michelkeijzers/FuzzTester2/FreeCad/PedalSwitch/images/dd879e173b59c8a97e29d3d8e20ef851_preview_featured.jpg

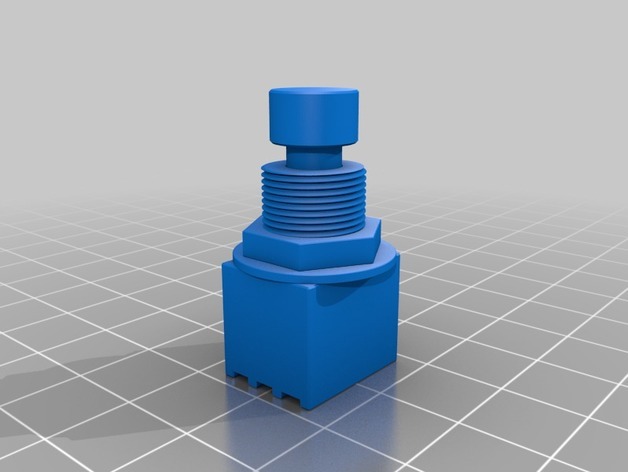
FreeCad/PedalSwitch/images/dd879e173b59c8a97e29d3d8e20ef851_preview_featured.jpg
