michelkeijzers/FuzzTester2/FreeCad/PedalSwitch/README.txt

                   .:                     :,                                          
,:::::::: ::`      :::                   :::                                          
,:::::::: ::`      :::                   :::                                          
.,,:::,,, ::`.:,   ... .. .:,     .:. ..`... ..`   ..   .:,    .. ::  .::,     .:,`   
   ,::    :::::::  ::, :::::::  `:::::::.,:: :::  ::: .::::::  ::::: ::::::  .::::::  
   ,::    :::::::: ::, :::::::: ::::::::.,:: :::  ::: :::,:::, ::::: ::::::, :::::::: 
   ,::    :::  ::: ::, :::  :::`::.  :::.,::  ::,`::`:::   ::: :::  `::,`   :::   ::: 
   ,::    ::.  ::: ::, ::`  :::.::    ::.,::  :::::: ::::::::: ::`   :::::: ::::::::: 
   ,::    ::.  ::: ::, ::`  :::.::    ::.,::  .::::: ::::::::: ::`    ::::::::::::::: 
   ,::    ::.  ::: ::, ::`  ::: ::: `:::.,::   ::::  :::`  ,,, ::`  .::  :::.::.  ,,, 
   ,::    ::.  ::: ::, ::`  ::: ::::::::.,::   ::::   :::::::` ::`   ::::::: :::::::. 
   ,::    ::.  ::: ::, ::`  :::  :::::::`,::    ::.    :::::`  ::`   ::::::   :::::.  
                                ::,  ,::                               ``             
                                ::::::::                                              
                                 ::::::                                               
                                  `,,`

http://www.thingiverse.com/thing:2292921
True Bypass pedal switch  by TwistedStick is licensed under the Creative Commons - Attribution license.
http://creativecommons.org/licenses/by/3.0/

# Summary

Full scale model of a True Bypass type foot switch as used in lots of guitar effects pedals. The first file prints as 1 piece.
