michelkeijzers/FuzzTester2/FreeCad/AlphaPots/Renderings/456654.JPG

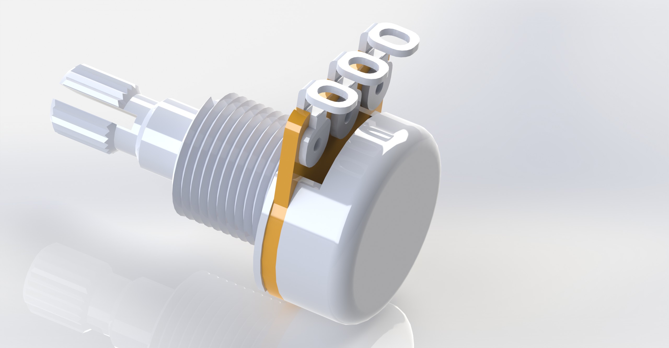
FreeCad/AlphaPots/Renderings/456654.JPG
