michelkeijzers/FuzzTester2/FreeCad/AlphaPots/Renderings/POTENCIOMETRO.JPG

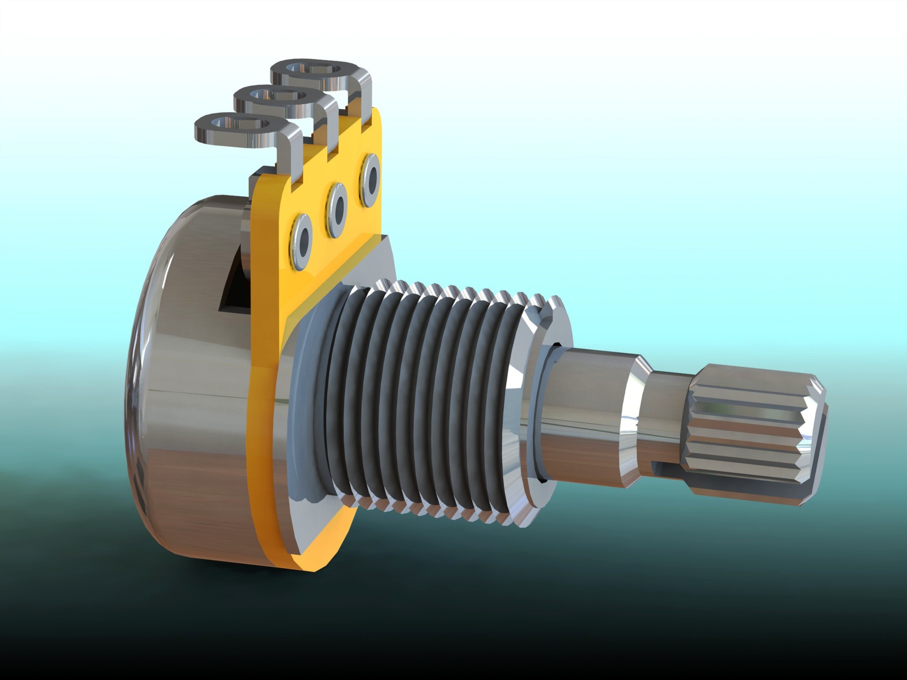
FreeCad/AlphaPots/Renderings/POTENCIOMETRO.JPG
