michelkeijzers/FuzzTester2/FreeCad/PedalSwitch/images/05e3b247a3be7e0a02b4cb6af5f122b1_preview_featured.jpg

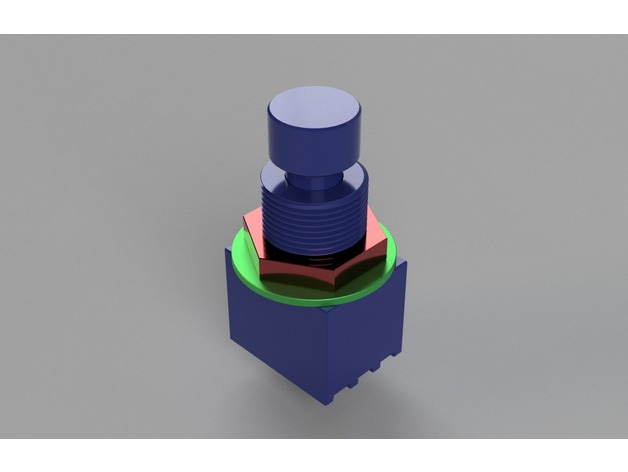
FreeCad/PedalSwitch/images/05e3b247a3be7e0a02b4cb6af5f122b1_preview_featured.jpg
