michelkeijzers/FuzzTester2/FreeCad/PedalSwitch/images/3989a1540667a814e102567b238ad827_preview_featured.jpg

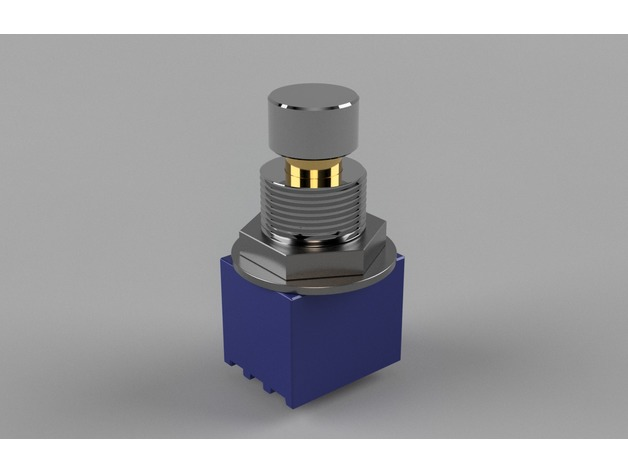
FreeCad/PedalSwitch/images/3989a1540667a814e102567b238ad827_preview_featured.jpg
