michelkeijzers/FuzzTester2/FreeCad/PedalSwitch/images/55707fd7501c3c675dcfab593f32f3b3_preview_featured.jpg

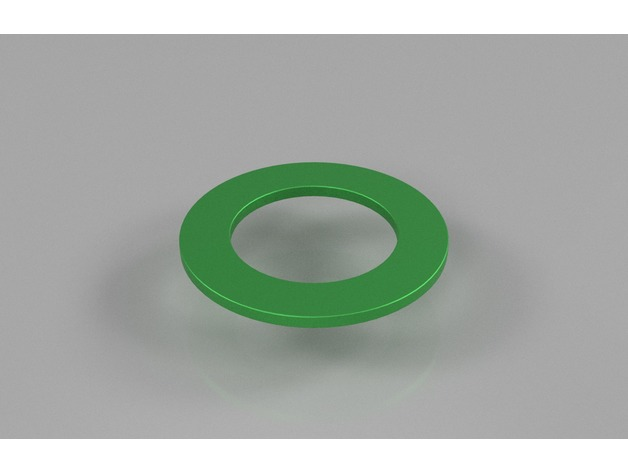
FreeCad/PedalSwitch/images/55707fd7501c3c675dcfab593f32f3b3_preview_featured.jpg
