michelkeijzers/FuzzTester2/FreeCad/PedalSwitch/images/a3924953580c51a55e30400ac69dec9f_preview_featured.jpg

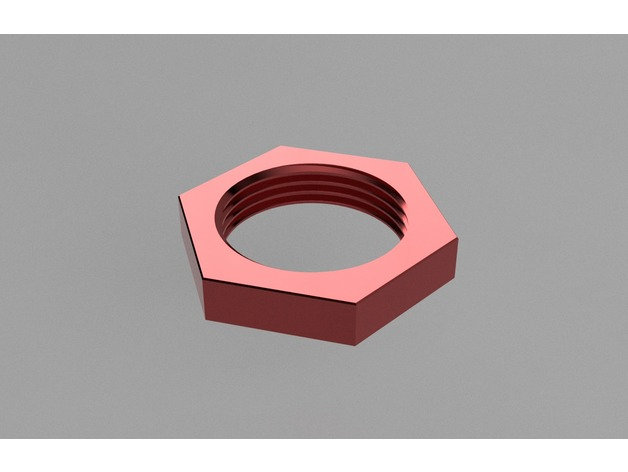
FreeCad/PedalSwitch/images/a3924953580c51a55e30400ac69dec9f_preview_featured.jpg
