michelkeijzers/FuzzTester2/FreeCad/PedalSwitch/images/c648ea8e05c5eb92dedfe1f4923e9194_preview_featured.jpg

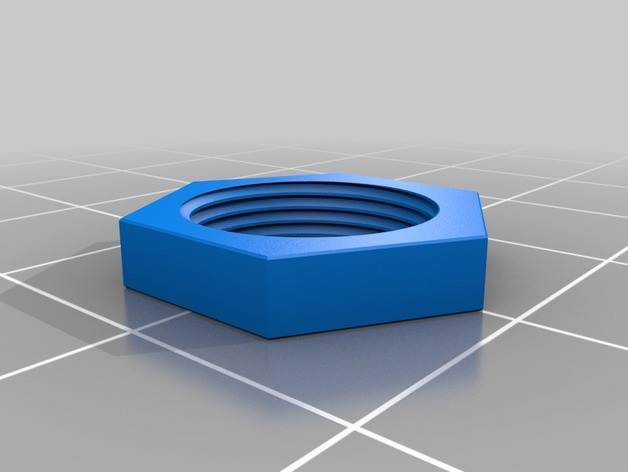
FreeCad/PedalSwitch/images/c648ea8e05c5eb92dedfe1f4923e9194_preview_featured.jpg
