michelkeijzers/FuzzTester2/FreeCad/PedalSwitch/images/ecceebd9bc1541b14651f7d918a18b3a_preview_featured.jpg

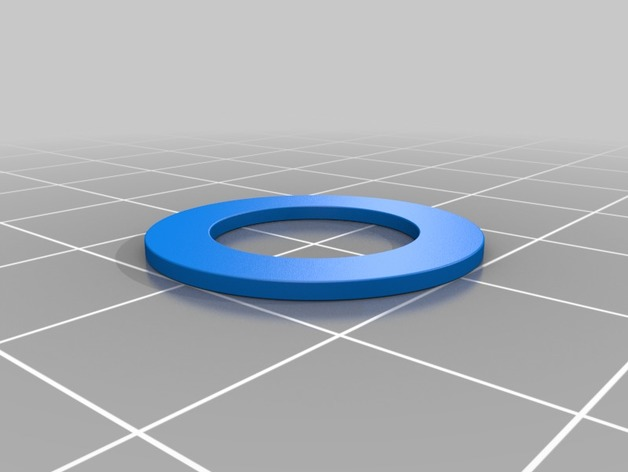
FreeCad/PedalSwitch/images/ecceebd9bc1541b14651f7d918a18b3a_preview_featured.jpg
