michelkeijzers/FuzzTester2/FreeCad/Square Push Buttons.jpg

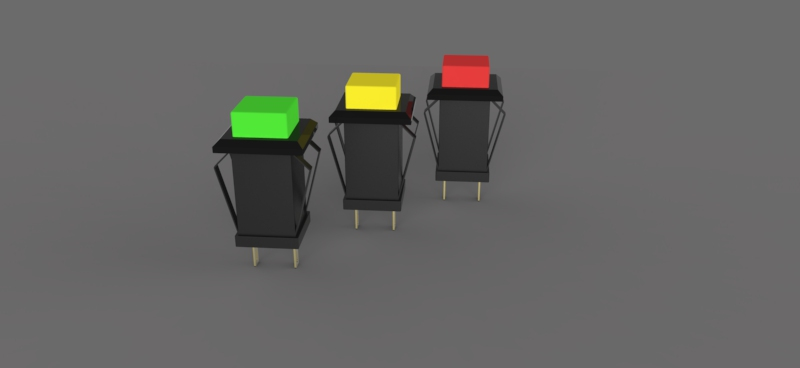
FreeCad/Square Push Buttons.jpg
