michelkeijzers/FuzzTester2/FreeCad/STM32F103C8T6 Black Pill/STM32F103C8T6 Black Pill Technical drawing.png

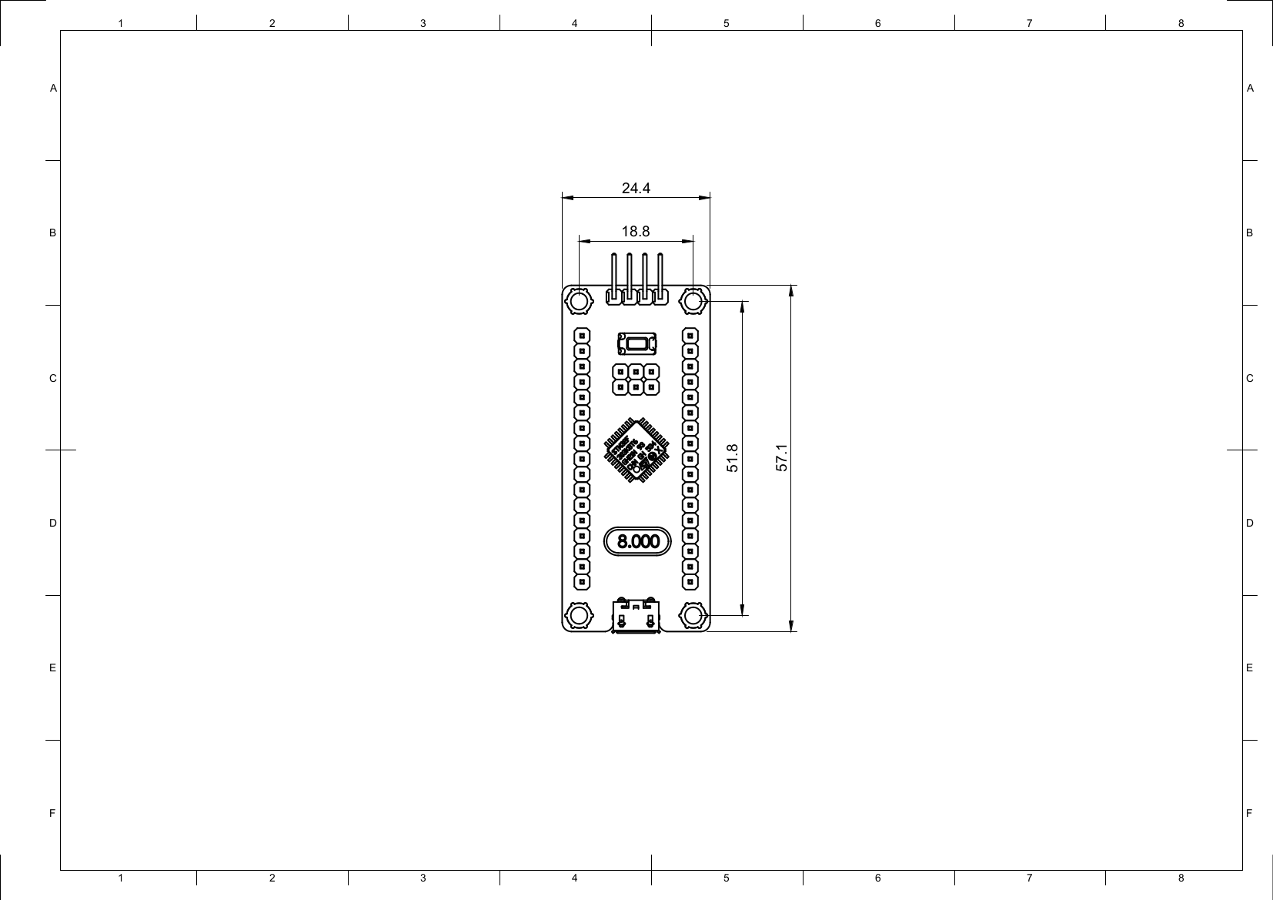
FreeCad/STM32F103C8T6 Black Pill/STM32F103C8T6 Black Pill Technical drawing.png
