michelkeijzers/FuzzTester2/FreeCad/dc-power-supply-panel-mount-jack-2-1mm-x-5-5mm-1.snapshot.6/DC Jack Panel Mount ASSY.STEP

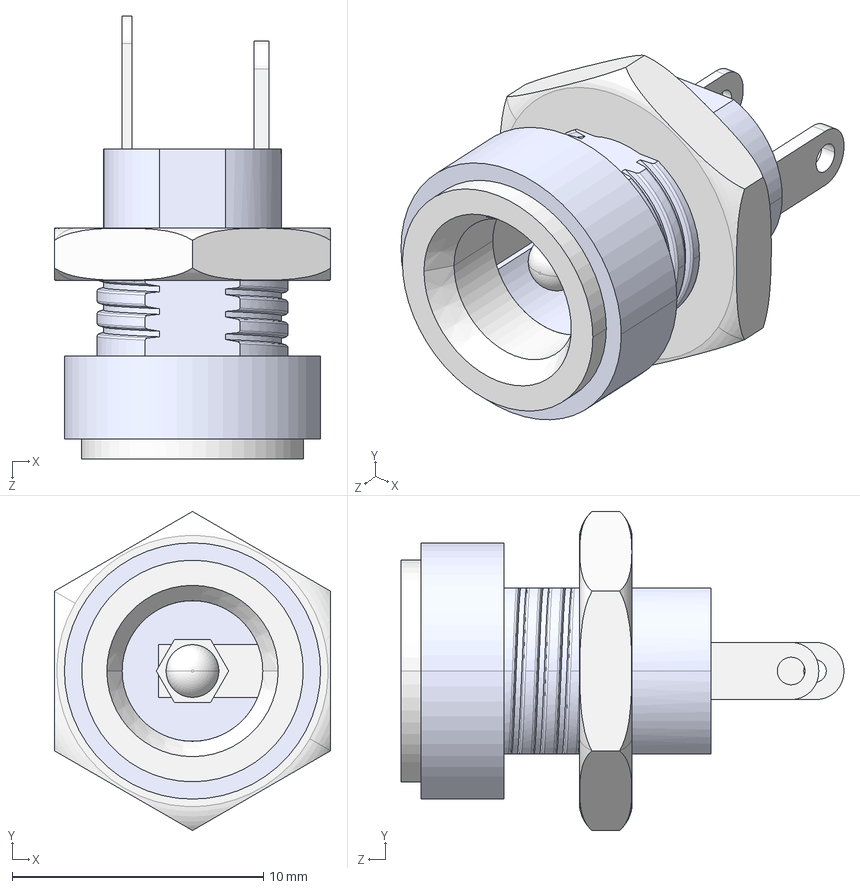
[picture p34: CAD file, 2020-05-08]
FreeCad/dc-power-supply-panel-mount-jack-2-1mm-x-5-5mm-1.snapshot.6/DC Jack Panel Mount ASSY.STEP
11.0 x 12.7 x 17.6 mm
DC Jack Panel Mount Base
DC Jack Panel Mount Nut
