michelkeijzers/FuzzTester2/FreeCad/PedalSwitch/files/truBypass-main-to_print.stl

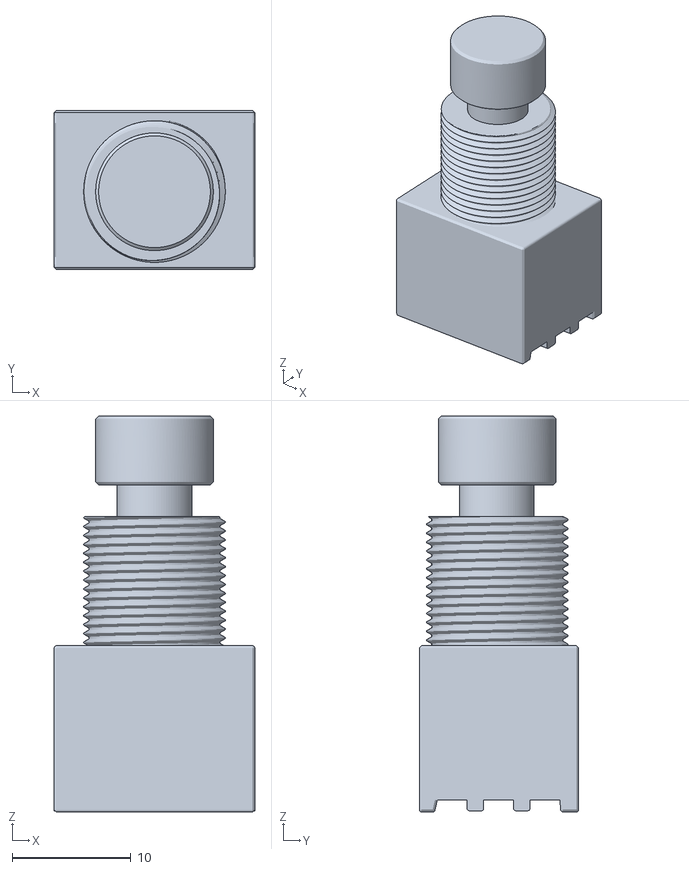
[picture p35: CAD file, 2020-05-08]
FreeCad/PedalSwitch/files/truBypass-main-to_print.stl
16.9 x 13.4 x 33.3
