michelkeijzers/FuzzTester2/FreeCad/wh148Pot/Assem1.SLDASM

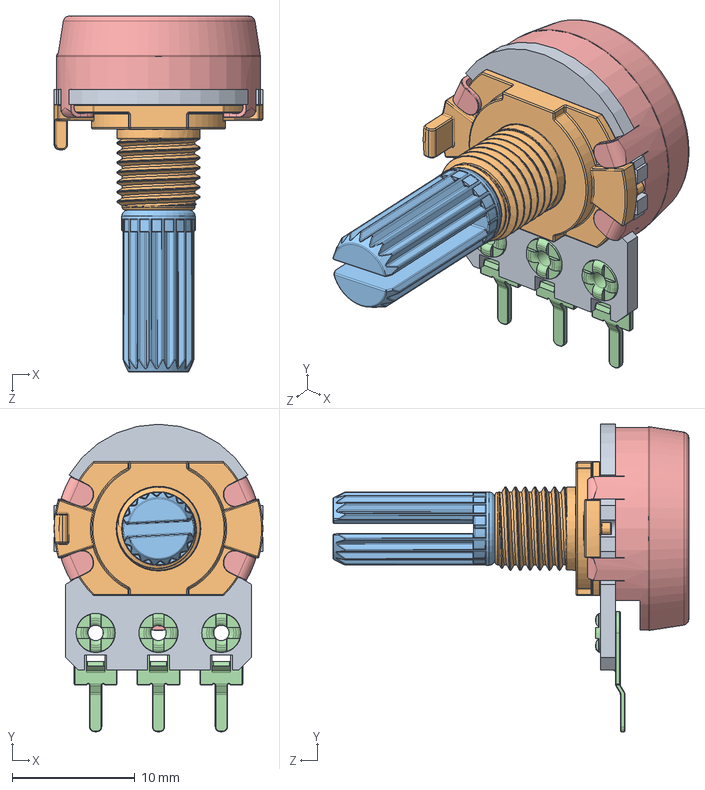
[picture p36: CAD file, 2020-05-08]
FreeCad/wh148Pot/Assem1.SLDASM
17.0 x 25.1 x 29.0 mm
pcb board
base metal
rotating rod metal
pin x 3
sheild metal
plastic base
