michelkeijzers/FuzzTester2/FreeCad/User Library-Jack6_3 Asm.STEP

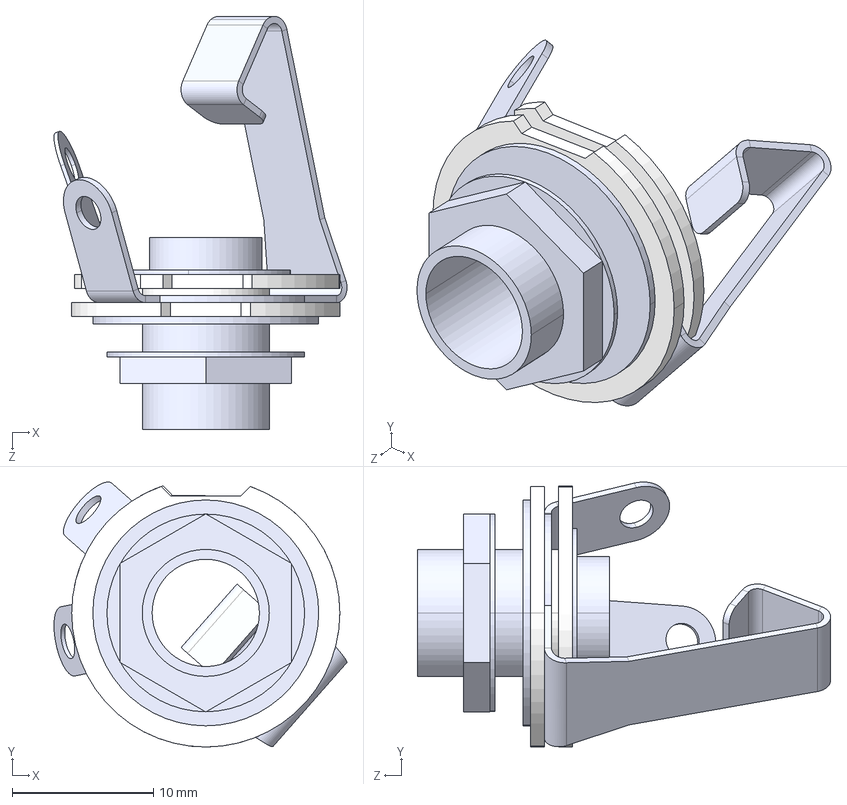
[picture p37: CAD file, 2020-05-08]
FreeCad/User Library-Jack6_3 Asm.STEP
20.8 x 18.8 x 29.3 mm
Jack6.3body___ _________
Washer0___ _________
OuterWasher___ _________
Nut___ _________
Washer1___ _________
Washer2___ _________
CentralContact___ _________
GroundContact___ _________
