michelkeijzers/FuzzTester2/FreeCad/1590C.stp

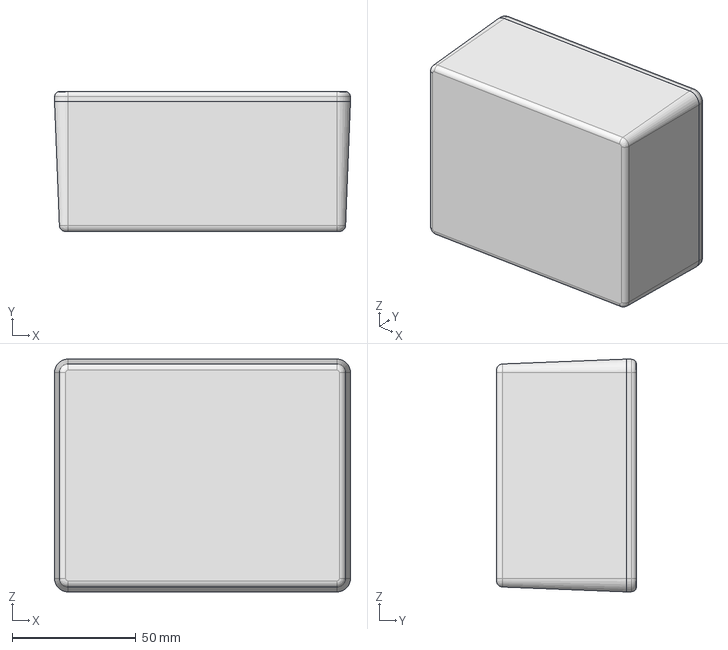
[picture p38: CAD file, 2020-05-08]
FreeCad/1590C.stp
119.5 x 56.5 x 94.0 mm
