michelkeijzers/FuzzTester2/FreeCad/AlphaPots/Stereo_Pot.IGS

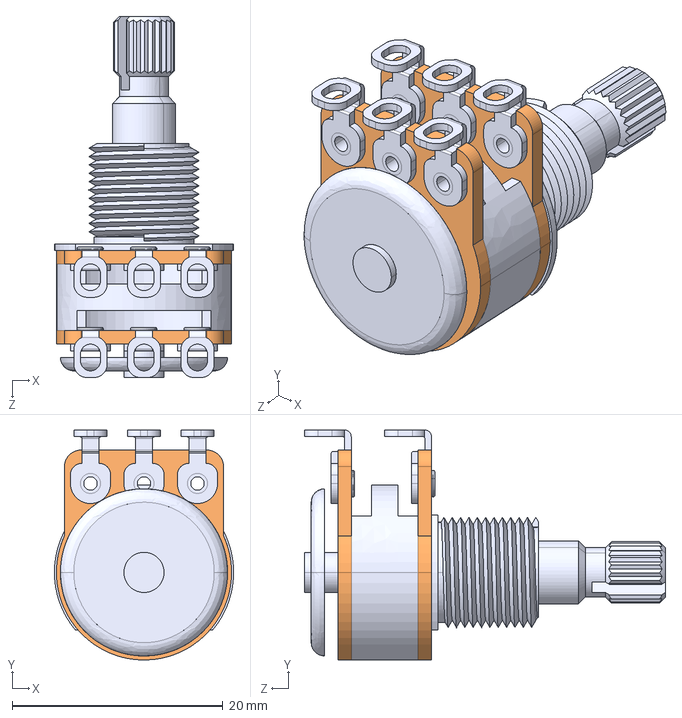
[picture p39: CAD file, 2020-05-08]
FreeCad/AlphaPots/Stereo_Pot.IGS
17.0 x 21.8 x 34.3 mm
