michelkeijzers/FuzzTester2/FreeCad/lcm1602c-lcd-display-16x2-1.snapshot.8/lcm1602c.SLDPRT

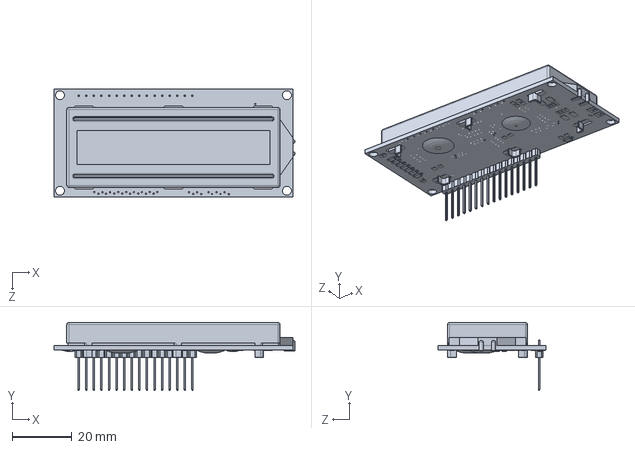
[picture p40: CAD file, 2020-05-08]
FreeCad/lcm1602c-lcd-display-16x2-1.snapshot.8/lcm1602c.SLDPRT
80.7 x 22.8 x 36.0 mm
