michelkeijzers/FuzzTester2/FreeCad/potmeterknob/Knob.step

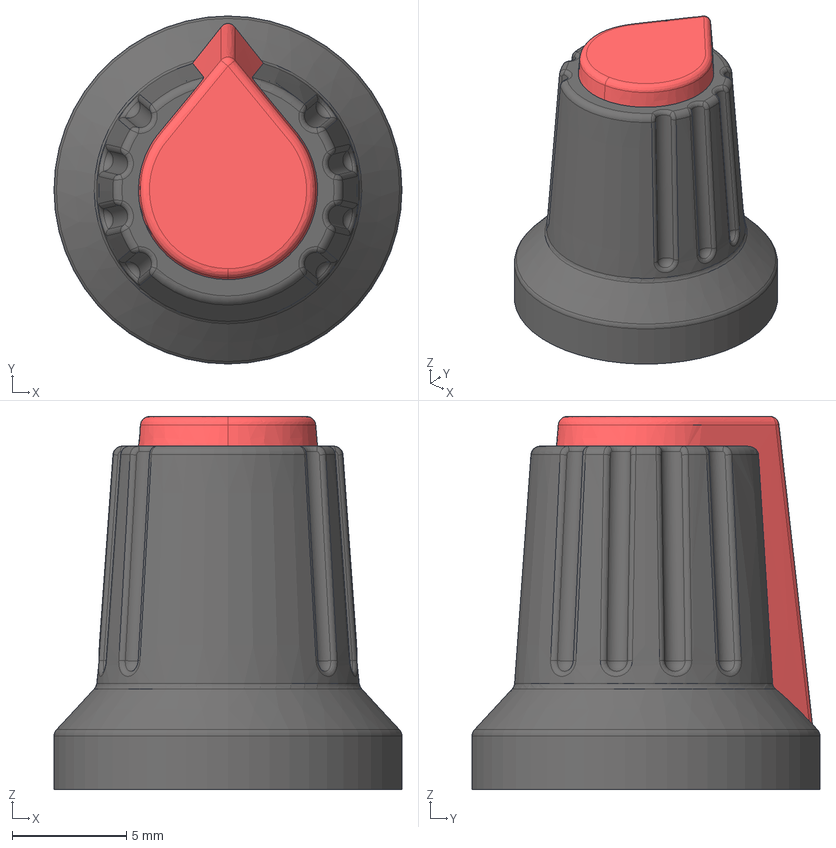
[picture p41: CAD file, 2020-05-08]
FreeCad/potmeterknob/Knob.step
15.2 x 15.2 x 16.3 mm
Rouge
Extérieur
