michelkeijzers/FuzzTester2/FreeCad/wh148Pot/plastic base.SLDPRT

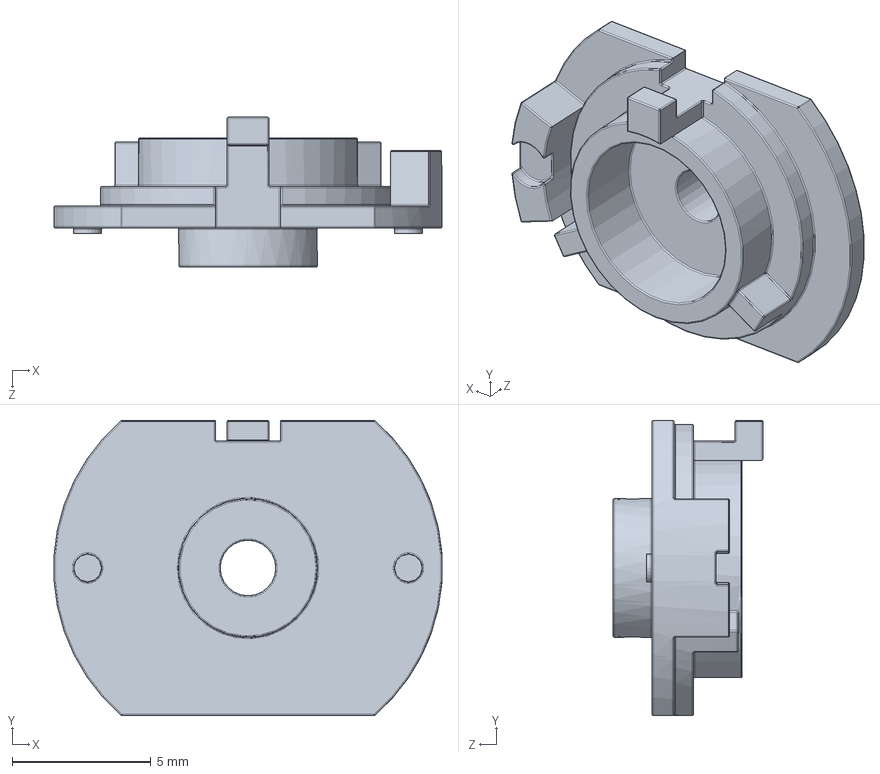
[picture p42: CAD file, 2020-05-08]
FreeCad/wh148Pot/plastic base.SLDPRT
14.0 x 10.6 x 5.40 mm
