michelkeijzers/FuzzTester2/FreeCad/AlphaPots/Switch_Pot_Small_Shaft.IGS

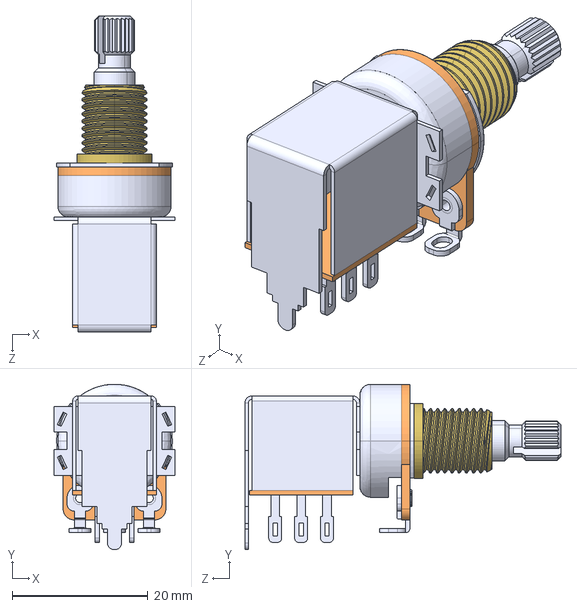
[picture p43: CAD file, 2020-05-08]
FreeCad/AlphaPots/Switch_Pot_Small_Shaft.IGS
17.8 x 24.3 x 46.5 mm
