michelkeijzers/FuzzTester2/FreeCad/dc-power-supply-panel-mount-jack-2-1mm-x-5-5mm-1.snapshot.6/DC Jack Panel Mount Base.SLDPRT

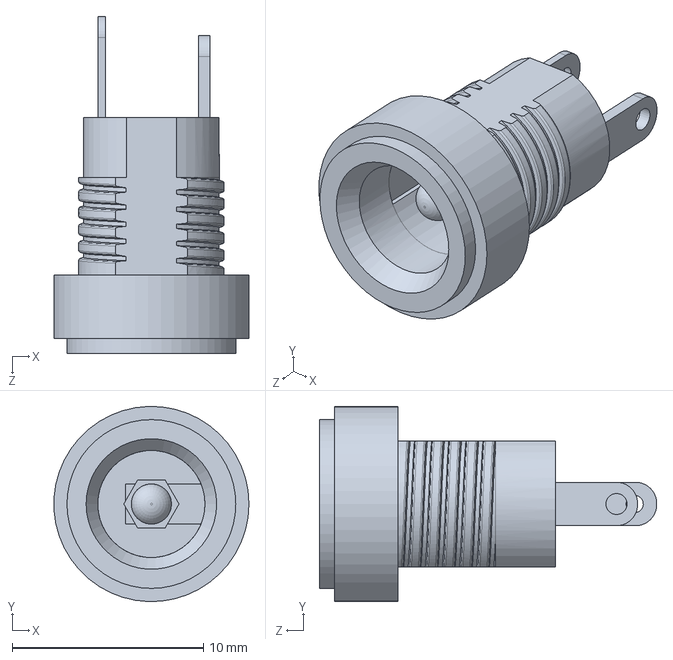
[picture p44: CAD file, 2020-05-08]
FreeCad/dc-power-supply-panel-mount-jack-2-1mm-x-5-5mm-1.snapshot.6/DC Jack Panel Mount Base.SLDPRT
10.2 x 10.2 x 17.6 mm
