michelkeijzers/FuzzTester2/FreeCad/Push button square.SLDPRT

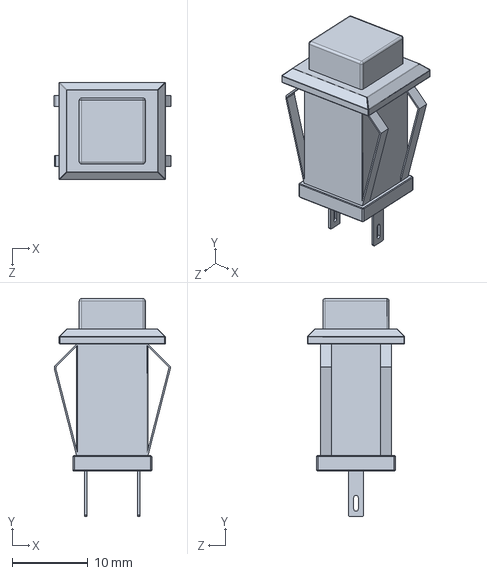
[picture p45: CAD file, 2020-05-08]
FreeCad/Push button square.SLDPRT
15.3 x 28.7 x 12.8 mm
