michelkeijzers/FuzzTester2/FreeCad/AlphaPots/Single_Pot.IGS

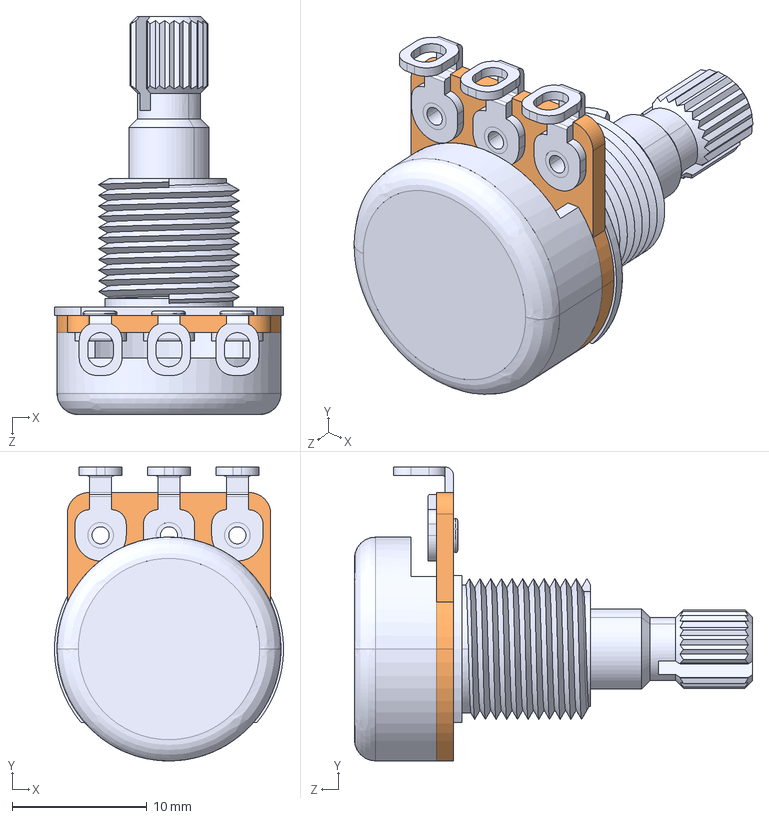
[picture p46: CAD file, 2020-05-08]
FreeCad/AlphaPots/Single_Pot.IGS
17.0 x 21.8 x 29.6 mm
