michelkeijzers/FuzzTester2/FreeCad/PedalSwitch/files/truBypass-to_print.stl

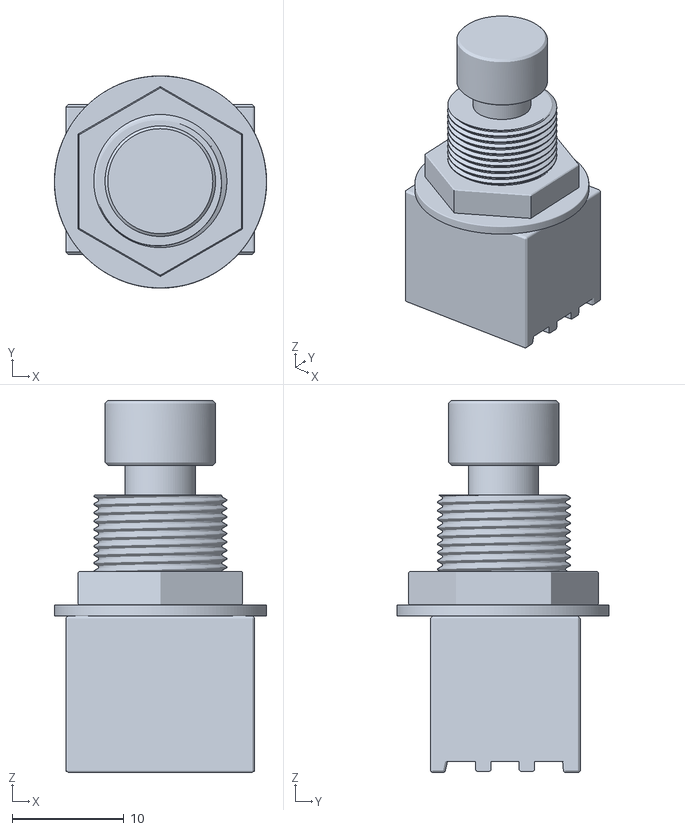
[picture p47: CAD file, 2020-05-08]
FreeCad/PedalSwitch/files/truBypass-to_print.stl
19.0 x 19.0 x 33.3
