michelkeijzers/FuzzTester2/FreeCad/wh148Pot/pcb board.SLDPRT

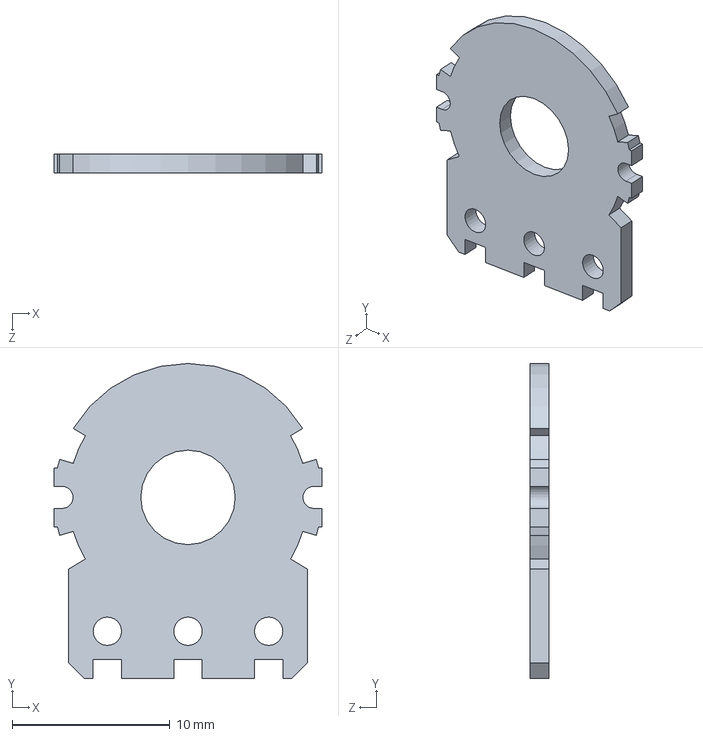
[picture p48: CAD file, 2020-05-08]
FreeCad/wh148Pot/pcb board.SLDPRT
17.0 x 20.0 x 1.20 mm
