michelkeijzers/FuzzTester2/FreeCad/KS11R22CQD.step

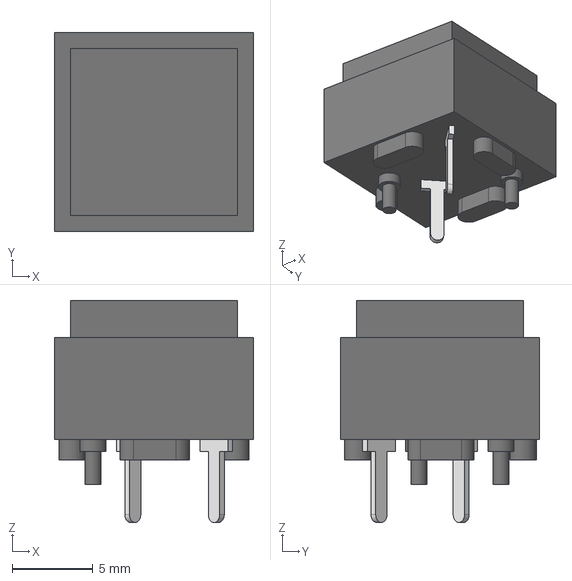
[picture p49: CAD file, 2020-05-08]
FreeCad/KS11R22CQD.step
12.3 x 12.3 x 13.7 mm
