michelkeijzers/FuzzTester2/FreeCad/wh148Pot/sheild metal.SLDPRT

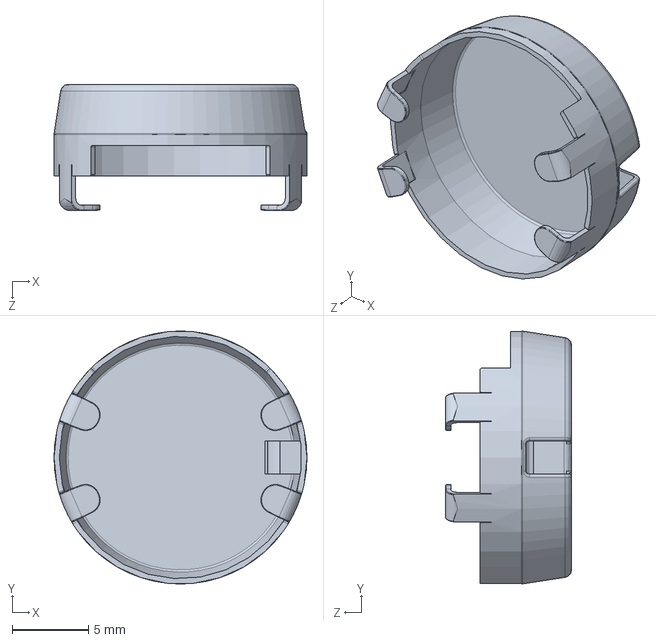
[picture p50: CAD file, 2020-05-08]
FreeCad/wh148Pot/sheild metal.SLDPRT
16.6 x 16.6 x 8.28 mm
