michelkeijzers/FuzzTester2/FreeCad/wh148Pot/base metal.SLDPRT

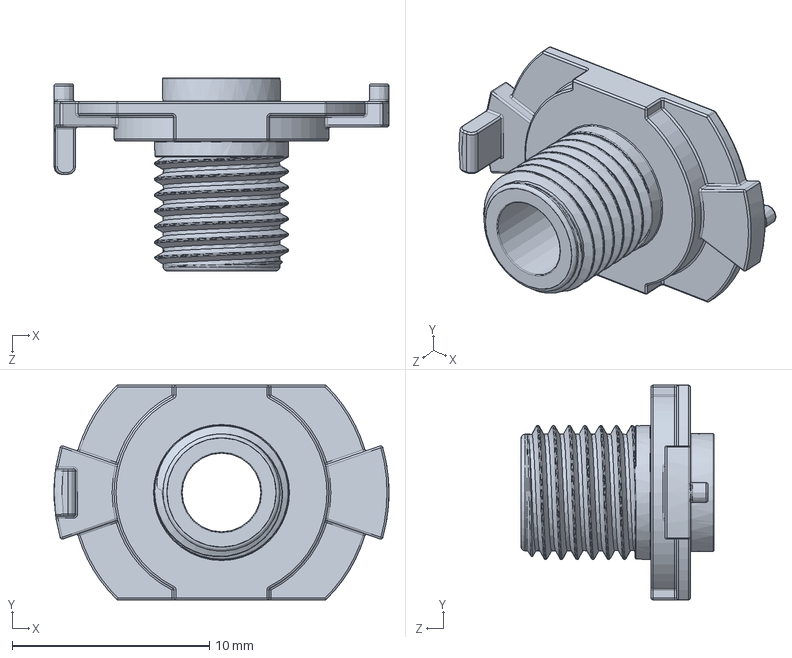
[picture p51: CAD file, 2020-05-08]
FreeCad/wh148Pot/base metal.SLDPRT
17.0 x 10.9 x 9.80 mm
