michelkeijzers/FuzzTester2/FreeCad/wh148Pot/rotating rod metal.SLDPRT

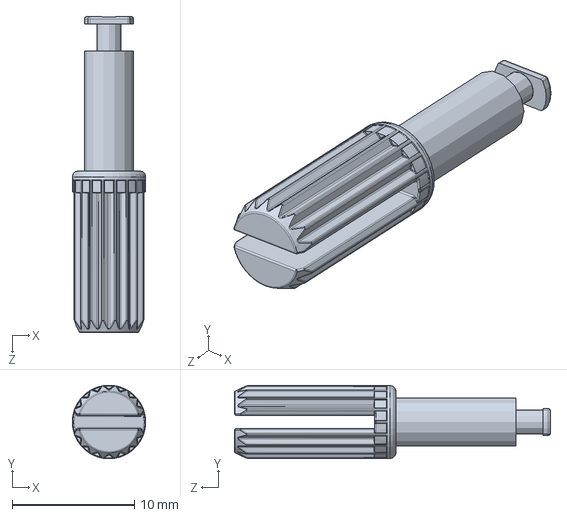
[picture p52: CAD file, 2020-05-08]
FreeCad/wh148Pot/rotating rod metal.SLDPRT
6.00 x 6.00 x 25.8 mm
