michelkeijzers/FuzzTester2/FreeCad/wh148Pot/pin.SLDPRT

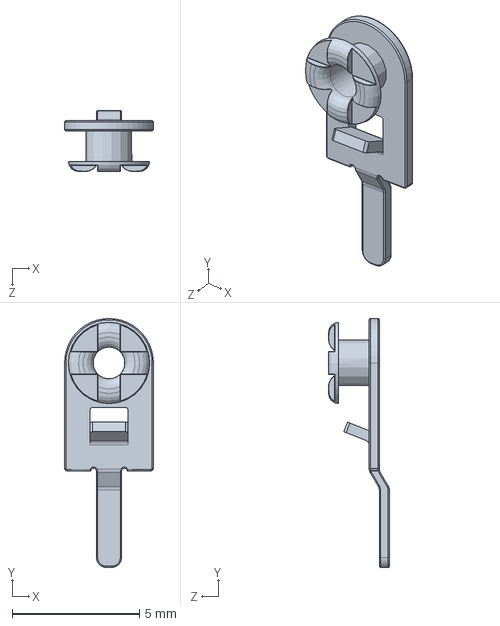
[picture p53: CAD file, 2020-05-08]
FreeCad/wh148Pot/pin.SLDPRT
3.50 x 9.80 x 2.40 mm
