michelkeijzers/FuzzTester2/(list of files, cad)

Other CAD files:
FreeCad/1590C.igs
FreeCad/PedalSwitch/files/truBypass-nut-to_print.stl
FreeCad/PedalSwitch/files/truBypass-washer-to_print.stl
FreeCad/User Library-Jack6_3 Asm.IGS
FreeCad/dc-power-supply-panel-mount-jack-2-1mm-x-5-5mm-1.snapshot.6/DC Jack Panel Mount ASSY.SLDASM
FreeCad/dc-power-supply-panel-mount-jack-2-1mm-x-5-5mm-1.snapshot.6/DC Jack Panel Mount ASSY.SLDPRT
FreeCad/dc-power-supply-panel-mount-jack-2-1mm-x-5-5mm-1.snapshot.6/DC Jack Panel Mount Nut.SLDPRT
FreeCad/potmeterknob/Knob.f3d
FreeCad/potmeterknob/Knob.iges
