michelkeijzers/FuzzTester2/FuzzTester2/Core/TODO.txt

Critical bugs/problems
----------------------
- LCD bug: LCD stops during startup (I2C Initialization problem, see Github, question asked at electronics.stack.exchange).

Nice to have
----
- Button: Swap subscriber index and debounce time
- LCD improvement: only send changed characters (copy characters from display in array, costs 4x20 = 80 bytes max), but goto-xy also takes time
