michelkeijzers/FuzzTester2/MicroCap/Fuzz 1000 Faces Original Simple 2.cir

[Main]
FileType=CIR
Version=12.00
Program=Micro-Cap
Component Version=10.00
Shape Version=11.00
Screen=1920,1200
MCAPVersion=12.2.0.3
Key ID=Demo
NLCnt=60
TXCnt=0

[shapedef]
Name=Animated SPST Switch
Animated SPST Switch=0,-8,48,8
Current=16,8,32,8

[shapedef]
Name=Battery
Line=0,0,22,0
Line=22,-3,22,3
Line=26,-7,26,7
Line=26,0,48,0
Current=32,8,16,8

[shapedef]
Name=Bjt.root
Line=0,0,13,0
Rectangle=13,-12,15,12
Current=32,-24,32,-16
Current=32,24,32,16
Current=0,-8,8,-8
PolyOpen=3
PolyLine=24,-24
PolyLine=24,-12
PolyLine=14,-2
PolyOpen=3
PolyLine=24,24
PolyLine=24,12
PolyLine=14,2

[shapedef]
Name=Capacitor
Line=0,0,22,0
Line=22,-8,22,8
Line=26,-8,26,8
Line=26,0,48,0
Current=32,12,16,12

[shapedef]
Name=Ground
Line=0,0,12,0
Line=12,-8,12,8
Line=18,-4,18,4
Line=24,0,24,0

[shapedef]
Name=NPN
Root="Bjt.root",0,0,0
PolyClosed=3
PolyLine=20,12
PolyLine=24,12
PolyLine=24,8

[shapedef]
Name=Plus.root
Line=-2,0,2,0
Line=0,-2,0,2

[shapedef]
Name=Pot
Line=0,0,12,0
Line=12,0,14,-4
Line=14,-4,18,4
Line=18,4,22,-4
Line=22,-4,26,4
Line=26,4,30,-4
Line=30,-4,34,4
Line=34,4,36,0
Line=36,0,48,0
PolyClosed=4
PolyLine=24,4
PolyLine=24,4
PolyLine=22,8
PolyLine=26,8
Line=24,8,24,16

[shapedef]
Name=Resistor
PolyOpen=12
PolyLine=0,0
PolyLine=0,0
PolyLine=12,0
PolyLine=14,-4
PolyLine=18,4
PolyLine=22,-4
PolyLine=26,4
PolyLine=30,-4
PolyLine=34,4
PolyLine=36,0
PolyLine=48,0
PolyLine=48,0
Current=32,8,16,8

[shapedef]
Name=Sine_Source
Root="Vsource.root",0,0,0
Line=24,-6,26,-4
Line=26,-4,26,-2
Line=26,-2,22,2
Line=22,2,22,4
Line=22,4,24,6

[shapedef]
Name=Vsource.root
Line=0,0,12,0
Line=36,0,48,0
Ellipse=12,-12,36,12
FColor=None
Line=7,5,7,9
Root="Plus.root",41,7,0
Current=32,16,16,16

[compdef]
Name=Sine Source
Definition=Sine source
Shape=Sine_Source
Mask=4864
memo=Sine Source
Label Offset=18,12,15,12
PinCnt=2
Pin="Plus",6,0,-6,-6
Pin="Minus",0,0,-19,-6

[compdef]
Name=Capacitor
Definition=Capacitor
Shape=Capacitor
Mask=7425
Used=62
memo=Capacitor
Label Offset=16,12,12,12
PinCnt=2
Pin="Plus",6,0,-3,-5
Pin="Minus",0,0,-14,-5

[compdef]
Name=NPN
Definition=NPN
Shape=NPN
Mask=5633
Used=62
memo=NPN Transistor
Label Offset=37,-17,-14,33
PinCnt=3
Pin="Collector",3,-3,4,14
Pin="Base",0,0,-18,-3
Pin="Emitter",3,3,5,1

[compdef]
Name=Resistor
Definition=Resistor
Shape=Resistor
Mask=6913
Used=152
memo=Resistor
Label Offset=18,6,8,11
PinCnt=2
Pin="Plus",6,0,-10,-4
Pin="Minus",0,0,-14,-4

[compdef]
Name=Pot
Definition=Macro
Shape=Pot
Mask=4096
Used=6
memo=Potentiometer Macro
Label Offset=32,4,9,11
PinCnt=3
Pin="PINA",a,0,0,-13,-5
Pin="PINB",a,3,2,6,5
Pin="PINC",a,6,0,-12,-5

[compdef]
Name=Ground
Definition=Ground
Shape=Ground
Mask=1793
Used=263
memo=Ground
Label Offset=0,0,0,0
PinCnt=1
Pin="PinA",0,0,-3,-7

[compdef]
Name=Battery
Definition=Battery
Shape=Battery
Mask=6145
Used=52
memo=Battery
Label Offset=19,7,10,13
PinCnt=2
Pin="Plus",6,0,-4,-5
Pin="Minus",0,0,-10,-5

[compdef]
Name=Animated SPST Switch
Definition=ANIMATED SPST SWITCH
Shape=Animated SPST Switch
Mask=5888
Used=178
memo=Animated Single Pole, Single Throw Switch
Label Offset=2,5,11,11
PinCnt=2
Pin="A",0,0,5,0
Pin="B",6,0,-10,1

[Circuit]
Window Placement=2,3, -1,-1, -8,-31, 104,104,1507,758
Default Object=Color=#000080
Default Object Font=Height=-15,FStyle=0,Color=#000080,Name=Arial
Default Object Apply Border To Text=No
Default Object Apply Fill To Text=No
Default Object GridSnap=No
NodeVoltageFormat=3
CurrentFormat=3
PowerFormat=3
PathDelayFormat=3
WarningFormat=3
GridTextFormulaFormat=3
Window Placement in Transient Analysis=0,1, -1,-1, -8,-31, 20,0,1875,946
Window Placement in AC Analysis=2,3, -1,-1, -8,-31, 156,156,1755,810
SpiceType=AMBIGUOUS
Title_Block_Border=None
Title_Block=False
Show Nodes=True
Show Voltages=True
Show Current=False
Show Power=False
Show Condition=False
Show Pin Connections=True
Show Connection Warnings=False
Show Cross=False
Show Attribute Text=True
Show Grid Text=False

[Comp]
Name=Sine Source
Px=104,432
Rot=3
COff=8,73,406,-33,-58

[Attr]
ON=-31,-26,PART
V=V3
Style=8192

[Attr]
ON=-48,-40,MODEL
V=60HZ

[Attr]
ON=0,0,PACKAGE
V

[Comp]
Name=Capacitor
Px=232,376
Rot=6

[Attr]
ON=-33,12,PART
V=C1
Style=8192

[Attr]
ON=-39,26,CAPACITANCE
V=1uF
Style=8192

[Attr]
ON=0,0,PACKAGE
V

[Comp]
Name=NPN
Px=376,376

[Attr]
ON=37,-17,PART
V=Q3
Style=8192

[Attr]
ON=37,-3,MODEL
V=2n2222a

[Attr]
ON=37,25,PACKAGE
V=TO-18

[Comp]
Name=Resistor
Px=544,336
Rot=3

[Attr]
ON=-24,-25,PART
V=R3
Style=8192

[Attr]
ON=-37,-40,RESISTANCE
V=100K
Style=8192

[Attr]
ON=0,0,PACKAGE
V

[Comp]
Name=Resistor
Px=808,328
Rot=3

[Attr]
ON=-24,-25,PART
V=R4
Style=8192

[Attr]
ON=-40,-40,RESISTANCE
V=10K
Style=8192

[Attr]
ON=0,0,PACKAGE
V

[Comp]
Name=Resistor
Px=448,424
Rot=4

[Attr]
ON=18,-20,PART
V=R8
Style=8192

[Attr]
ON=18,-34,RESISTANCE
V=100K
Style=8192

[Attr]
ON=0,0,PACKAGE
V

[Comp]
Name=Pot
Px=736,472
Rot=3

[Attr]
ON=28,-43,PART
V=X2
Style=8192

[Attr]
ON=32,18,FILE
V=Pot

[Attr]
ON=32,46,Param:POTSIZE
V=5K

[Attr]
ON=32,60,Param:PERCENT
V=80

[Attr]
ON=0,0,PACKAGE
V

[Comp]
Name=Pot
Px=648,472
Rot=3

[Attr]
ON=28,-43,PART
V=X3
Style=8192

[Attr]
ON=32,18,FILE
V=Pot

[Attr]
ON=32,46,Param:POTSIZE
V=10K

[Attr]
ON=32,60,Param:PERCENT
V=40

[Attr]
ON=0,0,PACKAGE
V

[Comp]
Name=Ground
Px=648,520
Rot=7

[Comp]
Name=Pot
Px=960,416
Rot=3

[Attr]
ON=31,-63,PART
V=X4
Style=8192

[Attr]
ON=32,18,FILE
V=Pot

[Attr]
ON=32,46,Param:POTSIZE
V=100K

[Attr]
ON=32,60,Param:PERCENT
V=50

[Attr]
ON=0,0,PACKAGE
V

[Wire]
Pxs=104,376,104,384

[Wire]
Pxs=304,424,448,424

[Wire]
Pxs=496,424,648,424

[Wire]
Pxs=680,424,736,424

[Wire]
Pxs=400,520,648,520

[Wire]
Pxs=648,472,648,520

[Wire]
Pxs=400,400,400,520

[Comp]
Name=Battery
Px=640,232
Rot=1

[Attr]
ON=19,7,PART
V=V4
Style=8192

[Attr]
ON=19,21,VALUE
V=9V
Style=8192

[Attr]
ON=0,0,PACKAGE
V

[Wire]
Pxs=544,280,640,280

[Wire]
Pxs=544,280,544,288

[Wire]
Pxs=640,280,808,280

[Wire]
Pxs=544,336,544,352

[Wire]
Pxs=648,376,648,424

[Wire]
Pxs=648,520,736,520

[Comp]
Name=Capacitor
Px=736,472
Rot=1

[Attr]
ON=-38,15,PART
V=C3
Style=8192

[Attr]
ON=-39,40,CAPACITANCE
V=22uF
Style=8192

[Attr]
ON=0,0,PACKAGE
V

[Wire]
Pxs=976,392,1008,392

[Wire]
Pxs=680,424,680,448

[Wire]
Pxs=736,424,768,424

[Wire]
Pxs=768,424,768,448

[Comp]
Name=Ground
Px=608,232
Rot=7

[Wire]
Pxs=608,232,640,232

[Comp]
Name=Animated SPST Switch
Px=352,376
Rot=6

[Attr]
ON=-37,9,PART
V=Switch8
Style=8192

[Attr]
ON=-36,19,STATE
V=Closed

[Attr]
ON=-21,33,RON
V=1m

[Attr]
ON=-34,47,ROFF
V=1e15

[Attr]
ON=0,0,PACKAGE
V

[Wire]
Pxs=352,376,376,376

[Wire]
Pxs=504,352,544,352

[Comp]
Name=Animated SPST Switch
Px=504,352
Rot=6

[Attr]
ON=-37,9,PART
V=Switch12
Style=8192

[Attr]
ON=-36,19,STATE
V=Closed

[Attr]
ON=-21,33,RON
V=1m

[Attr]
ON=-34,47,ROFF
V=1e15

[Attr]
ON=0,0,PACKAGE
V

[Wire]
Pxs=400,352,456,352

[Wire]
Pxs=752,448,768,448

[Wire]
Pxs=664,448,680,448

[Wire]
Pxs=304,376,304,424

[Comp]
Name=Animated SPST Switch
Px=280,376
Rot=6

[Attr]
ON=-51,5,PART
V=Switch17
Style=8192

[Attr]
ON=-36,19,STATE
V=Closed

[Attr]
ON=-21,33,RON
V=1m

[Attr]
ON=-34,47,ROFF
V=1e15

[Attr]
ON=0,0,PACKAGE
V

[Comp]
Name=Animated SPST Switch
Px=184,376
Rot=6

[Attr]
ON=-51,5,PART
V=Switch19
Style=8192

[Attr]
ON=-36,19,STATE
V=Closed

[Attr]
ON=-21,33,RON
V=1m

[Attr]
ON=-34,47,ROFF
V=1e15

[Attr]
ON=0,0,PACKAGE
V

[Wire]
Pxs=104,376,136,376

[Wire]
Pxs=280,376,304,376

[Comp]
Name=Capacitor
Px=904,328
Rot=6

[Attr]
ON=-33,12,PART
V=C12
Style=8192

[Attr]
ON=-39,26,CAPACITANCE
V=1uF
Style=8192

[Attr]
ON=0,0,PACKAGE
V

[Comp]
Name=Animated SPST Switch
Px=952,328
Rot=6

[Attr]
ON=-51,5,PART
V=Switch83
Style=8192

[Attr]
ON=-36,19,STATE
V=Closed

[Attr]
ON=-21,33,RON
V=1m

[Attr]
ON=-34,47,ROFF
V=1e15

[Attr]
ON=0,0,PACKAGE
V

[Comp]
Name=Animated SPST Switch
Px=856,328
Rot=6

[Attr]
ON=-51,5,PART
V=Switch85
Style=8192

[Attr]
ON=-36,19,STATE
V=Closed

[Attr]
ON=-21,33,RON
V=1m

[Attr]
ON=-34,47,ROFF
V=1e15

[Attr]
ON=0,0,PACKAGE
V

[Wire]
Pxs=960,416,1008,416

[Wire]
Pxs=960,328,960,368

[Wire]
Pxs=648,424,680,424

[Comp]
Name=NPN
Px=624,352

[Attr]
ON=37,-17,PART
V=Q20
Style=8192

[Attr]
ON=37,-3,MODEL
V=2n2222a

[Attr]
ON=37,25,PACKAGE
V=TO-18

[Comp]
Name=Animated SPST Switch
Px=600,352
Rot=6

[Attr]
ON=-37,9,PART
V=Switch100
Style=8192

[Attr]
ON=-36,19,STATE
V=Closed

[Attr]
ON=-21,33,RON
V=1m

[Attr]
ON=-34,47,ROFF
V=1e15

[Attr]
ON=0,0,PACKAGE
V

[Wire]
Pxs=600,352,624,352

[Wire]
Pxs=752,328,808,328

[Comp]
Name=Animated SPST Switch
Px=752,328
Rot=6

[Attr]
ON=-37,9,PART
V=Switch102
Style=8192

[Attr]
ON=-36,19,STATE
V=Closed

[Attr]
ON=-21,33,RON
V=1m

[Attr]
ON=-34,47,ROFF
V=1e15

[Attr]
ON=0,0,PACKAGE
V

[Wire]
Pxs=648,328,704,328

[Wire]
Pxs=544,352,552,352

[Comp]
Name=Ground
Px=104,448
Rot=7

[Wire]
Pxs=104,432,104,448

[Comp]
Name=Ground
Px=960,416
Rot=7

[Wire]
Pxs=952,328,960,328

[Schematic]
CurrentSection 0=0
CurrentSection 1=0
CurrentSection 2=0
CurrentSection 3=0
Splitter.xs=0
Splitter.ys=0
TextQuad=4099
Scale=0.66666666666666663
GridUser=10
ShapeGroups="Main","Euro","Polarity","Main1","Main11","Electrolytic","GroundArrow","DeMorgan"
CalcRMS=False
CalcAVG=False
CalcPeak=False
CalcVoltage=True
DisplayMeasure=Last
ShareScales=True

[Tools]
Pos=Top
FILESAVEASOLD=No
BOM=No
FILEPCB=No
PROBE=Yes
SELECT=Yes
PAN=Yes
COMP=Yes
TEXT=Yes
WIRE=Yes
WIRED=Yes
BUS=Yes
GRAPHIC=Yes
FLOWCHART=Yes
LINE=No
ELLIPSE=No
RECT=No
DIAM=No
ARC=No
PIE=No
TRIANGLE=No
STAR=No
LEFTBRK=No
RIGHTBRK=No
BOTHBRK=No
META=Yes
PARALLELOGRAM=No
FC_PROCESS=No
FC_ALT_PROCESS=No
FC_DECISION=No
FC_DATA=No
FC_PREDEFPROCESS=No
FC_INTERNALSTORAGE=No
FC_DOCUMENT=No
FC_MULTIDOCUMENT=No
FC_TERMINATOR=No
FC_PREPARATION=No
FC_MANUALINPUT=No
FC_MANUALOPERATION=No
FC_CONNECTOR=No
FC_OFFPAGECONNECTOR=No
FC_PUNCHCARD=No
FC_PUNCHEDTAPE=No
FC_SUMMING_JUNCTION=No
FC_OR=No
FC_COLLATE=No
FC_SORT=No
FC_EXTRACT=No
FC_MERGE=No
FC_STORED_DATA=No
FC_DELAY=No
FC_SAS=No
FC_MAGNETIC_DISK=No
FC_DAS=No
FC_DISPLAY=No
SPREAD_SHEET=Yes
POLYCLOS=No
POLYOPEN=No
FLAG=Yes
INFO=Yes
HELP=Yes
HELP_SPICE=No
LINK=Yes
CHECK=Yes
REGION_ENABLE=Yes
TITLE_BLOCK=Yes
DIGTRC=No
DIGTRC2=No
BUILD_COMMAND=Yes
DIGALL=No
GRIDTEXT=Yes
COMPTEXT=Yes
NODE=Yes
MEASURED=Yes
NODEV=Yes
CURRENT=Yes
POWER=Yes
CONDITIN=Yes
PIN=Yes
CONNWARN=Yes
CROSS=Yes
GRID=Yes
BORDER=Yes
BORDERONE=Yes
TITLE=Yes
RUBBER=Yes
PROPERTY=Yes
STEP=Yes
MIRROR=Yes
ROTATE=Yes
FLIPY=Yes
FLIPX=Yes
CIR_MAKEMACRO=No
CLEARCUTWIRE=No
CLIPBOARDCIRPAGE2BMM=No
FINDCOMP=Yes
FIND=Yes
REPEAT=No
REPLACE=No
MODEL=Yes
CIR2CKT=Yes
ATTDISP=Yes
ENABLE=Yes
DISABLE=Yes
ENABLE_WITH=Yes
TOFRONT=Yes
TOBACK=Yes
SELNEXT=Yes
PAGEADD=Yes
PAGEADDTEXT=No
ADDSECTION=No
PAGEDEL=Yes
ZOOMIN=Yes
ZOOMOUT=Yes
AUTOSCALECIR=Yes
GOTOFLAG=Yes
UPLEVEL=Yes
COLOR=Yes
FONT=Yes
STYLE=Yes
DM_LAST=No
DM_RMS=No
DM_AVG=No
DM_PEAK=No
GRID_NONE=No
GRID_NORMAL=No
GRID_BOLD_5=No
GRID_BOLD_6=No
GRID_BOLD_USER=No
GRAPH_PAPER=No
SPLITCIRTEXTH=No
SPLITCIRTEXTV=No
SPACE_SPLITTERS_EVENLY=No
NORMALCIR=No
RENAMEDEFINE=No
RENAMECMP=No
ATTALIGN=No
RESETNODEPOS=No
FIT2STANDARD=No
NODESNAP=No
MOVETEXT=No
TEXTINC=No
TOGGLETEXT=No
TOGGLEMODE=No
TOLERANCE=No
ALIGNAB=No
ALIGNLEFT=Yes
ALIGNCENTER=Yes
ALIGNRIGHT=Yes
ALIGNTOP=Yes
ALIGNMIDDLES=Yes
ALIGNBOTTOM=Yes

[Section]
Index=0
Name="Fuzz 1000 Faces Original Simple 2"
Type=Main
Enable=True
CurrentPage 0=0
CurrentPage 1=0
CurrentPage 2=0
CurrentPage 3=0
TabSize 0=425
TabSize 1=425
TabSize 2=425
TabSize 3=425

[Page]
Index=0
Section=0
Print=True
Enable=True
Name=Main
PrinterScale=1
Scale 0=1
Scale 1=1
Scale 2=1
SB 3=0,127
Scale 3=0.66666666666666663
Px=171,654
WinBackGround Color=#FFFFFF
Select Color=#FF0000
Anchor Color=#000000
Select Box Color=#000080
Grid Text Color=Height=-12,FStyle=0,Color=#0000FF,Name=Verdana
Grid Text RTF=False
Grid Text Angle=0
Grid Text GridSnap=True
Grid Text PinIt=False
Grid Text JustifyH=Left
Grid Text JustifyV=Bottom
Grid GradientColor2=None
Grid OutlineThickness=1
Grid OutlineColor=None
Component Color=#0000FF
Attribute Text=Height=-12,FStyle=0,Color=#008000,Name=Verdana
Wire Color=#008000
Bus Color=#008000
Pin Connection=Height=-10,FStyle=0,Color=#FF0000,Name=Arial
Pin Marker Color=#008000
Node Number=Height=-11,FStyle=0,Color=#FF00FF,Name=Arial
Node Voltage Color=Height=-11,FStyle=0,Color=#000000,Name=Arial
Dynamic AC Voltage Color=#E4E4E4
Text Banner Text=Height=-15,FStyle=0,Color=#800000,Name=Arial
Title Block Background=#C0C0C0
Current=Height=-11,FStyle=0,Color=#0000FF,Name=Arial
Power/Condition=Height=-11,FStyle=0,Color=#FF0000,Name=Arial
Digital Path Color=#FF0000
Title Block Border=#000000
Disabled	Color=#C0C0C0
Search Color=#FFFF00
Grid Color=#000000
Graph Paper=#E4E4E4
Digital 0 Color=#000000
Digital R Color=#FFFF00
Digital F Color=#FFFF00
Digital 1 Color=#FF0000
Digital X Color=#C0C0C0
Digital Z Color=#808080
Block Select Color=#51F998

[Page]
Index=1
Section=0
Type=Text
Print=False
Enable=True
Name=Text
Font=Height=-15,FStyle=0,Color=#000000,Name=Courier New
Comment Color=#008000
WinBackGround Color=#FFFFFF
Disabled	Color=#C0C0C0
KeyWord Color=#0000FF
Error	Color=#FF0000
Search Color=#FFFF00

[Page]
Index=2
Section=0
Type=Text
Print=False
Enable=True
Name=Models
SB 0=26,2
Font=Height=-15,FStyle=0,Color=#000000,Name=Courier New
Comment Color=#008000
WinBackGround Color=#FFFFFF
Disabled	Color=#C0C0C0
KeyWord Color=#0000FF
Error	Color=#FF0000
Search Color=#FFFF00

[Page]
Index=3
Section=0
Type=Info
Print=False
Enable=True
Name=Info
Font=Height=-15,FStyle=0,Color=#000000,Name=Courier New
Comment Color=#008000
WinBackGround Color=#FFFFFF
Disabled	Color=#C0C0C0
KeyWord Color=#0000FF
Error	Color=#FF0000
Search Color=#FFFF00

[Text Area]
Section=0
Page=1
Text=.OPTIONS ITL4=50

[Text Area]
Section=0
Page=2
Text=*** From file C:\MC12\library\UTILITY.LBR
Text=*** 60HZ Sinusoidal Source
Text=.MODEL 60HZ SIN (A=2 F=60)
Text=*** From file C:\MC12\library\MSBJT.LBR
Text=*** NPN General purpose transistor
Text=.MODEL 2N2222A NPN (BF=200.601 BR=155.257m CJC=36.6437p CJE=35.3531p
Text=+ IKF=1.77131 IKR=995.298 IS=10.017f ISC=9.15251p ISE=999.157f ITF=9.91019m
Text=+ MJC=558.066m MJE=642.88m NE=1.83441 NF=979.99m RE=668.817m TF=336.941p
Text=+ TR=2.26304u VAF=100 VJC=700m VJE=700m VTF=10 XTF=499.994m)
Text=*** From file C:\MC12\library\MSBJT.LBR
Text=*** NPN Amplifer transistors
Text=.MODEL BC547B NPN (BF=294.402 BR=2.65875 CJC=6.40421p CJE=19.7395p IKF=139.796m
Text=+ IKR=997.583 IS=7.88857f ISC=3.45105p ISE=997.415f ITF=9.88981m MJC=316.254m
Text=+ MJE=312.92m NE=1.93976 NF=968.124m RE=1.23191 TF=374.789p TR=10n VAF=100
Text=+ VJC=700m VJE=770.586m VTF=10 XTF=499.98m)
Text=*** From file C:\MC12\library\MSBJT.LBR
Text=*** NPN Amplifer transistors
Text=.MODEL BC547A NPN (BF=190.796 BR=2.79335 CJC=6.40421p CJE=19.7395p IKF=151.395m
Text=+ IKR=995.974 IS=7.88857f ISC=2.06975p ISE=1.00306p ITF=9.88981m MJC=316.254m
Text=+ MJE=312.92m NE=1.83871 NF=968.124m RE=1.23191 TF=374.789p TR=10n VAF=100
Text=+ VJC=700m VJE=770.586m VTF=10 XTF=499.98m)
Text=*** From file C:\MC12\library\MSBJT.LBR
Text=*** NPN Amplifer transistors
Text=.MODEL BC547C NPN (BF=630.776 BR=2.58734 CJC=6.40421p CJE=19.7395p IKF=104.728m
Text=+ IKR=954.174 IS=7.88857f ISC=4.56856p ISE=2.59643f ITF=9.88981m MJC=316.254m
Text=+ MJE=312.92m NE=1.26993 NF=968.124m RE=1.23191 TF=374.789p TR=10n VAF=100
Text=+ VJC=700m VJE=770.586m VTF=10 XTF=499.98m)
Text=.MODEL S9013 NPN ()
Text=*** From file C:\MC12\library\PH_BJT.LIB
Text=.MODEL MMBT2222A NPN (BF=256.7 BR=6.590 CJC=10.11E-12 CJE=25.89E-12 CJS=0.000
Text=+ EG=1.110 FC=938.8E-3 IKF=489.9E-3 IKR=192.9E-3 IRB=1.000E-3 IS=29.13E-15
Text=+ ISC=320.3E-12 ISE=9.652E-15 ITF=4.797 MJC=416.0E-3 MJE=366.8E-3 MJS=333.0E-3
Text=+ NC=1.608 NE=1.516 NF=992.6E-3 NR=984.4E-3 PTF=0.000 RB=1.000 RBM=1.000
Text=+ RC=224.8E-3 RE=193.4E-3 TF=293.9E-12 TR=320.0E-9 VAF=80.99 VAR=101.2
Text=+ VJC=662.2E-3 VJE=689.1E-3 VJS=750.0E-3 VTF=20.00 XCJC=0.5946 XTB=0.000
Text=+ XTF=71.78 XTI=3.000)
Text=*** From file C:\MC12\library\DIODESINC_BJT.LIB
Text=.MODEL MMBT5551 NPN (BF=110 BR=4.5 CJC=6.1E-12 CJE=57E-12 GAMMA=2.2E-7
Text=+ IS=6.5E-15 ISC=3E-12 ISE=1.0E-14 MJC=0.31 MJE=0.35 NC=1.35 QUASIMOD=1 RB=0.26
Text=+ RC=0.5 RCO=170 RE=0.23 TF=0.2E-9 TR=1.5E-6 VAF=288 VAR=70 VJC=0.4 VJE=0.8
Text=+ VO=35 XTB=1.4)
Text=*** From file C:\MC12\library\DIODESINC_BJT.LIB
Text=.MODEL MMBT4401T NPN (BF=410 BR=4.00 CJC=14.2P CJE=27.7P EG=1.12 IKF=60.7M
Text=+ IKR=0.150 IS=1.27P ISE=47.7P MJC=0.300 MJE=0.500 NE=2.00 NF=1.00 NR=1.00
Text=+ RB=1.04 RC=0.104 RE=0.261 TF=533P TR=84.1N VAF=114 VAR=24.0 VJC=0.300
Text=+ VJE=1.10 XTB=1.5)
Text=*** From file C:\MC12\library\MSBJT.LBR
Text=*** NPN Amplifer transistors
Text=.MODEL BC548 NPN (BF=437.641 BR=2.55977 CJC=6.40421p CJE=19.7395p IKF=544.354m
Text=+ IKR=985.432 IS=7.88857f ISC=7.52015p ISE=.0000161327f ITF=9.88981m
Text=+ MJC=316.254m MJE=312.92m NE=1.24119 NF=968.124m RE=1.23191 TF=374.789p TR=10n
Text=+ VAF=100 VJC=700m VJE=770.586m VTF=10 XTF=499.98m)
Text=*** From file C:\MC12\library\EUROPE.LBR
Text=*** NPN AF transistor
Text=.MODEL BC107B NPN (BF=280.636505 BR=161.258996m CJC=6.117156p CJE=11.826276p
Text=+ IKF=9.99853K IKR=997.461426 IS=10.00035f ISC=.0002724251f ISE=87.422097p
Text=+ ITF=9.95368m MJC=361.359m MJE=673.545003m NE=3 NF=912.846446m RC=55.998243m
Text=+ RE=2 TF=395.633026p TR=10n VAF=62.366673 VJC=949.695349m VJE=1 VTF=10
Text=+ XTF=500.000119m)

[InfoPage]
InfoPage=True
Warnings=True
System=True
Defines=True
Array=True
Model=True
Measure=True
MacroSubckt=True
NotUsed=True
ComponentCounts=True
VariablizePaths=False
DontShowPaths=False
SimulationLog=True

[Transient]
WinID=1
Window Placement=0,1, -1,-1, -8,-31, 1912,0,3741,924
Font=Height=-19,FStyle=0,Color=#0000FF,Name=Arial
WinBackGround Color=#FFFFFF
Select Color=#FF0000
Anchor Color=#000000
Select Box Color=#000080
Title
AutoTitle=Yes
Grid Color=#808080
Grid Weight=1
Grid Pattern=Dot6
Tracker Foreground=Height=-15,FStyle=0,Color=#000000,Name=Arial
Tracker Background=#FFFF00
Baseline color=#0000FF
BaseLine Weight=1
CurveFit color=#FF0000
CurveFit Weight=2
CurveFit Pattern=Dash
Static Grids=False
PlusMark=False
MinorLog25=Off
LabelMinor=Off
DataPoints=False
Token=False
Ruler=False
XAxisGrids=True
YAxisGrids=True
MinorLogGrids=True
BaseLine=False
AlignZ=True
Align Cursors=True
TagFormatX=3
TagFormatY=3
FormulaFormat=2
EndMode=SCALE
Graph Background=#FFFFFF
Tracker Intercept=False
Tracker Mouse=True
Tracker Cursor=True
Tracker Cursor BranchInfo=False
Horizontal Cursor=False
Same Y Scales=Yes
Enable X Scaling=True
Enable Y Scaling=True
Keep X Scales The Same=True
Number of Grids X=5
Number of Grids Y=5
Cursor Select Color Primary=#C0C0C0
Cursor Select Color Secondary=#FF0000
Data Point Labels Color Fore=Height=-15,FStyle=0,Color=#000000,Name=Arial
Data Point Labels Color Back=#FFFF00
OperPoint=True
OperPointOnly=False
AutoScaleRanges=True
FixedTimeStep=False
DoPSS=False
PSS_Periods="1"
PSS_Iterations="5"
PSS_Error="1u"
PSS_ShowPlots=True
FFT_NPts="8192"
FFT_IncludeDCHarmonic=False
FFT_AutoScale_Harmonics="10"
PrinterAutoTile=No
PrinterBlackBorder=No
MonMaxShow=3
MonPageWidth=66
MonPlotWidth=21
MonExprXWidth=142
MonExprYWidth=513
MonRangeXWidth=90
MonRangeYWidth=90
AnimateWait=None
AnimateWaitTime=500
AnimatePressAfter=0
Save_For_Future=No
Reduce_Display=1
Reduce_Save=1
Reduce_ThrowDataOut=0
Num Out Header Left
Num Out Header Center="$MC\n$user\n$company\n$Analysis of $name\n$date $time"
Num Out Header Right
Num Out Delimiter=32
Num Out Write=True
Num Out Write Main Header=True
Num Out Write Limits=True
Num Out Write Branch Header=True
Num Out Write Models=False
Num Out Write Zero Models=True
Num Out Write Undefined Models=True
Num Out Write Operating Point=True
Num Out Write Measurement Values=True
Num Out Write Tolerance Detail=True
Num Out Write Values=True
Num Out Write Waveform Header=True
Num Out Allow Dup Y Expr=False
Num Out Low="TSTART"
Num Out High="TMAX"
Num Out Font=Height=-15,FStyle=0,Color=#000000,Name=Courier New
Num Out Format=3
Num Out HideNonSelected=False
Num Out UseActualDataPoints=False
AutoSaveWave=False
Wave Format=16E
State Variables Format=5E
Print Individual Pages=False

[Tools]
Pos=Top
SELECT=Yes
PAN=Yes
GRAPHIC=Yes
LINE=No
ELLIPSE=No
RECT=No
DIAM=No
ARC=No
PIE=No
TRIANGLE=No
STAR=No
LEFTBRK=No
RIGHTBRK=No
BOTHBRK=No
META=Yes
PARALLELOGRAM=No
POLYCLOS=No
POLYOPEN=No
SCALE=Yes
CURSOR=Yes
MEASUREH=Yes
MEASUREV=Yes
TAG=Yes
PTAG=Yes
TEXT=Yes
PROPERTY=Yes
START=Yes
STOP=Yes
PAUSE=Yes
RESUME=No
DATAPTS=Yes
TOKENS=Yes
RULER=Yes
PLUS=Yes
XAXIS=Yes
YAXIS=Yes
MINORLOG=Yes
LOG25=Yes
BASELINE=Yes
HORIZCUR=Yes
GOTOX=Yes
GOTOY=Yes
GOTOPERF=Yes
GOTOBRNC=Yes
CLEAR_ACCUMULATED=Yes
PDELETE_ALL_PLOTS=Yes
NEXT=Yes
NEXTIN=Yes
PEAK=Yes
VALLEY=Yes
HIGH=Yes
LOW=Yes
INFLECTN=Yes
GHIGH=Yes
GLOW=Yes
BOTTOM=Yes
TOP=Yes
WAVEFORMBUFFER=Yes
AOUTPUT=Yes
PKEY=Yes
ENXSCALE=Yes
ENYSCALE=Yes
ZOOMIN=Yes
ZOOMOUT=Yes
AUTOSCALE=Yes
RESTORESCALE=No
COLOR=Yes
FONT=Yes
STYLE=Yes
SELNEXT=Yes
NORMALIZE=No
NORMALIZE_MIN=No
NORMALIZE_MAX=No
ADD_TAG_LEFT=No
ADD_TAG_RIGHT=No
ADD_HORZ_TAG=No
ADD_VERT_TAG=No
ALIGN_CURSORS=No
ALIGN_CURSORSZ=No
CURSORTOCLIPBOARD=No
TRACKER_CURSOR=No
TRACKER_CURSOR_BRANCHINFO=No
TRACKER_INTERCEPT=No
TRACKER_MOUSE=No
TOFRONT=Yes
TOBACK=Yes
SPLITCIRTEXTH=No
SPLITCIRTEXTV=No
SPACE_SPLITTERS_EVENLY=No
NORMALCIR=No
LABEL_WAVEFORM=No
LABEL_DATA_POINTS=No
WFB_ADD_TO_LIMITS=No
ENVELOPE=No
SAMEYSCALES=No
KEEPXSCALESTHESAME=No
CURVEFIT=No
ADD_MARKER=No
SHOWWATCH=No
BP=No
TOGGLEMODE=No
REMOVEALLTEXT=No
AUTOSCALEX=No
LABELALLMINOR=No
ALIGNLEFT=Yes
ALIGNCENTER=Yes
ALIGNRIGHT=Yes
ALIGNTOP=Yes
ALIGNMIDDLES=Yes
ALIGNBOTTOM=Yes

[APage]
Analysis=Transient
Name="MAIN"

[AC]
WinID=2
Window Placement=2,3, -1,-1, -8,-31, 156,156,1755,810
Font=Height=-19,FStyle=0,Color=#0000FF,Name=Arial
WinBackGround Color=#FFFFFF
Select Color=#FF0000
Anchor Color=#000000
Select Box Color=#000080
Title
AutoTitle=Yes
Grid Color=#808080
Grid Weight=1
Grid Pattern=Dot6
Tracker Foreground=Height=-15,FStyle=0,Color=#000000,Name=Arial
Tracker Background=#FFFF00
Baseline color=#0000FF
BaseLine Weight=1
CurveFit color=#FF0000
CurveFit Weight=2
CurveFit Pattern=Dash
Static Grids=False
PlusMark=False
MinorLog25=Off
LabelMinor=Off
DataPoints=False
Token=False
Ruler=False
XAxisGrids=True
YAxisGrids=True
MinorLogGrids=True
BaseLine=False
AlignZ=True
Align Cursors=True
TagFormatX=3
TagFormatY=3
FormulaFormat=2
EndMode=SCALE
Graph Background=#FFFFFF
Tracker Intercept=False
Tracker Mouse=True
Tracker Cursor=True
Tracker Cursor BranchInfo=False
Horizontal Cursor=False
Same Y Scales=Yes
Enable X Scaling=True
Enable Y Scaling=True
Keep X Scales The Same=True
Number of Grids X=5
Number of Grids Y=5
Cursor Select Color Primary=#C0C0C0
Cursor Select Color Secondary=#FF0000
Data Point Labels Color Fore=Height=-15,FStyle=0,Color=#000000,Name=Arial
Data Point Labels Color Back=#FFFF00
OperPoint=True
AutoScaleRanges=True
FFT_NPts="8192"
FFT_IncludeDCHarmonic=False
FFT_AutoScale_Harmonics="10"
PrinterAutoTile=No
PrinterBlackBorder=No
MonMaxShow=3
MonPageWidth=66
MonPlotWidth=21
MonExprXWidth=142
MonExprYWidth=260
MonRangeXWidth=90
MonRangeYWidth=90
AnimateWait=None
AnimateWaitTime=500
AnimatePressAfter=0
Save_For_Future=No
Reduce_Display=1
Reduce_Save=1
Reduce_ThrowDataOut=0
Num Out Header Left
Num Out Header Center="$MC\n$user\n$company\n$Analysis of $name\n$date $time"
Num Out Header Right
Num Out Delimiter=32
Num Out Write=True
Num Out Write Main Header=True
Num Out Write Limits=True
Num Out Write Branch Header=True
Num Out Write Models=False
Num Out Write Zero Models=True
Num Out Write Undefined Models=True
Num Out Write Operating Point=True
Num Out Write Measurement Values=True
Num Out Write Tolerance Detail=True
Num Out Write Noise=True
Num Out Write Values=True
Num Out Write Waveform Header=True
Num Out Allow Dup Y Expr=False
Num Out Low="FMIN"
Num Out High="FMAX"
Num Out Font=Height=-15,FStyle=0,Color=#000000,Name=Courier New
Num Out Format=3
Num Out HideNonSelected=False
Num Out UseActualDataPoints=False
AutoSaveWave=False
Wave Format=16E
State Variables Format=5E
Print Individual Pages=False

[Tools]
Pos=Top
SELECT=Yes
PAN=Yes
GRAPHIC=Yes
LINE=No
ELLIPSE=No
RECT=No
DIAM=No
ARC=No
PIE=No
TRIANGLE=No
STAR=No
LEFTBRK=No
RIGHTBRK=No
BOTHBRK=No
META=Yes
PARALLELOGRAM=No
POLYCLOS=No
POLYOPEN=No
SCALE=Yes
CURSOR=Yes
MEASUREH=Yes
MEASUREV=Yes
TAG=Yes
PTAG=Yes
TEXT=Yes
PROPERTY=Yes
START=Yes
STOP=Yes
PAUSE=Yes
RESUME=No
DATAPTS=Yes
TOKENS=Yes
RULER=Yes
PLUS=Yes
XAXIS=Yes
YAXIS=Yes
MINORLOG=Yes
LOG25=Yes
BASELINE=Yes
HORIZCUR=Yes
GOTOX=Yes
GOTOY=Yes
GOTOPERF=Yes
GOTOBRNC=Yes
CLEAR_ACCUMULATED=Yes
PDELETE_ALL_PLOTS=Yes
NEXT=Yes
NEXTIN=Yes
PEAK=Yes
VALLEY=Yes
HIGH=Yes
LOW=Yes
INFLECTN=Yes
GHIGH=Yes
GLOW=Yes
BOTTOM=Yes
TOP=Yes
WAVEFORMBUFFER=Yes
AOUTPUT=Yes
PKEY=Yes
ENXSCALE=Yes
ENYSCALE=Yes
ZOOMIN=Yes
ZOOMOUT=Yes
AUTOSCALE=Yes
RESTORESCALE=No
COLOR=Yes
FONT=Yes
STYLE=Yes
SELNEXT=Yes
NORMALIZE=No
NORMALIZE_MIN=No
NORMALIZE_MAX=No
ADD_TAG_LEFT=No
ADD_TAG_RIGHT=No
ADD_HORZ_TAG=No
ADD_VERT_TAG=No
ALIGN_CURSORS=No
ALIGN_CURSORSZ=No
CURSORTOCLIPBOARD=No
TRACKER_CURSOR=No
TRACKER_CURSOR_BRANCHINFO=No
TRACKER_INTERCEPT=No
TRACKER_MOUSE=No
TOFRONT=Yes
TOBACK=Yes
SPLITCIRTEXTH=No
SPLITCIRTEXTV=No
SPACE_SPLITTERS_EVENLY=No
NORMALCIR=No
LABEL_WAVEFORM=No
LABEL_DATA_POINTS=No
WFB_ADD_TO_LIMITS=No
ENVELOPE=No
SAMEYSCALES=No
KEEPXSCALESTHESAME=No
CURVEFIT=No
ADD_MARKER=No
SHOWWATCH=No
BP=No
TOGGLEMODE=No
REMOVEALLTEXT=No
AUTOSCALEX=No
LABELALLMINOR=No
ALIGNLEFT=Yes
ALIGNCENTER=Yes
ALIGNRIGHT=Yes
ALIGNTOP=Yes
ALIGNMIDDLES=Yes
ALIGNBOTTOM=Yes

[APage]
Analysis=AC
Name="MAIN"

[Monte Carlo Options]
Analysis=Transient
Status=Off
Zero Tolerance=False
Eliminate Outliers=False
Distribution=Normal
Number of Runs=10
Seed=0

[Monte Carlo Options]
Analysis=AC
Status=Off
Zero Tolerance=False
Eliminate Outliers=False
Distribution=Normal
Number of Runs=10
Seed=0

[Limits]
Analysis=Transient
TMax=1s
TStart=0
TStep=0.01s
NPts=51
Temp=27
RetraceRuns=1
StateVar=Zero
RunOption=Normal
Temperature Type=Linear
Accumulate Plots=False
IgnoreExprErrors=False

[WaveForm]
Analysis=Transient
Plt=1
AliasID=1
XExp=T
YExp=v(1)
XRng=1
YRng=6,-1.5
Options=LINEARX,LINEARY
Range Grid X=0.2
Range Grid Y=1.5
Enable=DontRun
Line Color=#0000FF
Text Color=#0000FF
Rainbow=False
VFmtX=3
VFmtY=3
ScaleFactorX="None"
ScaleFactorY="None"
ScaleUnitsX="Auto"
ScaleUnitsY="Auto"
SFmtX=2
SFmtY=2
NOFmtX=3E
NOFmtY=3E

[WaveForm]
Analysis=Transient
Plt=1
AliasID=2
XExp=T
YExp=v(3)
XRng=1
YRng=6,-1.5
Options=LINEARX,LINEARY
Range Grid X=0.2
Range Grid Y=1.5
Enable=DontRun
Line Color=#FF0000
Text Color=#FF0000
Rainbow=False
VFmtX=3
VFmtY=3
ScaleFactorX="None"
ScaleFactorY="None"
ScaleUnitsX="Auto"
ScaleUnitsY="Auto"
SFmtX=2
SFmtY=2
NOFmtX=3E
NOFmtY=3E

[WaveForm]
Analysis=Transient
Plt=1
AliasID=3
XExp=T
YExp=v(12)
XRng=1
YRng=4.5,-3
Options=LINEARX,LINEARY
Range Grid X=0.2
Range Grid Y=1.5
Enable=Enable
Line Color=#008000
Text Color=#008000
Rainbow=False
VFmtX=3
VFmtY=3
ScaleFactorX="None"
ScaleFactorY="None"
ScaleUnitsX="Auto"
ScaleUnitsY="Auto"
SFmtX=2
SFmtY=2
NOFmtX=3E
NOFmtY=3E

[Limits]
Analysis=AC
FRange=1E8,1Meg
NPts=1001
Temp=27
MaxChng=5
NInput=NONE
NOutput=2
Sweep type=Log
StateVar=Zero
RunOption=Normal
Temperature Type=Linear
Accumulate Plots=False
IgnoreExprErrors=False
FirstValueDisplay=Mag
SecondValueDisplay=PhaseDeg
DisplayValuesInProbe=DC

[WaveForm]
Analysis=AC
Plt=1
AliasID=1
XExp=F
YExp=dB(v(1))
XRng=1e+8,1e+6
YRng=2e-6,-8e-6
Options=LINEARY
Range Grid X=1.98e+7
Range Grid Y=2e-6
Enable=Enable
Line Color=#0000FF
Text Color=#0000FF
Rainbow=False
VFmtX=3
VFmtY=3
ScaleFactorX="None"
ScaleFactorY="None"
ScaleUnitsX="Auto"
ScaleUnitsY="Auto"
SFmtX=2
SFmtY=2
NOFmtX=3E
NOFmtY=3E

[WaveForm]
Analysis=AC
Plt=2
AliasID=2
XExp=F
YExp=ph(v(1))
XRng=1e+8,1e+6
YRng=0.0004,-0.0016
Options=LINEARY
Range Grid X=1.98e+7
Range Grid Y=0.0004
Enable=Enable
Line Color=#FF0000
Text Color=#FF0000
Rainbow=False
VFmtX=3
VFmtY=3
ScaleFactorX="None"
ScaleFactorY="None"
ScaleUnitsX="Auto"
ScaleUnitsY="Auto"
SFmtX=2
SFmtY=2
NOFmtX=3E
NOFmtY=3E

[WaveForm]
Analysis=AC
AliasID=-1
Options=LINEARY
Enable=Enable
Line Color=#008000
Text Color=#008000
Rainbow=False
VFmtX=3
VFmtY=3
ScaleFactorX="None"
ScaleFactorY="None"
ScaleUnitsX="Auto"
ScaleUnitsY="Auto"
SFmtX=2
SFmtY=2
NOFmtX=3E
NOFmtY=3E

[Limits]
Analysis=DynamicAC
Temp=27
FreqList=1E6
SliderPer=10
FirstValueDisplay=Mag
SecondValueDisplay=PhaseDeg
PlaceText=False

[Limits]
Analysis=DynamicDC
Temp=27
SliderPer=10
PlaceText=True

[Pane]
Analysis=Transient
CurrentPage 0="MAIN"

[Pane]
Analysis=AC
CurrentPage 0="MAIN"

[Pane]
Analysis=DC

[Pane]
Analysis=HmDistortion

[Pane]
Analysis=ImDistortion

[Pane]
Analysis=Stability

[Watch]
Analysis=Transient
Format=3
ExprPercentWidth=80

[Watch]
Analysis=AC
Format=3
ExprPercentWidth=80

[WCTolerance]
Var Width=100
Nominal Width=72
Tol Width=152
Tol Name=Drift
Col Width Neq=50
Col Width Pos=50
Col Width Rnd=50

[WCFiles]
UseFile=<Library>Standard.tlib
AVAILABLE_FILE=<Library>Standard.tlib

[OPMethods]
Analysis=Transient
Standard Newton-Raphson=0,0
Source Stepping=0,0
Diagonal Gmin Stepping=0,0
Junction Gmin Stepping=0,0
Pseudo Transient=0,0

[OPMethods]
Analysis=AC
Standard Newton-Raphson=0,0
Source Stepping=0,0
Diagonal Gmin Stepping=0,0
Junction Gmin Stepping=0,0
Pseudo Transient=0,0

[OPMethods]
Analysis=DC
Standard Newton-Raphson=0,0
Source Stepping=0,0
Diagonal Gmin Stepping=0,0
Junction Gmin Stepping=0,0
Pseudo Transient=0,0

[OPMethods]
Analysis=HmDistortion
Standard Newton-Raphson=0,0
Source Stepping=0,0
Diagonal Gmin Stepping=0,0
Junction Gmin Stepping=0,0
Pseudo Transient=0,0

[OPMethods]
Analysis=ImDistortion
Standard Newton-Raphson=0,0
Source Stepping=0,0
Diagonal Gmin Stepping=0,0
Junction Gmin Stepping=0,0
Pseudo Transient=0,0

[OPMethods]
Analysis=Stability
Standard Newton-Raphson=0,0
Source Stepping=0,0
Diagonal Gmin Stepping=0,0
Junction Gmin Stepping=0,0
Pseudo Transient=0,0

[OPMethods]
Analysis=DynamicAC
Standard Newton-Raphson=0,0
Source Stepping=0,0
Diagonal Gmin Stepping=0,0
Junction Gmin Stepping=0,0
Pseudo Transient=0,0
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
