michelkeijzers/FuzzTester2/MicroCap/Fuzz 1000 Faces Original Simple.cir

[Main]
FileType=CIR
Version=12.00
Program=Micro-Cap
Component Version=10.00
Shape Version=11.00
Screen=1920,1200
MCAPVersion=12.2.0.3
Key ID=Demo
NLCnt=492
TXCnt=1

[shapedef]
Name=Animated SPST Switch
Animated SPST Switch=0,-8,48,8
Current=16,8,32,8

[shapedef]
Name=Battery
Line=0,0,22,0
Line=22,-3,22,3
Line=26,-7,26,7
Line=26,0,48,0
Current=32,8,16,8

[shapedef]
Name=Bjt.root
Line=0,0,13,0
Rectangle=13,-12,15,12
Current=32,-24,32,-16
Current=32,24,32,16
Current=0,-8,8,-8
PolyOpen=3
PolyLine=24,-24
PolyLine=24,-12
PolyLine=14,-2
PolyOpen=3
PolyLine=24,24
PolyLine=24,12
PolyLine=14,2

[shapedef]
Name=Capacitor
Line=0,0,22,0
Line=22,-8,22,8
Line=26,-8,26,8
Line=26,0,48,0
Current=32,12,16,12

[shapedef]
Name=Ground
Line=0,0,12,0
Line=12,-8,12,8
Line=18,-4,18,4
Line=24,0,24,0

[shapedef]
Name=NPN
Root="Bjt.root",0,0,0
PolyClosed=3
PolyLine=20,12
PolyLine=24,12
PolyLine=24,8

[shapedef]
Name=Plus.root
Line=-2,0,2,0
Line=0,-2,0,2

[shapedef]
Name=Pot
Line=0,0,12,0
Line=12,0,14,-4
Line=14,-4,18,4
Line=18,4,22,-4
Line=22,-4,26,4
Line=26,4,30,-4
Line=30,-4,34,4
Line=34,4,36,0
Line=36,0,48,0
PolyClosed=4
PolyLine=24,4
PolyLine=24,4
PolyLine=22,8
PolyLine=26,8
Line=24,8,24,16

[shapedef]
Name=Resistor
PolyOpen=12
PolyLine=0,0
PolyLine=0,0
PolyLine=12,0
PolyLine=14,-4
PolyLine=18,4
PolyLine=22,-4
PolyLine=26,4
PolyLine=30,-4
PolyLine=34,4
PolyLine=36,0
PolyLine=48,0
PolyLine=48,0
Current=32,8,16,8

[shapedef]
Name=Sine_Source
Root="Vsource.root",0,0,0
Line=24,-6,26,-4
Line=26,-4,26,-2
Line=26,-2,22,2
Line=22,2,22,4
Line=22,4,24,6

[shapedef]
Name=Vsource.root
Line=0,0,12,0
Line=36,0,48,0
Ellipse=12,-12,36,12
FColor=None
Line=7,5,7,9
Root="Plus.root",41,7,0
Current=32,16,16,16

[compdef]
Name=Sine Source
Definition=Sine source
Shape=Sine_Source
Mask=4864
memo=Sine Source
Label Offset=18,12,15,12
PinCnt=2
Pin="Plus",6,0,-6,-6
Pin="Minus",0,0,-19,-6

[compdef]
Name=Capacitor
Definition=Capacitor
Shape=Capacitor
Mask=7425
Used=62
memo=Capacitor
Label Offset=16,12,12,12
PinCnt=2
Pin="Plus",6,0,-3,-5
Pin="Minus",0,0,-14,-5

[compdef]
Name=NPN
Definition=NPN
Shape=NPN
Mask=5633
Used=62
memo=NPN Transistor
Label Offset=37,-17,-14,33
PinCnt=3
Pin="Collector",3,-3,4,14
Pin="Base",0,0,-18,-3
Pin="Emitter",3,3,5,1

[compdef]
Name=Resistor
Definition=Resistor
Shape=Resistor
Mask=6913
Used=152
memo=Resistor
Label Offset=18,6,8,11
PinCnt=2
Pin="Plus",6,0,-10,-4
Pin="Minus",0,0,-14,-4

[compdef]
Name=Pot
Definition=Macro
Shape=Pot
Mask=4096
Used=6
memo=Potentiometer Macro
Label Offset=32,4,9,11
PinCnt=3
Pin="PINA",a,0,0,-13,-5
Pin="PINB",a,3,2,6,5
Pin="PINC",a,6,0,-12,-5

[compdef]
Name=Ground
Definition=Ground
Shape=Ground
Mask=1793
Used=263
memo=Ground
Label Offset=0,0,0,0
PinCnt=1
Pin="PinA",0,0,-3,-7

[compdef]
Name=Battery
Definition=Battery
Shape=Battery
Mask=6145
Used=52
memo=Battery
Label Offset=19,7,10,13
PinCnt=2
Pin="Plus",6,0,-4,-5
Pin="Minus",0,0,-10,-5

[compdef]
Name=Animated SPST Switch
Definition=ANIMATED SPST SWITCH
Shape=Animated SPST Switch
Mask=5888
Used=178
memo=Animated Single Pole, Single Throw Switch
Label Offset=2,5,11,11
PinCnt=2
Pin="A",0,0,5,0
Pin="B",6,0,-10,1

[Circuit]
Window Placement=2,3, -1,-1, -8,-31, 104,104,1507,758
Default Object=Color=#000080
Default Object Font=Height=-15,FStyle=0,Color=#000080,Name=Arial
Default Object Apply Border To Text=No
Default Object Apply Fill To Text=No
Default Object GridSnap=No
NodeVoltageFormat=3
CurrentFormat=3
PowerFormat=3
PathDelayFormat=3
WarningFormat=3
GridTextFormulaFormat=3
Window Placement in Transient Analysis=0,1, -1,-1, -8,-31, 2,2,1575,946
Window Placement in AC Analysis=2,3, -1,-1, -8,-31, 156,156,1755,810
Window Placement in DC Analysis=2,3, -1,-1, -8,-31, 286,286,3759,924
SpiceType=AMBIGUOUS
Title_Block_Border=None
Title_Block=True
Show Nodes=True
Show Voltages=True
Show Current=False
Show Power=False
Show Condition=False
Show Pin Connections=True
Show Connection Warnings=False
Show Cross=False
Show Attribute Text=True
Show Grid Text=False

[Comp]
Name=Sine Source
Px=56,432
Rot=3
COff=8,25,406,-33,-58

[Attr]
ON=-31,-26,PART
V=V3
Style=8192

[Attr]
ON=-48,-40,MODEL
V=60HZ

[Attr]
ON=0,0,PACKAGE
V

[Comp]
Name=Capacitor
Px=200,376
Rot=6

[Attr]
ON=-33,12,PART
V=C1
Style=8192

[Attr]
ON=-39,26,CAPACITANCE
V=10nF
Style=8192

[Attr]
ON=0,0,PACKAGE
V

[Comp]
Name=NPN
Px=440,376

[Attr]
ON=37,-17,PART
V=Q3
Style=8192

[Attr]
ON=37,-3,MODEL
V=MMBT2222A
Style=8192

[Attr]
ON=37,25,PACKAGE
V=SOT-23

[Comp]
Name=Resistor
Px=608,336
Rot=3

[Attr]
ON=-24,-25,PART
V=R3
Style=8192

[Attr]
ON=-37,-40,RESISTANCE
V=100K
Style=8192

[Attr]
ON=0,0,PACKAGE
V

[Comp]
Name=Resistor
Px=920,328
Rot=3

[Attr]
ON=-24,-25,PART
V=R4
Style=8192

[Attr]
ON=-40,-40,RESISTANCE
V=10K
Style=8192

[Attr]
ON=0,0,PACKAGE
V

[Comp]
Name=Resistor
Px=360,1448
Rot=4

[Attr]
ON=18,-20,PART
V=R8
Style=8192

[Attr]
ON=18,-34,RESISTANCE
V=100K
Style=8192

[Attr]
ON=0,0,PACKAGE
V

[Comp]
Name=Pot
Px=712,1496
Rot=3

[Attr]
ON=28,-43,PART
V=X2
Style=8192

[Attr]
ON=32,18,FILE
V=Pot

[Attr]
ON=39,-26,Param:POTSIZE
V=5K
Style=8192

[Attr]
ON=37,-10,Param:PERCENT
V=80
Style=8192

[Attr]
ON=0,0,PACKAGE
V

[Comp]
Name=Pot
Px=624,1496
Rot=3

[Attr]
ON=28,-43,PART
V=X3
Style=8192

[Attr]
ON=32,18,FILE
V=Pot

[Attr]
ON=31,-26,Param:POTSIZE
V=10K
Style=8192

[Attr]
ON=32,-8,Param:PERCENT
V=40
Style=8192

[Attr]
ON=0,0,PACKAGE
V

[Comp]
Name=Ground
Px=624,1544
Rot=7

[Comp]
Name=Pot
Px=1144,504
Rot=3

[Attr]
ON=31,-63,PART
V=X4
Style=8192

[Attr]
ON=32,18,FILE
V=Pot

[Attr]
ON=23,-12,Param:POTSIZE
V=100K
Style=8192

[Attr]
ON=23,2,Param:PERCENT
V=50
Style=8192

[Attr]
ON=0,0,PACKAGE
V

[Wire]
Pxs=56,376,56,384

[Wire]
Pxs=408,1448,624,1448

[Wire]
Pxs=656,1448,712,1448

[Wire]
Pxs=624,1496,624,1544

[Comp]
Name=Battery
Px=768,232
Rot=1

[Attr]
ON=19,7,PART
V=V4
Style=8192

[Attr]
ON=19,21,VALUE
V=9V
Style=8192

[Attr]
ON=0,0,PACKAGE
V

[Wire]
Pxs=608,280,768,280

[Wire]
Pxs=608,280,608,288

[Wire]
Pxs=768,280,920,280

[Wire]
Pxs=608,336,608,352

[Wire]
Pxs=624,1544,712,1544

[Comp]
Name=Capacitor
Px=712,1496
Rot=1

[Attr]
ON=-38,15,PART
V=C3
Style=8192

[Attr]
ON=-44,31,CAPACITANCE
V=22uF
Style=8192

[Attr]
ON=0,0,PACKAGE
V

[Wire]
Pxs=1160,480,1192,480

[Wire]
Pxs=1112,416,1112,504

[Wire]
Pxs=656,1448,656,1472

[Wire]
Pxs=712,1448,744,1448

[Wire]
Pxs=744,1448,744,1472

[Comp]
Name=Ground
Px=736,232
Rot=7

[Wire]
Pxs=736,232,768,232

[Comp]
Name=NPN
Px=440,464

[Attr]
ON=37,-17,PART
V=Q5
Style=8192

[Attr]
ON=37,-3,MODEL
V=MMBT3904
Style=8192

[Attr]
ON=37,25,PACKAGE
V=SOT-23

[Comp]
Name=Animated SPST Switch
Px=376,376
Rot=6

[Attr]
ON=-37,9,PART
V=Switch8
Style=8192

[Attr]
ON=-36,19,STATE
V=Closed

[Attr]
ON=-21,33,RON
V=1m

[Attr]
ON=-34,47,ROFF
V=1e15

[Attr]
ON=0,0,PACKAGE
V

[Comp]
Name=Animated SPST Switch
Px=384,464
Rot=6

[Attr]
ON=-51,5,PART
V=Switch9
Style=8192

[Attr]
ON=-36,19,STATE
V=Open

[Attr]
ON=-21,33,RON
V=1m

[Attr]
ON=-34,47,ROFF
V=1e15

[Attr]
ON=0,0,PACKAGE
V

[Wire]
Pxs=376,376,440,376

[Wire]
Pxs=312,488,464,488

[Wire]
Pxs=312,488,312,576

[Wire]
Pxs=568,352,608,352

[Comp]
Name=Animated SPST Switch
Px=568,352
Rot=6

[Attr]
ON=-37,9,PART
V=Switch12
Style=8192

[Attr]
ON=-36,19,STATE
V=Closed

[Attr]
ON=-21,33,RON
V=1m

[Attr]
ON=-34,47,ROFF
V=1e15

[Attr]
ON=0,0,PACKAGE
V

[Comp]
Name=Animated SPST Switch
Px=568,440
Rot=6

[Attr]
ON=-37,9,PART
V=Switch13
Style=8192

[Attr]
ON=-36,19,STATE
V=Open

[Attr]
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

[Attr]
ON=-34,47,ROFF
V=1e15

[Attr]
ON=0,0,PACKAGE
V

[Wire]
Pxs=608,984,640,984

[Wire]
Pxs=688,984,752,984

[Comp]
Name=Animated SPST Switch
Px=688,1048
Rot=6

[Attr]
ON=-51,5,PART
V=Switch111
Style=8192

[Attr]
ON=-36,19,STATE
V=Open

[Attr]
ON=-21,33,RON
V=1m

[Attr]
ON=-34,47,ROFF
V=1e15

[Attr]
ON=0,0,PACKAGE
V

[Wire]
Pxs=608,1048,640,1048

[Wire]
Pxs=688,1048,752,1048

[Comp]
Name=Animated SPST Switch
Px=688,1112
Rot=6

[Attr]
ON=-51,5,PART
V=Switch112
Style=8192

[Attr]
ON=-36,19,STATE
V=Open
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
