michelkeijzers/FuzzTester2/Kicad/3_Stm32DevBoard/Fuzz.kicad_pcb

## KiCad design Kicad/3_Stm32DevBoard/Fuzz.kicad_pcb (2020-05-30)

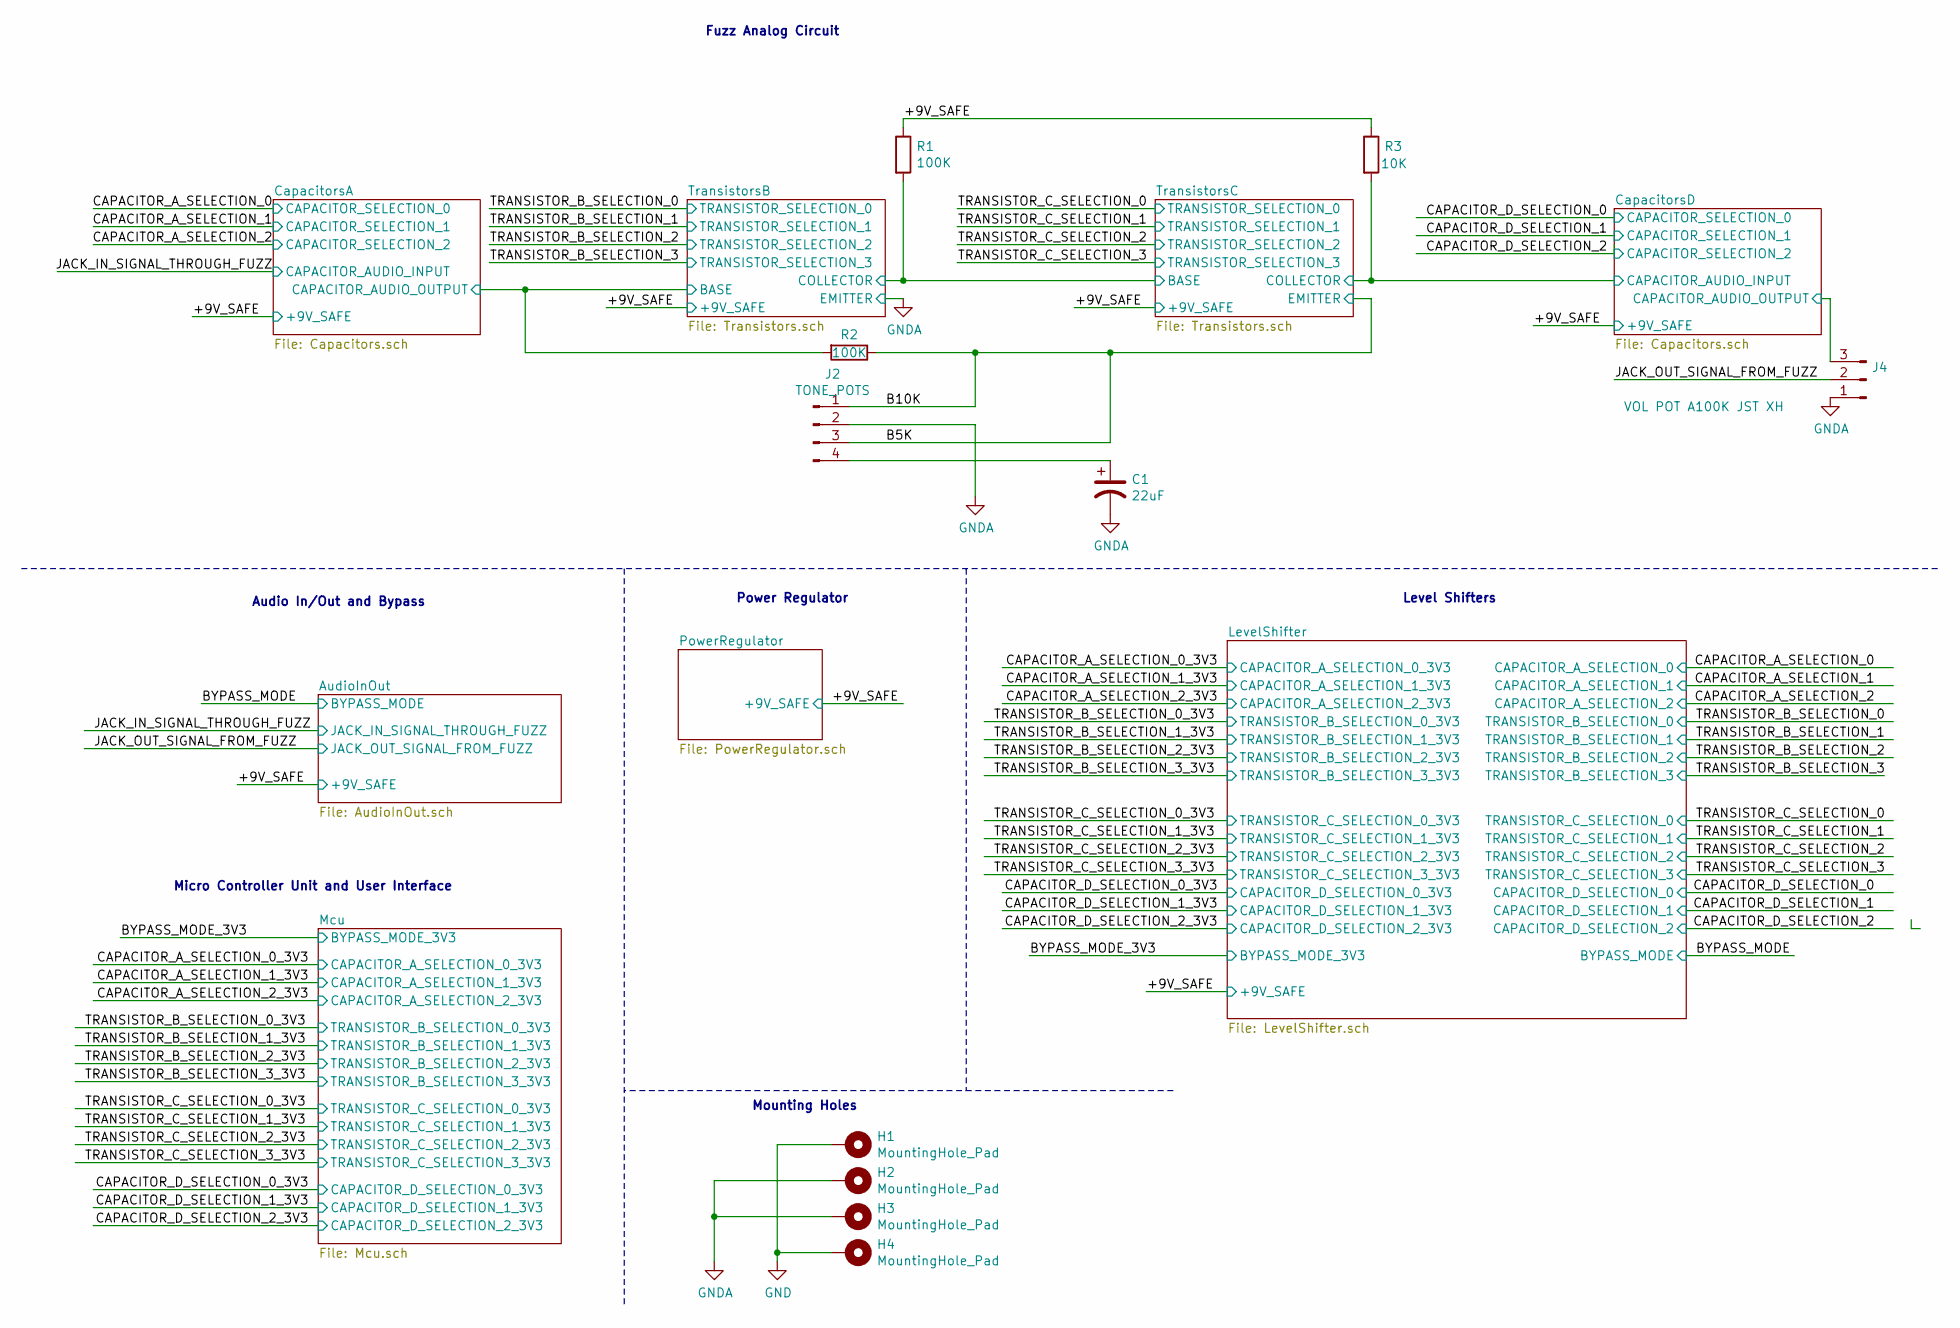
[picture p61: schematic Fuzz.sch, Guitar Pedal Effect Fuzz Digitally Controlled]

Parts:
C1: 22uF; CP_Radial_D5.0mm_P2.50mm
H1, H2, H3, H4: MountingHole_Pad; MountingHole_3mm_Pad_Via
J2: TONE_POTS; JST_XH_B4B-XH-A_1x04_P2.50mm_Vertical
J4: VOL POT A100K JST XH; JST_XH_B3B-XH-A_1x03_P2.50mm_Vertical
R1, R2: 100K; R_1206_3216Metric_Pad1.42x1.75mm_HandSolder
R3: 10K; R_1206_3216Metric_Pad1.42x1.75mm_HandSolder

Connections:
/+9V_SAFE: R1.1, R3.1; also elsewhere on the board
/B10K: J2.1, J2.3, R2.1; also elsewhere on the board
/CapacitorsD/CAPACITOR_AUDIO_INPUT: R3.2; also elsewhere on the board
/CapacitorsD/CAPACITOR_AUDIO_OUTPUT: J4.3; also elsewhere on the board
/JACK_OUT_SIGNAL_FROM_FUZZ: J4.2; also elsewhere on the board
/TransistorsB/BASE: R2.2; also elsewhere on the board
/TransistorsC/BASE: R1.2; also elsewhere on the board
GND: H1.1, H4.1; also elsewhere on the board
GNDA: C1.2, H2.1, H3.1, J2.2, J4.1; also elsewhere on the board
unnamed: C1.1, J2.4

Notes on the sheet:
Fuzz Analog Circuit
Audio In/Out and Bypass
Level Shifters
Power Regulator
Micro Controller Unit and User Interface
Mounting Holes

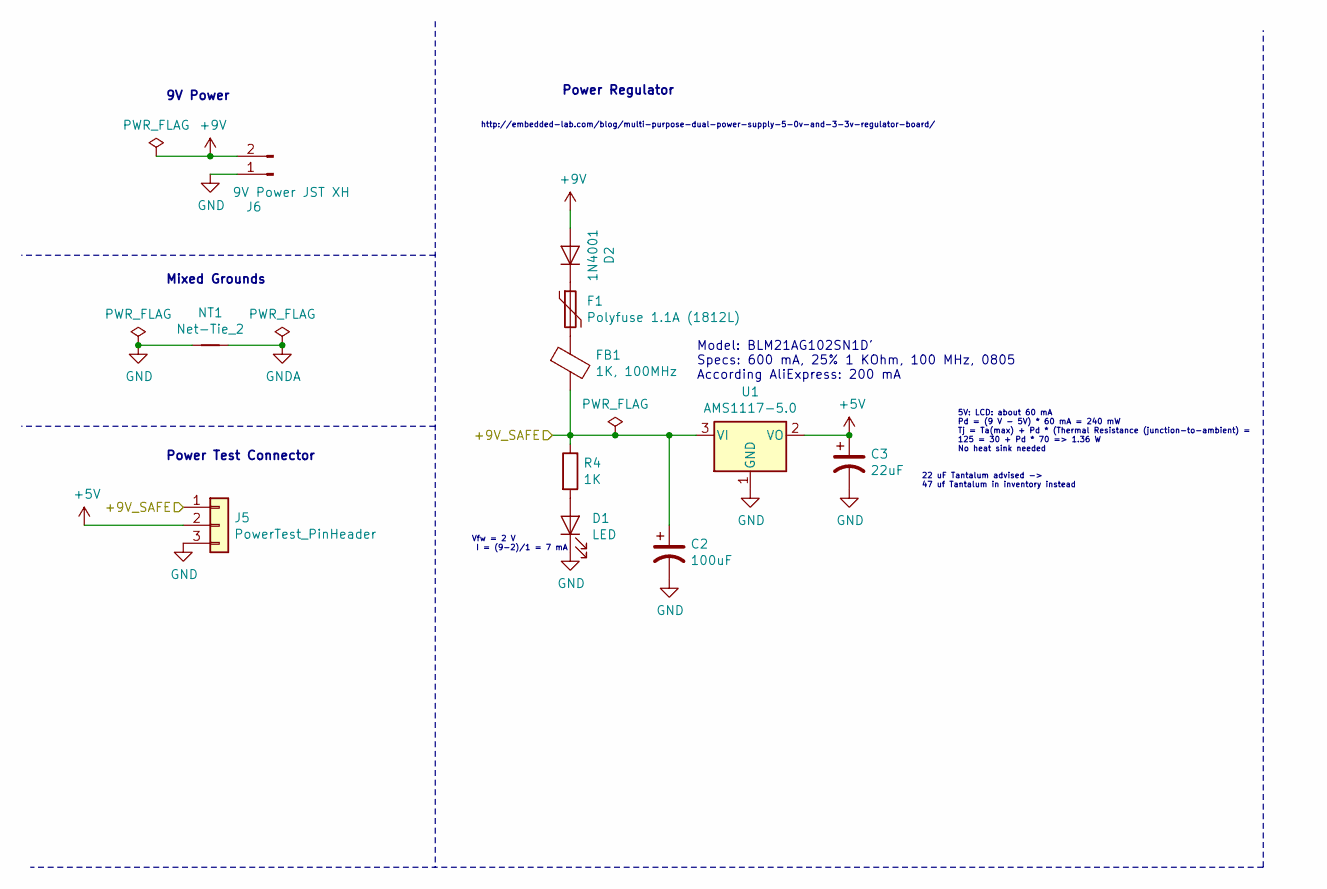
[picture p62: schematic PowerRegulator.sch, Guitar Pedal Effect Fuzz Digitally Controlled]

Parts:
C2: 100uF; CP_Radial_D5.0mm_P2.50mm
C3: 22uF; D_SMB_Handsoldering
D1: LED; LED_0805_2012Metric_Pad1.15x1.40mm_HandSolder
D2: 1N4001; D_0805_2012Metric_Pad1.15x1.40mm_HandSolder
F1: Polyfuse 1.1A (1812L); L_1812_4532Metric_Pad1.30x3.40mm_HandSolder
FB1: 1K, 100MHz; L_0805_2012Metric_Pad1.15x1.40mm_HandSolder
J5: PowerTest_PinHeader; PinHeader_1x03_P2.54mm_Vertical
J6: 9V Power JST XH; JST_XH_B2B-XH-A_1x02_P2.50mm_Vertical
NT1: Net-Tie_2; NetTie-2_SMD_Pad2.0mm
R4: 1K; R_0805_2012Metric_Pad1.15x1.40mm_HandSolder
U1: AMS1117-5.0; SOT-223-3_TabPin2

Connections:
+5V: C3.1, J5.2, U1.2 (VO); also elsewhere on the board
+9V: D2.2 (A), J6.2
/+9V_SAFE: C2.1, FB1.2, J5.1, R4.1, U1.3 (VI); also elsewhere on the board
GND: C2.2, C3.2, D1.1 (K), J5.3, J6.1, NT1.1, U1.1 (GND); also elsewhere on the board
GNDA: NT1.2; also elsewhere on the board
unnamed: D1.2 (A), R4.2
unnamed: D2.1 (K), F1.1
unnamed: F1.2, FB1.1

Notes on the sheet:
9V Power
Vfw = 2 V I = (9-2)/1 = 7 mA
5V: LCD: about 60 mA Pd = (9 V - 5V) * 60 mA = 240 mW Tj = Ta(max) + Pd * (Thermal Resistance (junction-to-ambient) = 125 = 30 + Pd * 70 => 1.36 W No heat sink needed
Power Regulator
http://embedded-lab.com/blog/multi-purpose-dual-power-supply-5-0v-and-3-3v-regulator-board/
Power Test Connector
Mixed Grounds
22 uF Tantalum advised -> 47 uf Tantalum in inventory instead
Model: BLM21AG102SN1D' Specs: 600 mA, 25% 1 KOhm, 100 MHz, 0805 According AliExpress: 200 mA

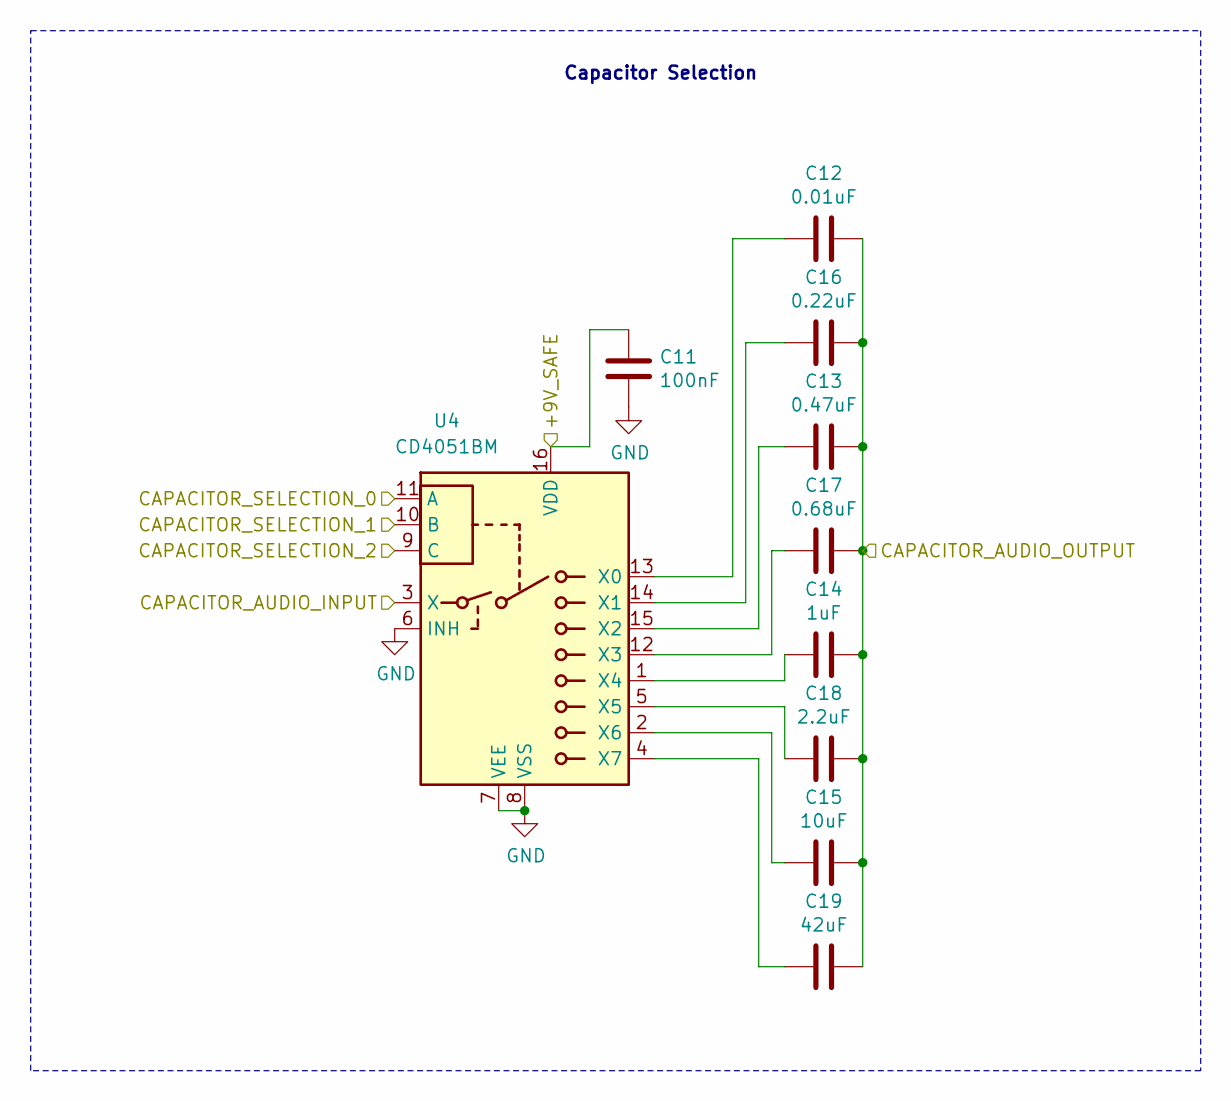
[picture p63: schematic Capacitors.sch, Guitar Pedal Effect Fuzz Digitally Controlled]

Parts:
C11: 100nF; C_0805_2012Metric_Pad1.15x1.40mm_HandSolder
C12: 0.01uF; C_0805_2012Metric_Pad1.15x1.40mm_HandSolder
C13: 0.47uF; C_0805_2012Metric_Pad1.15x1.40mm_HandSolder
C14: 1uF; C_0805_2012Metric_Pad1.15x1.40mm_HandSolder
C15: 10uF; C_0805_2012Metric_Pad1.15x1.40mm_HandSolder
C16: 0.22uF; C_0805_2012Metric_Pad1.15x1.40mm_HandSolder
C17: 0.68uF; C_0805_2012Metric_Pad1.15x1.40mm_HandSolder
C18: 2.2uF; C_0805_2012Metric_Pad1.15x1.40mm_HandSolder
C19: 42uF; C_0805_2012Metric_Pad1.15x1.40mm_HandSolder
U4: CD4051BM; SOIC-16_3.9x9.9mm_P1.27mm

Connections:
/+9V_SAFE: C11.1, U4.16 (VDD); also elsewhere on the board
/CAPACITOR_A_SELECTION_0: U4.11 (A); also elsewhere on the board
/CAPACITOR_A_SELECTION_1: U4.10 (B); also elsewhere on the board
/CAPACITOR_A_SELECTION_2: U4.9 (C); also elsewhere on the board
/JACK_IN_SIGNAL_THROUGH_FUZZ: U4.3 (X); also elsewhere on the board
/TransistorsB/BASE: C12.1, C13.1, C14.1, C15.1, C16.1, C17.1, C18.1, C19.1; also elsewhere on the board
GND: C11.2, U4.6 (INH), U4.7 (VEE), U4.8 (VSS); also elsewhere on the board
unnamed: C12.2, U4.13 (X0)
unnamed: C13.2, U4.15 (X2)
unnamed: C14.2, U4.1 (X4)
unnamed: C15.2, U4.2 (X6)
unnamed: C16.2, U4.14 (X1)
unnamed: C17.2, U4.12 (X3)
unnamed: C18.2, U4.5 (X5)
unnamed: C19.2, U4.4 (X7)

Parts of its further copies:
C36: 100nF; C_0805_2012Metric_Pad1.15x1.40mm_HandSolder
C37: 0.01uF; C_0805_2012Metric_Pad1.15x1.40mm_HandSolder
C38: 0.47uF; C_0805_2012Metric_Pad1.15x1.40mm_HandSolder
C39: 1uF; C_0805_2012Metric_Pad1.15x1.40mm_HandSolder
C40: 10uF; C_0805_2012Metric_Pad1.15x1.40mm_HandSolder
C41: 0.22uF; C_0805_2012Metric_Pad1.15x1.40mm_HandSolder
C42: 0.68uF; C_0805_2012Metric_Pad1.15x1.40mm_HandSolder
C43: 2.2uF; C_0805_2012Metric_Pad1.15x1.40mm_HandSolder
C44: 42uF; C_0805_2012Metric_Pad1.15x1.40mm_HandSolder
U21: CD4051BM; SOIC-16_3.9x9.9mm_P1.27mm

Connections of its further copies:
/+9V_SAFE: C36.1, U21.16 (VDD); also elsewhere on the board
/CAPACITOR_D_SELECTION_0: U21.11 (A); also elsewhere on the board
/CAPACITOR_D_SELECTION_1: U21.10 (B); also elsewhere on the board
/CAPACITOR_D_SELECTION_2: U21.9 (C); also elsewhere on the board
/CapacitorsD/CAPACITOR_AUDIO_INPUT: U21.3 (X); also elsewhere on the board
/CapacitorsD/CAPACITOR_AUDIO_OUTPUT: C37.1, C38.1, C39.1, C40.1, C41.1, C42.1, C43.1, C44.1; also elsewhere on the board
GND: C36.2, U21.6 (INH), U21.7 (VEE), U21.8 (VSS); also elsewhere on the board
unnamed: C37.2, U21.13 (X0)
unnamed: C38.2, U21.15 (X2)
unnamed: C39.2, U21.1 (X4)
unnamed: C40.2, U21.2 (X6)
unnamed: C41.2, U21.14 (X1)
unnamed: C42.2, U21.12 (X3)
unnamed: C43.2, U21.5 (X5)
unnamed: C44.2, U21.4 (X7)

Notes on the sheet:
Capacitor Selection

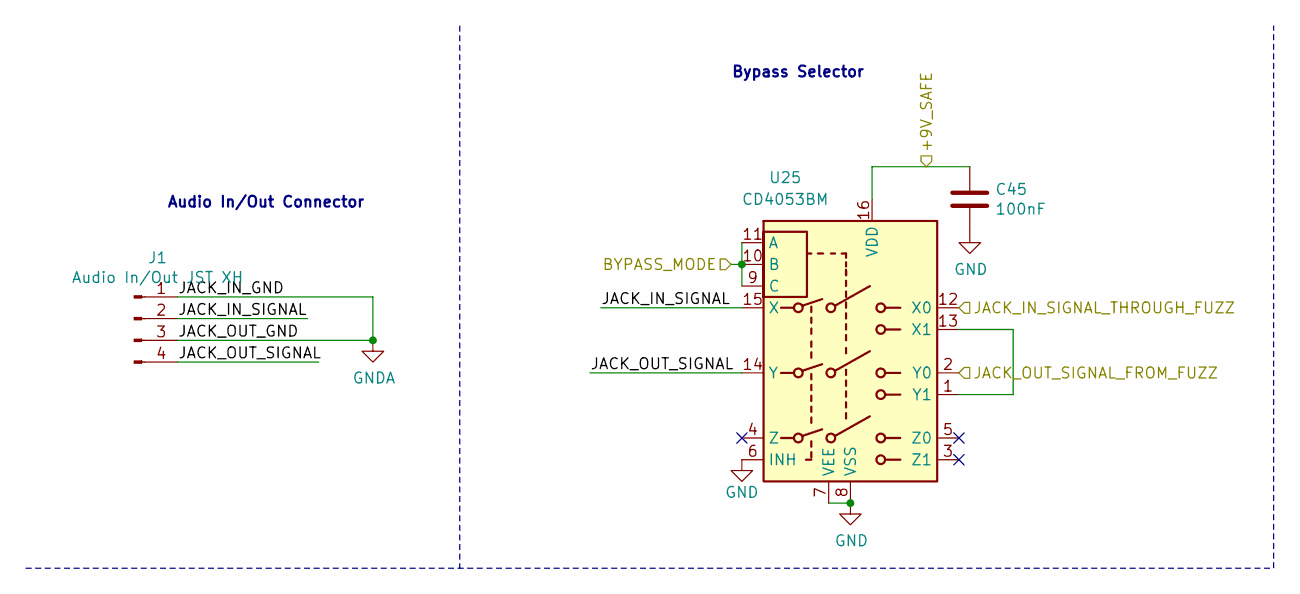
[picture p64: schematic AudioInOut.sch]

Parts:
C45: 100nF; C_0805_2012Metric_Pad1.15x1.40mm_HandSolder
J1: Audio In/Out JST XH; JST_XH_B4B-XH-A_1x04_P2.50mm_Vertical
U25: CD4053BM; SOIC-16_3.9x9.9mm_P1.27mm

Connections:
/+9V_SAFE: C45.1, U25.16 (VDD); also elsewhere on the board
/AudioInOut/JACK_IN_SIGNAL: J1.2, U25.15 (X)
/AudioInOut/JACK_OUT_SIGNAL: J1.4, U25.14 (Y)
/BYPASS_MODE: U25.9 (C), U25.10 (B), U25.11 (A); also elsewhere on the board
/JACK_IN_SIGNAL_THROUGH_FUZZ: U25.12 (X0); also elsewhere on the board
/JACK_OUT_SIGNAL_FROM_FUZZ: U25.2 (Y0); also elsewhere on the board
GND: C45.2, U25.6 (INH), U25.7 (VEE), U25.8 (VSS); also elsewhere on the board
GNDA: J1.1, J1.3; also elsewhere on the board
unnamed: U25.1 (Y1), U25.13 (X1)

Notes on the sheet:
Bypass Selector
Audio In/Out Connector

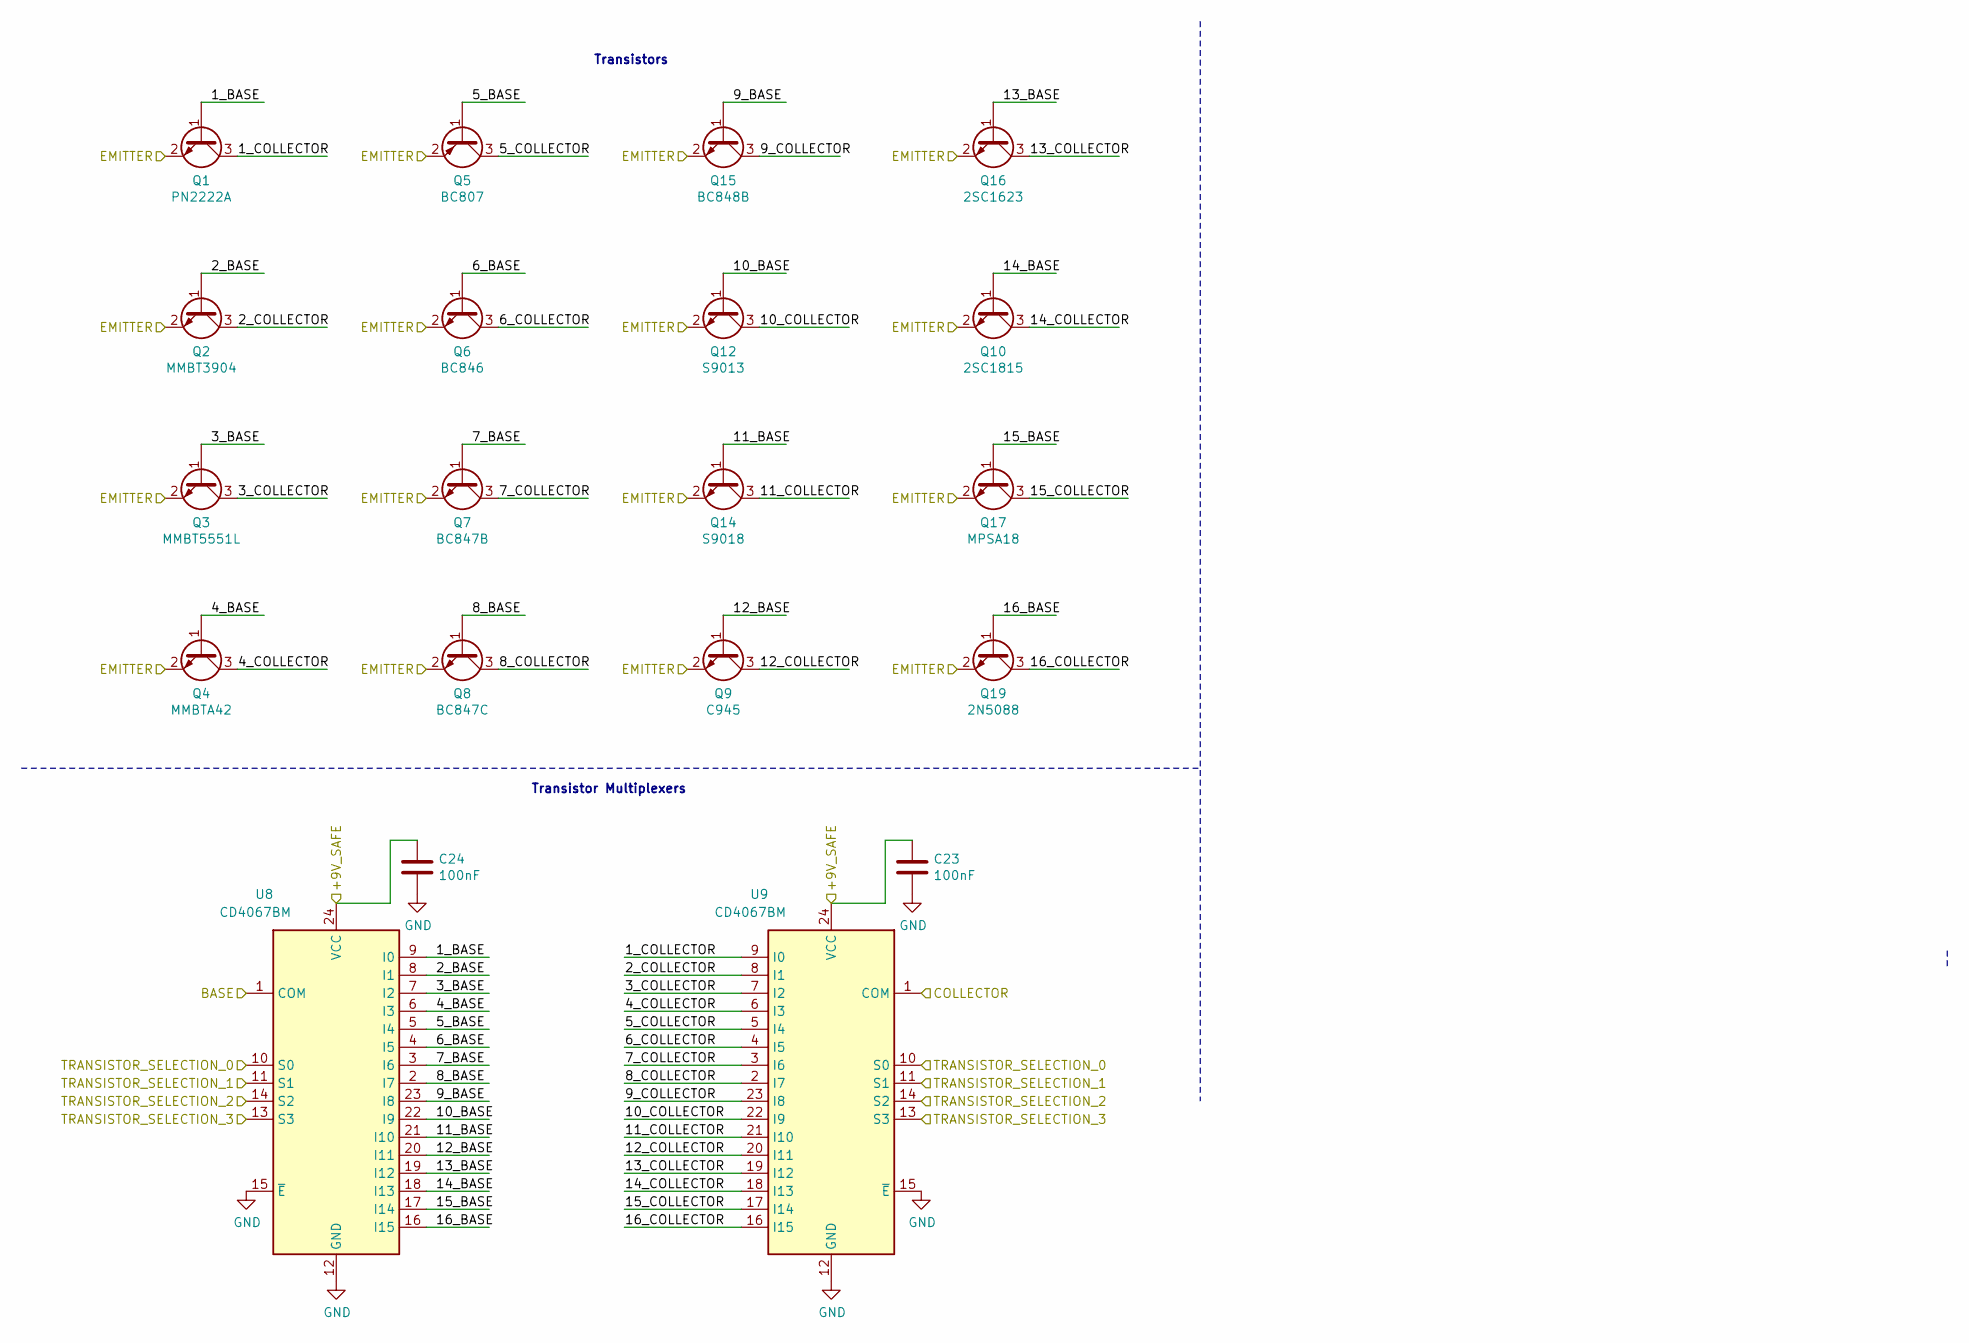
[picture p65: schematic Transistors.sch, Guitar Pedal Effect Fuzz Digitally Controlled]

Parts:
C23, C24: 100nF; C_0805_2012Metric_Pad1.15x1.40mm_HandSolder
Q1: PN2222A; SOT-23_Handsoldering
Q2: MMBT3904; SOT-23_Handsoldering
Q3: MMBT5551L; SOT-23_Handsoldering
Q4: MMBTA42; SOT-23_Handsoldering
Q5: BC807; SOT-23_Handsoldering
Q6: BC846; SOT-23_Handsoldering
Q7: BC847B; SOT-23_Handsoldering
Q8: BC847C; SOT-23_Handsoldering
Q9: C945; SOT-23_Handsoldering
Q10: 2SC1815; SOT-23_Handsoldering
Q12: S9013; SOT-23_Handsoldering
Q14: S9018; SOT-23_Handsoldering
Q15: BC848B; SOT-23_Handsoldering
Q16: 2SC1623; SOT-23_Handsoldering
Q17: MPSA18; TO-92_Inline
Q19: 2N5088; TO-92_Inline
U8, U9: CD4067BM; SOIC-24W_7.5x15.4mm_P1.27mm

Connections:
/+9V_SAFE: C23.1, C24.1, U8.24 (VCC), U9.24 (VCC); also elsewhere on the board
/TRANSISTOR_B_SELECTION_0: U8.10 (S0), U9.10 (S0); also elsewhere on the board
/TRANSISTOR_B_SELECTION_1: U8.11 (S1), U9.11 (S1); also elsewhere on the board
/TRANSISTOR_B_SELECTION_2: U8.14 (S2), U9.14 (S2); also elsewhere on the board
/TRANSISTOR_B_SELECTION_3: U8.13 (S3), U9.13 (S3); also elsewhere on the board
/TransistorsB/1_BASE: Q1.1 (B), U8.9 (I0)
/TransistorsB/1_COLLECTOR: Q1.3 (C), U9.9 (I0)
/TransistorsB/2_BASE: Q2.1 (B), U8.8 (I1)
/TransistorsB/2_COLLECTOR: Q2.3 (C), U9.8 (I1)
/TransistorsB/3_BASE: Q3.1 (B), U8.7 (I2)
/TransistorsB/3_COLLECTOR: Q3.3 (C), U9.7 (I2)
/TransistorsB/4_BASE: Q4.1 (B), U8.6 (I3)
/TransistorsB/4_COLLECTOR: Q4.3 (C), U9.6 (I3)
/TransistorsB/5_BASE: Q5.1 (B), U8.5 (I4)
/TransistorsB/5_COLLECTOR: Q5.3 (C), U9.5 (I4)
/TransistorsB/6_BASE: Q6.1 (B), U8.4 (I5)
/TransistorsB/6_COLLECTOR: Q6.3 (C), U9.4 (I5)
/TransistorsB/7_BASE: Q7.1 (B), U8.3 (I6)
/TransistorsB/7_COLLECTOR: Q7.3 (C), U9.3 (I6)
/TransistorsB/8_BASE: Q8.1 (B), U8.2 (I7)
/TransistorsB/8_COLLECTOR: Q8.3 (C), U9.2 (I7)
/TransistorsB/9_BASE: Q15.1 (B), U8.23 (I8)
/TransistorsB/9_COLLECTOR: Q15.3 (C), U9.23 (I8)
/TransistorsB/10_BASE: Q12.1 (B), U8.22 (I9)
/TransistorsB/10_COLLECTOR: Q12.3 (C), U9.22 (I9)
/TransistorsB/11_BASE: Q14.1 (B), U8.21 (I10)
/TransistorsB/11_COLLECTOR: Q14.3 (C), U9.21 (I10)
/TransistorsB/12_BASE: Q9.1 (B), U8.20 (I11)
/TransistorsB/12_COLLECTOR: Q9.3 (C), U9.20 (I11)
/TransistorsB/13_BASE: Q16.1 (B), U8.19 (I12)
/TransistorsB/13_COLLECTOR: Q16.3 (C), U9.19 (I12)
/TransistorsB/14_BASE: Q10.1 (B), U8.18 (I13)
/TransistorsB/14_COLLECTOR: Q10.3 (C), U9.18 (I13)
/TransistorsB/15_BASE: Q17.1 (B), U8.17 (I14)
/TransistorsB/15_COLLECTOR: Q17.3 (C), U9.17 (I14)
/TransistorsB/16_BASE: Q19.1 (B), U8.16 (I15)
/TransistorsB/16_COLLECTOR: Q19.3 (C), U9.16 (I15)
/TransistorsB/BASE: U8.1 (COM); also elsewhere on the board
/TransistorsC/BASE: U9.1 (COM); also elsewhere on the board
GND: C23.2, C24.2, U8.12 (GND), U8.15 (~E), U9.12 (GND), U9.15 (~E); also elsewhere on the board
GNDA: Q1.2 (E), Q2.2 (E), Q3.2 (E), Q4.2 (E), Q5.2 (E), Q6.2 (E), Q7.2 (E), Q8.2 (E), Q9.2 (E), Q10.2 (E), Q12.2 (E), Q14.2 (E), Q15.2 (E), Q16.2 (E), Q17.2 (E), Q19.2 (E); also elsewhere on the board

Parts of its further copies:
C21, C22, C31: 100nF; C_0805_2012Metric_Pad1.15x1.40mm_HandSolder
Q11: PN2222A; SOT-23_Handsoldering
Q13: MMBT3904; SOT-23_Handsoldering
Q18: MMBT5551L; SOT-23_Handsoldering
Q20: MMBTA42; SOT-23_Handsoldering
Q24: BC847C; SOT-23_Handsoldering
Q25, Q35: BC848B; SOT-23_Handsoldering
Q26: S9013; SOT-23_Handsoldering
Q27, Q34: S9018; SOT-23_Handsoldering
Q28: C945; SOT-23_Handsoldering
Q30: 2SC1815; SOT-23_Handsoldering
Q31, Q37: MPSA18; TO-92_Inline
Q36: 2SC1623; SOT-23_Handsoldering
Q39: 2N5088; TO-92_Inline
U6, U7: CD4067BM; SOIC-24W_7.5x15.4mm_P1.27mm

Connections of its further copies:
/+9V_SAFE: C21.1, C22.1, U6.24 (VCC), U7.24 (VCC); also elsewhere on the board
/B10K: Q11.2 (E), Q13.2 (E), Q18.2 (E), Q20.2 (E), Q24.2 (E), Q25.2 (E), Q26.2 (E), Q27.2 (E), Q28.2 (E), Q30.2 (E), Q31.2 (E); also elsewhere on the board
/CapacitorsD/CAPACITOR_AUDIO_INPUT: U7.1 (COM); also elsewhere on the board
/TRANSISTOR_C_SELECTION_0: U6.10 (S0), U7.10 (S0); also elsewhere on the board
/TRANSISTOR_C_SELECTION_1: U6.11 (S1), U7.11 (S1); also elsewhere on the board
/TRANSISTOR_C_SELECTION_2: U6.14 (S2), U7.14 (S2); also elsewhere on the board
/TRANSISTOR_C_SELECTION_3: U6.13 (S3), U7.13 (S3); also elsewhere on the board
/TransistorsC/1_BASE: Q11.1 (B), U6.9 (I0)
/TransistorsC/1_COLLECTOR: Q11.3 (C), U7.9 (I0)
/TransistorsC/2_BASE: Q13.1 (B), U6.8 (I1)
/TransistorsC/2_COLLECTOR: Q13.3 (C), U7.8 (I1)
/TransistorsC/3_BASE: Q18.1 (B), U6.7 (I2)
/TransistorsC/3_COLLECTOR: Q18.3 (C), U7.7 (I2)
/TransistorsC/4_BASE: Q20.1 (B), U6.6 (I3)
/TransistorsC/4_COLLECTOR: Q20.3 (C), U7.6 (I3)
/TransistorsC/5_BASE: U6.5 (I4); also elsewhere on the board
/TransistorsC/5_COLLECTOR: U7.5 (I4); also elsewhere on the board
/TransistorsC/6_BASE: U6.4 (I5); also elsewhere on the board
/TransistorsC/6_COLLECTOR: U7.4 (I5); also elsewhere on the board
/TransistorsC/7_BASE: U6.3 (I6); also elsewhere on the board
/TransistorsC/7_COLLECTOR: U7.3 (I6); also elsewhere on the board
/TransistorsC/8_BASE: Q24.1 (B), U6.2 (I7)
/TransistorsC/8_COLLECTOR: Q24.3 (C), U7.2 (I7)
/TransistorsC/9_BASE: Q25.1 (B), U6.23 (I8)
/TransistorsC/9_COLLECTOR: Q25.3 (C), U7.23 (I8)
/TransistorsC/10_BASE: Q26.1 (B), U6.22 (I9)
/TransistorsC/10_COLLECTOR: Q26.3 (C), U7.22 (I9)
/TransistorsC/11_BASE: Q27.1 (B), U6.21 (I10)
/TransistorsC/11_COLLECTOR: Q27.3 (C), U7.21 (I10)
/TransistorsC/12_BASE: Q28.1 (B), U6.20 (I11)
/TransistorsC/12_COLLECTOR: Q28.3 (C), U7.20 (I11)
/TransistorsC/13_BASE: U6.19 (I12); also elsewhere on the board
/TransistorsC/13_COLLECTOR: U7.19 (I12); also elsewhere on the board
/TransistorsC/14_BASE: Q30.1 (B), U6.18 (I13)
/TransistorsC/14_COLLECTOR: Q30.3 (C), U7.18 (I13)
/TransistorsC/15_BASE: Q31.1 (B), U6.17 (I14)
/TransistorsC/15_COLLECTOR: Q31.3 (C), U7.17 (I14)
/TransistorsC/16_BASE: U6.16 (I15); also elsewhere on the board
/TransistorsC/16_COLLECTOR: U7.16 (I15); also elsewhere on the board
/TransistorsC/BASE: U6.1 (COM); also elsewhere on the board
GND: C21.2, C22.2, U6.12 (GND), U6.15 (~E), U7.12 (GND), U7.15 (~E); also elsewhere on the board

Notes on the sheet:
Transistors
Transistor Multiplexers

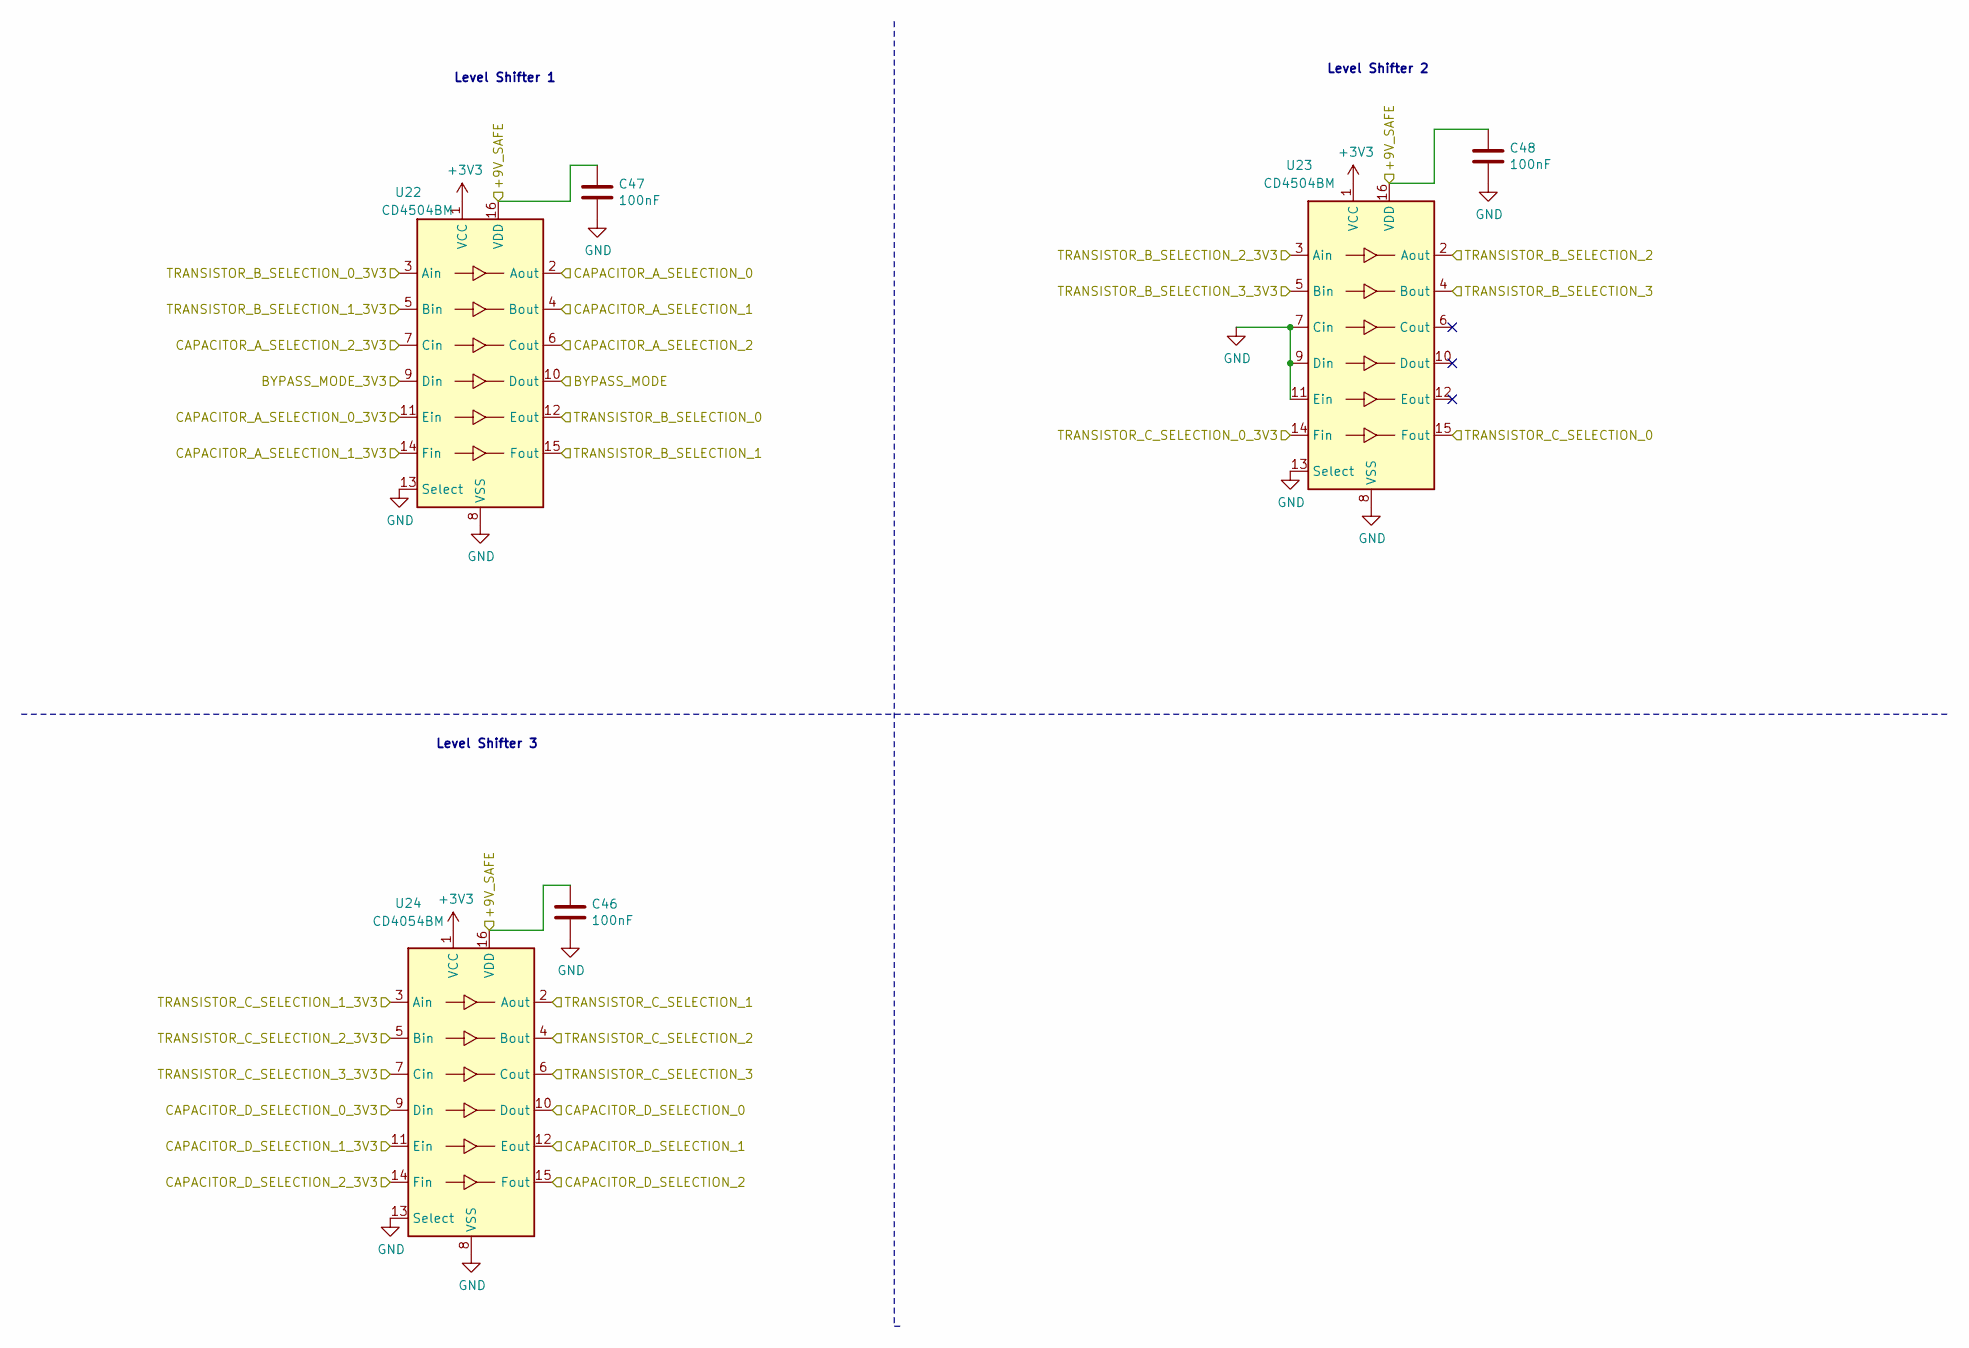
[picture p66: schematic LevelShifter.sch]

Parts:
C46, C47, C48: 100nF; C_0805_2012Metric_Pad1.15x1.40mm_HandSolder
U22, U23: CD4504BM; SOIC-16_3.9x9.9mm_P1.27mm
U24: CD4054BM; SOIC-16_3.9x9.9mm_P1.27mm

Connections:
+3V3: U22.1 (VCC), U23.1 (VCC), U24.1 (VCC); also elsewhere on the board
/+9V_SAFE: C46.1, C47.1, C48.1, U22.16 (VDD), U23.16 (VDD), U24.16 (VDD); also elsewhere on the board
/BYPASS_MODE: U22.10 (Dout); also elsewhere on the board
/BYPASS_MODE_3V3: U22.9 (Din); also elsewhere on the board
/CAPACITOR_A_SELECTION_0: U22.2 (Aout); also elsewhere on the board
/CAPACITOR_A_SELECTION_0_3V3: U22.11 (Ein); also elsewhere on the board
/CAPACITOR_A_SELECTION_1: U22.4 (Bout); also elsewhere on the board
/CAPACITOR_A_SELECTION_1_3V3: U22.14 (Fin); also elsewhere on the board
/CAPACITOR_A_SELECTION_2: U22.6 (Cout); also elsewhere on the board
/CAPACITOR_A_SELECTION_2_3V3: U22.7 (Cin); also elsewhere on the board
/CAPACITOR_D_SELECTION_0: U24.10 (Dout); also elsewhere on the board
/CAPACITOR_D_SELECTION_0_3V3: U24.9 (Din); also elsewhere on the board
/CAPACITOR_D_SELECTION_1: U24.12 (Eout); also elsewhere on the board
/CAPACITOR_D_SELECTION_1_3V3: U24.11 (Ein); also elsewhere on the board
/CAPACITOR_D_SELECTION_2: U24.15 (Fout); also elsewhere on the board
/CAPACITOR_D_SELECTION_2_3V3: U24.14 (Fin); also elsewhere on the board
/TRANSISTOR_B_SELECTION_0: U22.12 (Eout); also elsewhere on the board
/TRANSISTOR_B_SELECTION_0_3V3: U22.3 (Ain); also elsewhere on the board
/TRANSISTOR_B_SELECTION_1: U22.15 (Fout); also elsewhere on the board
/TRANSISTOR_B_SELECTION_1_3V3: U22.5 (Bin); also elsewhere on the board
/TRANSISTOR_B_SELECTION_2: U23.2 (Aout); also elsewhere on the board
/TRANSISTOR_B_SELECTION_2_3V3: U23.3 (Ain); also elsewhere on the board
/TRANSISTOR_B_SELECTION_3: U23.4 (Bout); also elsewhere on the board
/TRANSISTOR_B_SELECTION_3_3V3: U23.5 (Bin); also elsewhere on the board
/TRANSISTOR_C_SELECTION_0: U23.15 (Fout); also elsewhere on the board
/TRANSISTOR_C_SELECTION_0_3V3: U23.14 (Fin); also elsewhere on the board
/TRANSISTOR_C_SELECTION_1: U24.2 (Aout); also elsewhere on the board
/TRANSISTOR_C_SELECTION_1_3V3: U24.3 (Ain); also elsewhere on the board
/TRANSISTOR_C_SELECTION_2: U24.4 (Bout); also elsewhere on the board
/TRANSISTOR_C_SELECTION_2_3V3: U24.5 (Bin); also elsewhere on the board
/TRANSISTOR_C_SELECTION_3: U24.6 (Cout); also elsewhere on the board
/TRANSISTOR_C_SELECTION_3_3V3: U24.7 (Cin); also elsewhere on the board
GND: C46.2, C47.2, C48.2, U22.8 (VSS), U22.13 (Select), U23.7 (Cin), U23.8 (VSS), U23.9 (Din), U23.11 (Ein), U23.13 (Select), U24.8 (VSS), U24.13 (Select); also elsewhere on the board

Notes on the sheet:
Level Shifter 1
Level Shifter 2
Level Shifter 3
