michelkeijzers/FuzzTester2/Kicad/3_Stm32DevBoard/Fuzz.kicad_pcb

## KiCad design Kicad/3_Stm32DevBoard/Fuzz.kicad_pcb (continued)

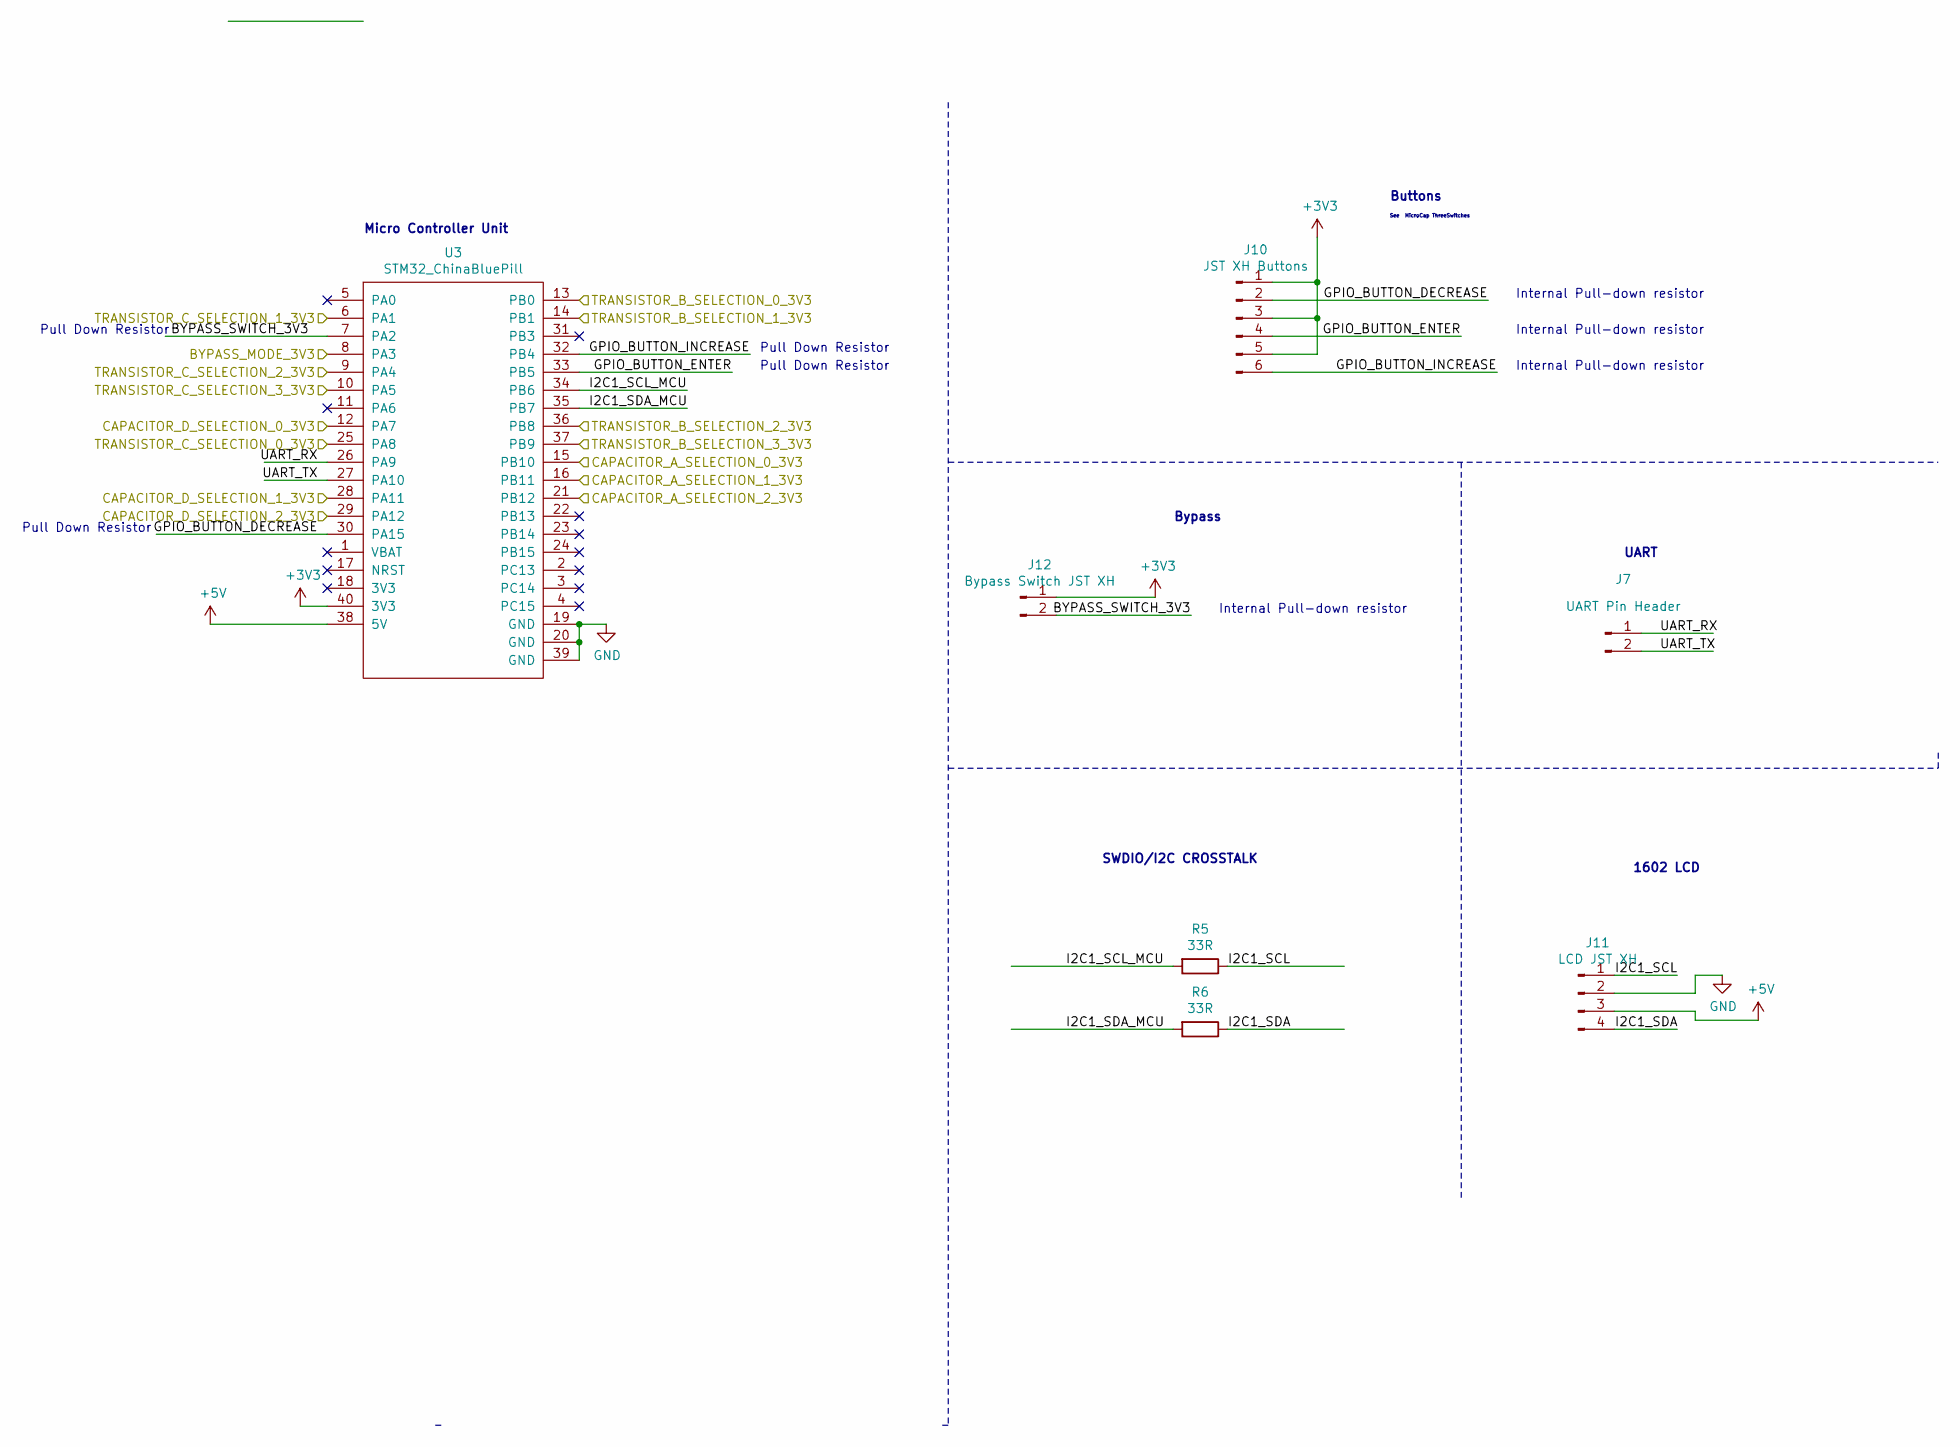
[picture p67: schematic Mcu.sch, Guitar Pedal Effect Fuzz Digitally Controlled]

Parts:
J7: UART Pin Header; PinHeader_1x02_P2.54mm_Vertical
J10: JST XH Buttons; JST_XH_B6B-XH-A_1x06_P2.50mm_Vertical
J11: LCD JST XH; JST_XH_B4B-XH-A_1x04_P2.50mm_Vertical
J12: Bypass Switch JST XH; JST_XH_B2B-XH-A_1x02_P2.50mm_Vertical
R5, R6: 33R; R_0805_2012Metric_Pad1.15x1.40mm_HandSolder
U3: STM32_ChinaBluePill; BluePill_STM32F103C

Connections:
+3V3: J10.1, J10.3, J10.5, J12.1, U3.40 (3V3); also elsewhere on the board
+5V: J11.3, U3.38 (5V); also elsewhere on the board
/BYPASS_MODE_3V3: U3.8 (PA3); also elsewhere on the board
/CAPACITOR_A_SELECTION_0_3V3: U3.15 (PB10); also elsewhere on the board
/CAPACITOR_A_SELECTION_1_3V3: U3.16 (PB11); also elsewhere on the board
/CAPACITOR_A_SELECTION_2_3V3: U3.21 (PB12); also elsewhere on the board
/CAPACITOR_D_SELECTION_0_3V3: U3.12 (PA7); also elsewhere on the board
/CAPACITOR_D_SELECTION_1_3V3: U3.28 (PA11); also elsewhere on the board
/CAPACITOR_D_SELECTION_2_3V3: U3.29 (PA12); also elsewhere on the board
/Mcu/BYPASS_SWITCH_3V3: J12.2, U3.7 (PA2)
/Mcu/GPIO_BUTTON_DECREASE: J10.2, U3.30 (PA15)
/Mcu/GPIO_BUTTON_ENTER: J10.4, U3.33 (PB5)
/Mcu/GPIO_BUTTON_INCREASE: J10.6, U3.32 (PB4)
/Mcu/I2C1_SCL: J11.1, R5.1
/Mcu/I2C1_SCL_MCU: R5.2, U3.34 (PB6)
/Mcu/I2C1_SDA: J11.4, R6.1
/Mcu/I2C1_SDA_MCU: R6.2, U3.35 (PB7)
/Mcu/UART_RX: J7.1, U3.26 (PA9)
/Mcu/UART_TX: J7.2, U3.27 (PA10)
/TRANSISTOR_B_SELECTION_0_3V3: U3.13 (PB0); also elsewhere on the board
/TRANSISTOR_B_SELECTION_1_3V3: U3.14 (PB1); also elsewhere on the board
/TRANSISTOR_B_SELECTION_2_3V3: U3.36 (PB8); also elsewhere on the board
/TRANSISTOR_B_SELECTION_3_3V3: U3.37 (PB9); also elsewhere on the board
/TRANSISTOR_C_SELECTION_0_3V3: U3.25 (PA8); also elsewhere on the board
/TRANSISTOR_C_SELECTION_1_3V3: U3.6 (PA1); also elsewhere on the board
/TRANSISTOR_C_SELECTION_2_3V3: U3.9 (PA4); also elsewhere on the board
/TRANSISTOR_C_SELECTION_3_3V3: U3.10 (PA5); also elsewhere on the board
GND: J11.2, U3.19 (GND), U3.20 (GND), U3.39 (GND); also elsewhere on the board

Notes on the sheet:
1602 LCD
Pull Down Resistor
SWDIO/I2C CROSSTALK
Bypass
See MicroCap ThreeSwitches
Buttons
Internal Pull-down resistor
Micro Controller Unit
UART

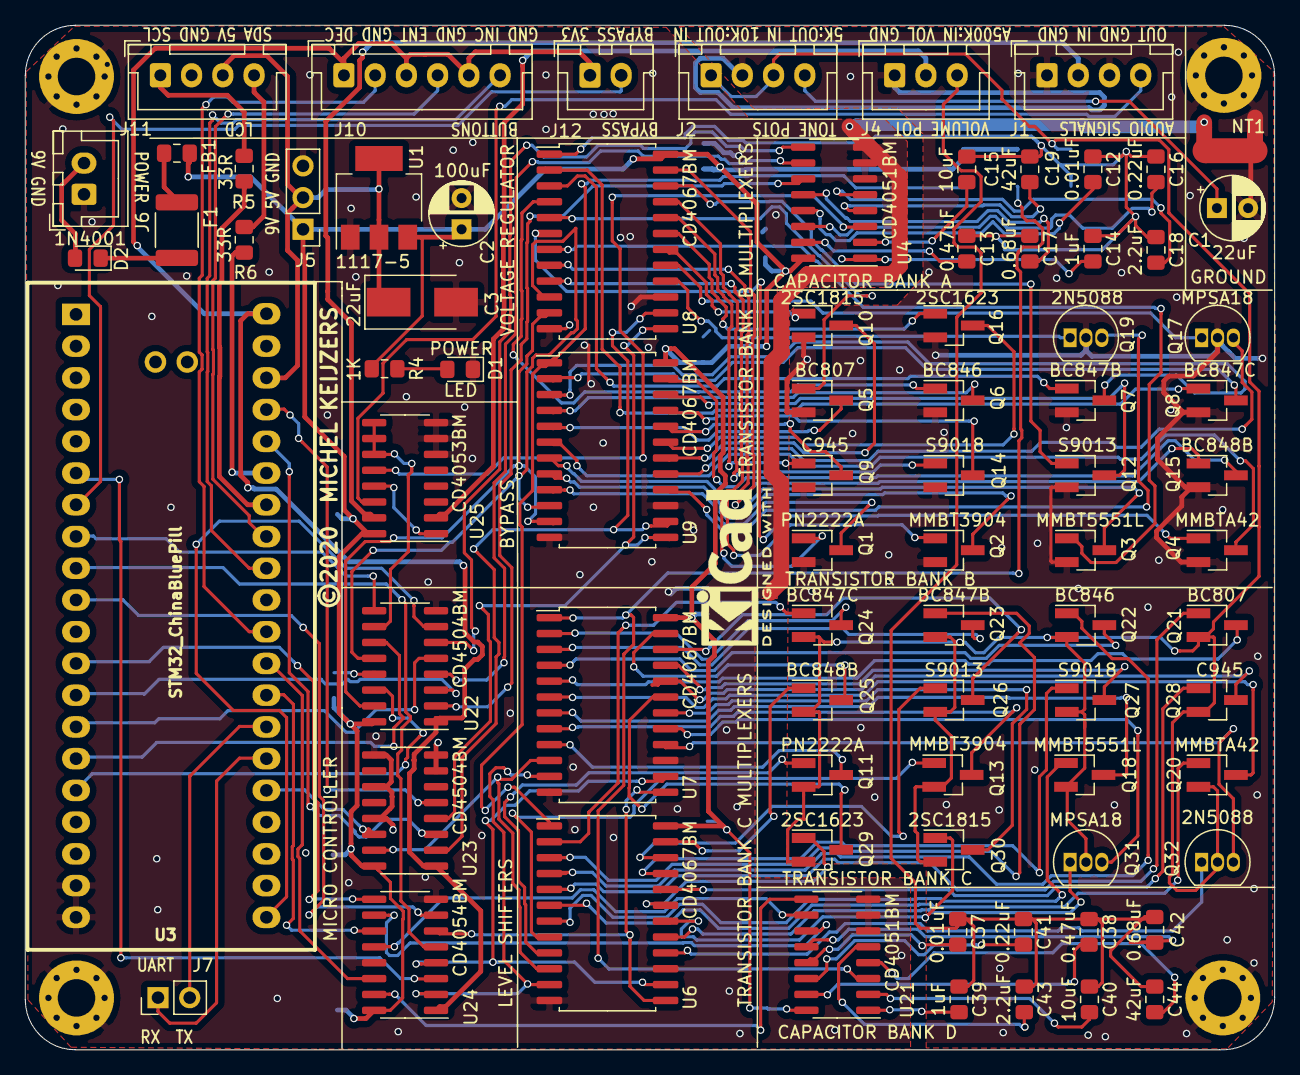
[picture p68: board Kicad/3_Stm32DevBoard/Fuzz.kicad_pcb from above]

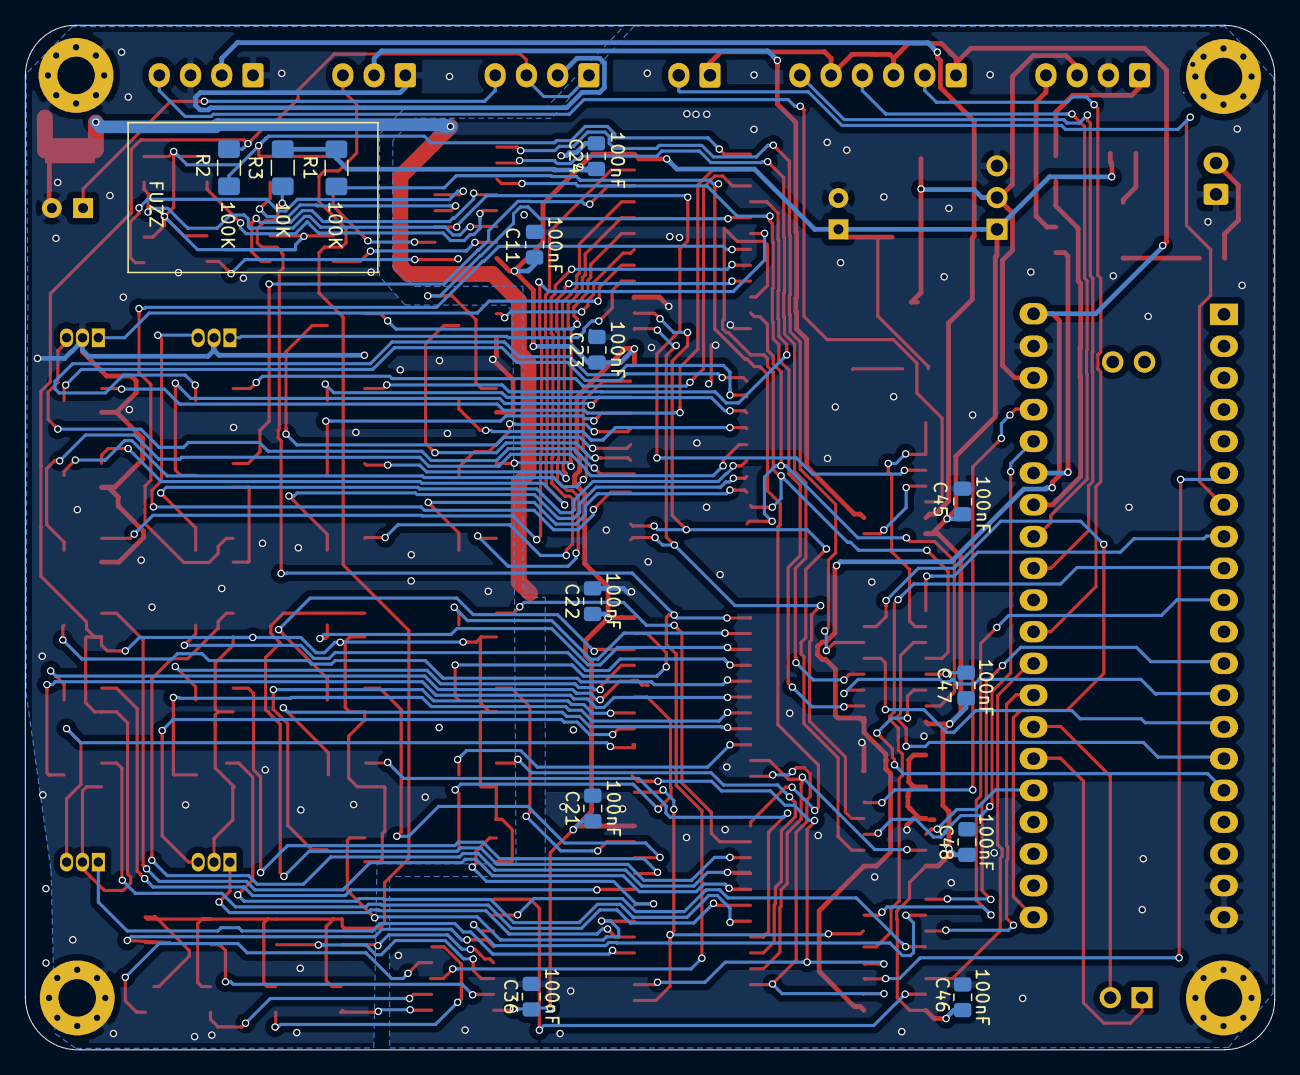
[picture p69: board Kicad/3_Stm32DevBoard/Fuzz.kicad_pcb from below]

Board: 2 copper layers, 100.0 x 82.0 mm, 97 parts (13 on the bottom side), 140 nets.

Other parts of the board:
Q21: BC807; SOT-23_Handsoldering
Q22: BC846; SOT-23_Handsoldering
Q23: BC847B; SOT-23_Handsoldering
Q29: 2SC1623; SOT-23_Handsoldering
Q32: 2N5088; TO-92_Inline

Their connections:
/B10K: Q21.2, Q22.2, Q23.2, Q29.2, Q32.2; also elsewhere on the board
/TransistorsC/5_BASE: Q21.1; also elsewhere on the board
/TransistorsC/5_COLLECTOR: Q21.3; also elsewhere on the board
/TransistorsC/6_BASE: Q22.1; also elsewhere on the board
/TransistorsC/6_COLLECTOR: Q22.3; also elsewhere on the board
/TransistorsC/7_BASE: Q23.1; also elsewhere on the board
/TransistorsC/7_COLLECTOR: Q23.3; also elsewhere on the board
/TransistorsC/13_BASE: Q29.1; also elsewhere on the board
/TransistorsC/13_COLLECTOR: Q29.3; also elsewhere on the board
/TransistorsC/16_BASE: Q32.1; also elsewhere on the board
/TransistorsC/16_COLLECTOR: Q32.3; also elsewhere on the board
