michelkeijzers/FuzzTester2/Kicad/EightBitMuxes/Fuzz.kicad_pcb

## KiCad design Kicad/EightBitMuxes/Fuzz.kicad_pcb (2020-04-24, an earlier design)

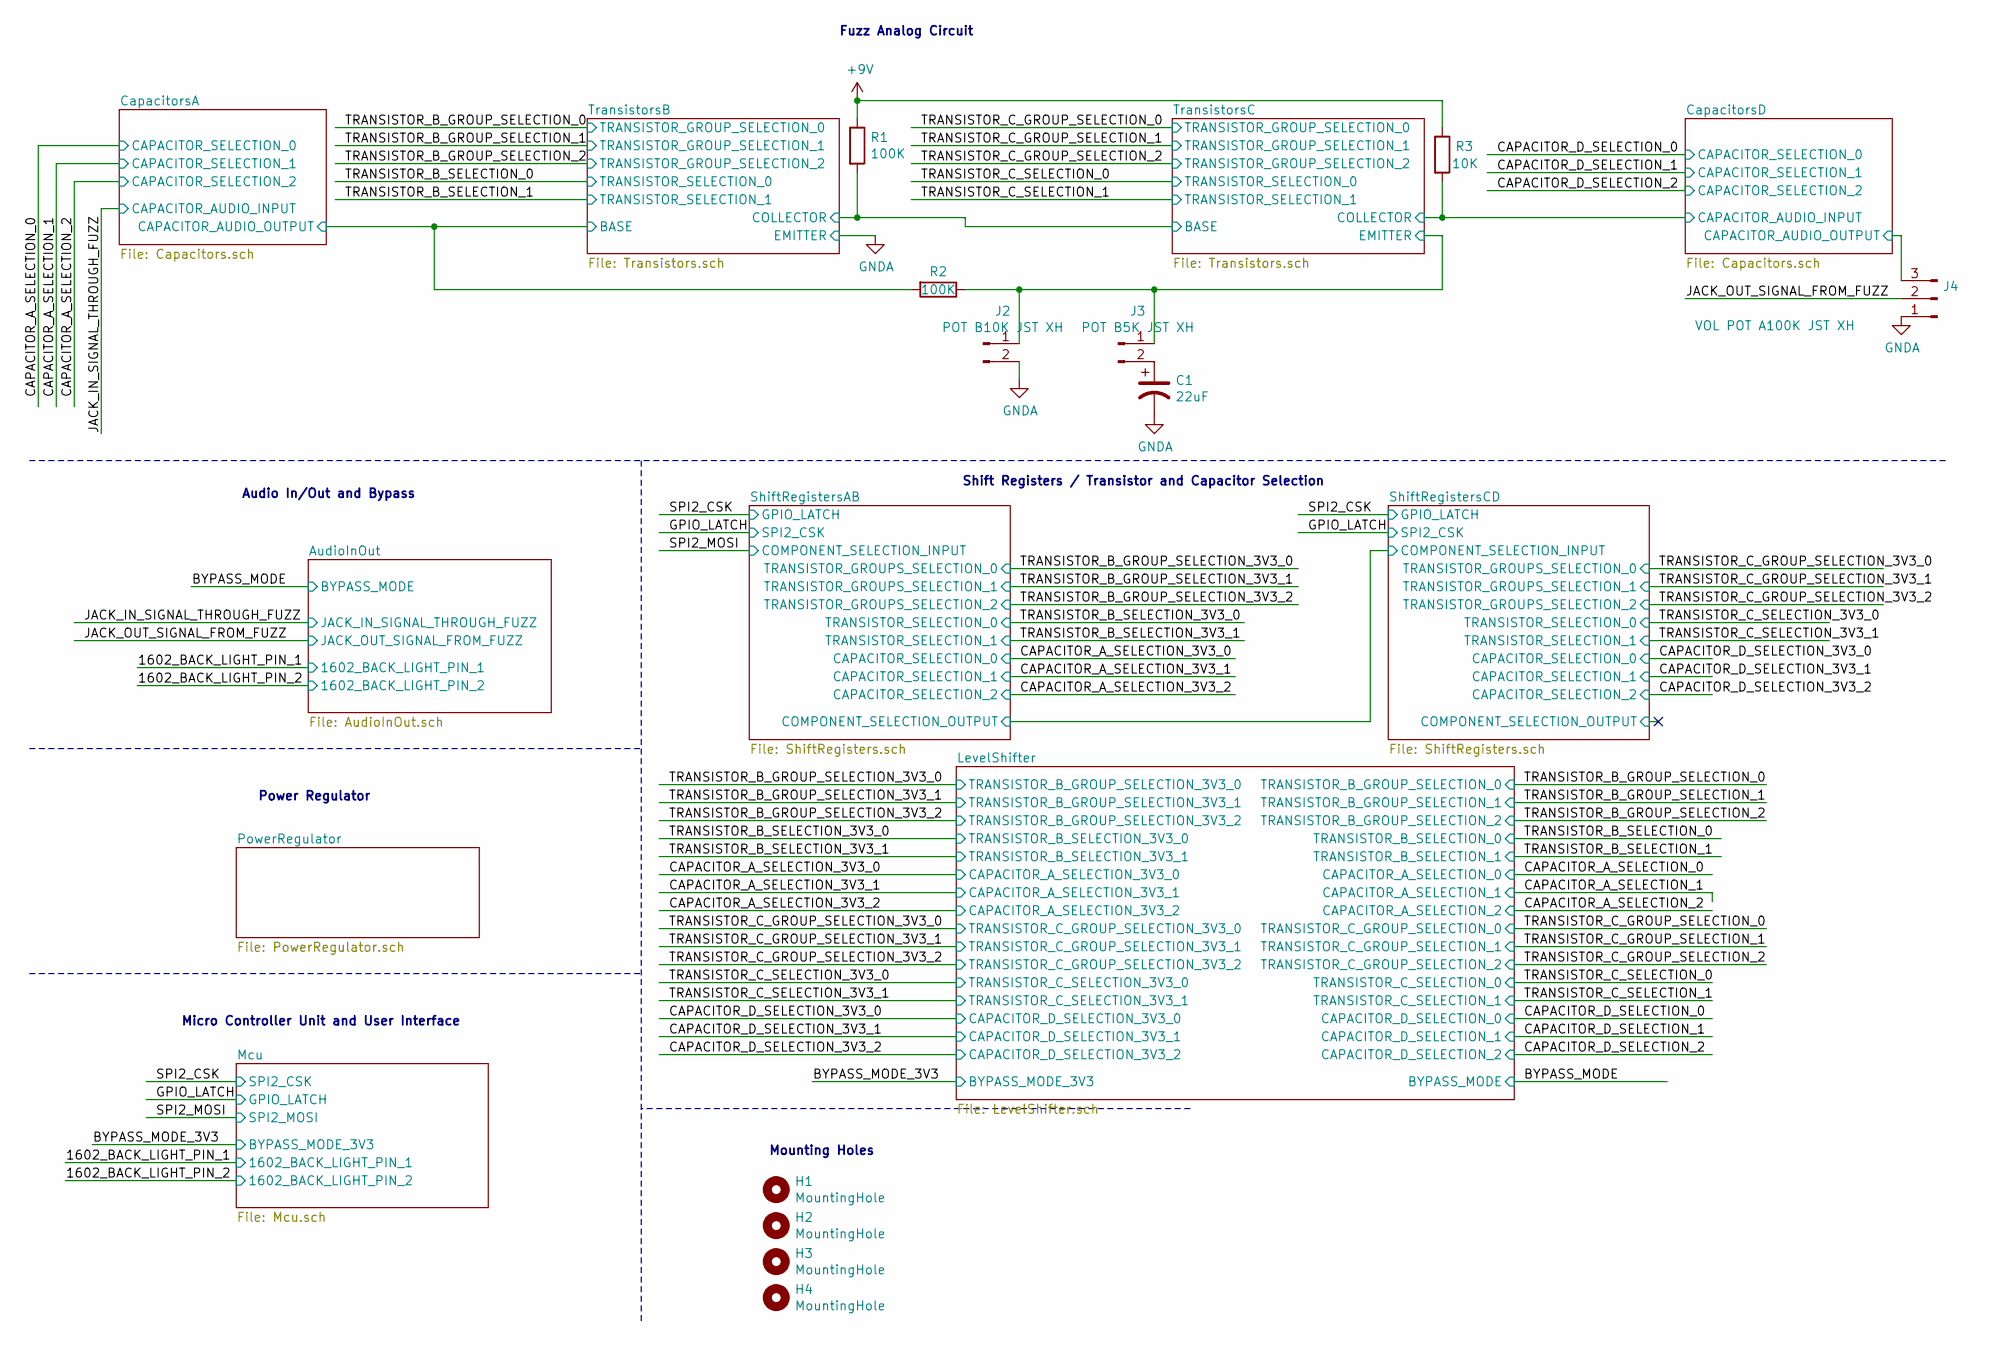
[picture p70: schematic Fuzz.sch, Guitar Pedal Effect Fuzz Digitally Controlled]

Parts:
C1: 22uF; CP_Radial_D5.0mm_P2.50mm
H1, H2, H3, H4: MountingHole; MountingHole_3.2mm_M3
J2: POT B10K JST XH; JST_XH_B2B-XH-A_1x02_P2.50mm_Vertical
J3: POT B5K JST XH; JST_XH_B2B-XH-A_1x02_P2.50mm_Vertical
J4: VOL POT A100K JST XH; JST_XH_B3B-XH-A_1x03_P2.50mm_Vertical
R1, R2: 100K; R_1206_3216Metric_Pad1.42x1.75mm_HandSolder
R3: 10K; R_1206_3216Metric_Pad1.42x1.75mm_HandSolder

Connections:
+9V: R1.1, R3.1; also elsewhere on the board
/CapacitorsD/CAPACITOR_AUDIO_INPUT: R3.2; also elsewhere on the board
/CapacitorsD/CAPACITOR_AUDIO_OUTPUT: J4.3; also elsewhere on the board
/JACK_OUT_SIGNAL_FROM_FUZZ: J4.2; also elsewhere on the board
/TransistorsB/BASE: R2.2; also elsewhere on the board
/TransistorsC/BASE: R1.2; also elsewhere on the board
/TransistorsC/EMITTER: J2.1, J3.1, R2.1; also elsewhere on the board
GNDA: C1.2, J2.2, J4.1; also elsewhere on the board
unnamed: C1.1, J3.2

Notes on the sheet:
Fuzz Analog Circuit
Audio In/Out and Bypass
Shift Registers / Transistor and Capacitor Selection
Power Regulator
Micro Controller Unit and User Interface
Mounting Holes

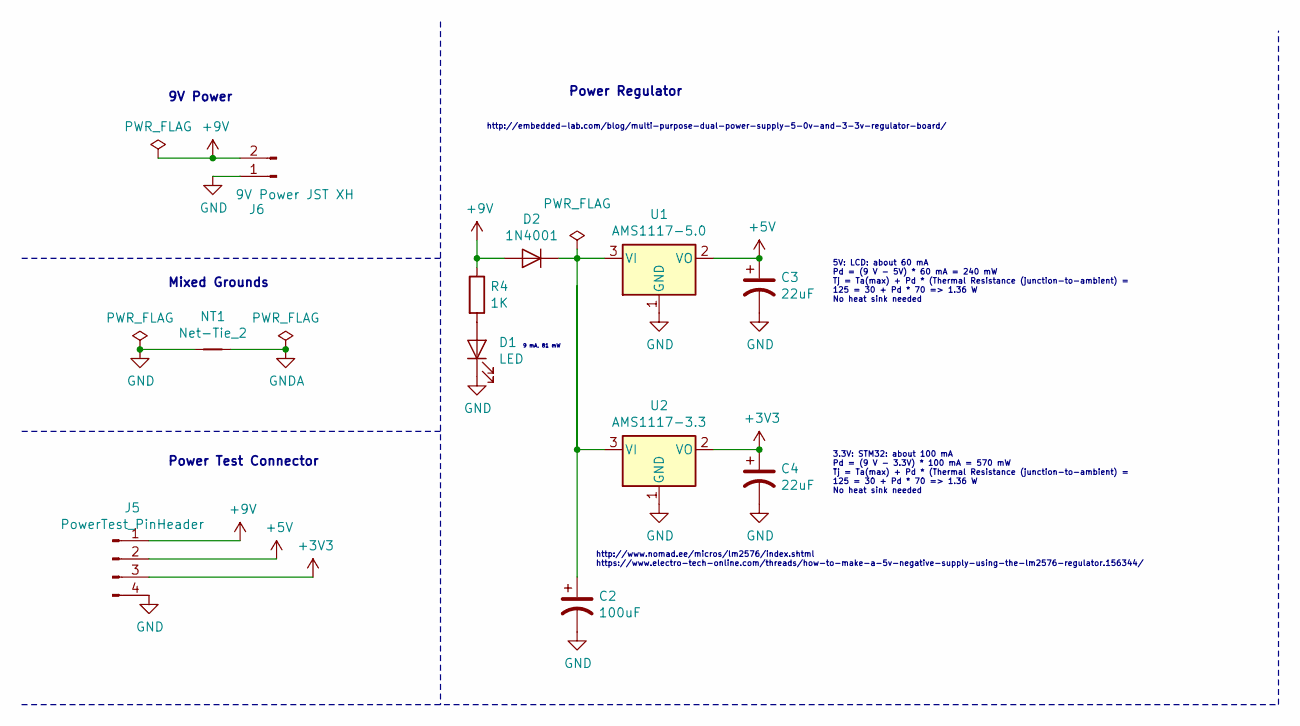
[picture p71: schematic PowerRegulator.sch, Guitar Pedal Effect Fuzz Digitally Controlled]

Parts:
C2: 100uF; CP_Radial_D5.0mm_P2.50mm
C3, C4: 22uF; CP_Radial_D5.0mm_P2.50mm
D1: LED; LED_0805_2012Metric_Pad1.15x1.40mm_HandSolder
D2: 1N4001; D_0805_2012Metric_Pad1.15x1.40mm_HandSolder
J5: PowerTest_PinHeader; PinHeader_1x04_P2.54mm_Vertical
J6: 9V Power JST XH; JST_XH_B2B-XH-A_1x02_P2.50mm_Vertical
NT1: Net-Tie_2; NetTie-2_SMD_Pad2.0mm
R4: 1K; R_0805_2012Metric_Pad1.15x1.40mm_HandSolder
U1: AMS1117-5.0; SOT-223-3_TabPin2
U2: AMS1117-3.3; SOT-223-3_TabPin2

Connections:
+3V3: C4.1, J5.3, U2.2 (VO); also elsewhere on the board
+5V: C3.1, J5.2, U1.2 (VO); also elsewhere on the board
+9V: D2.2 (A), J5.1, J6.2, R4.1; also elsewhere on the board
GND: C2.2, C3.2, C4.2, D1.1 (K), J5.4, J6.1, NT1.1, U1.1 (GND), U2.1 (GND); also elsewhere on the board
GNDA: NT1.2; also elsewhere on the board
unnamed: C2.1, D2.1 (K), U1.3 (VI), U2.3 (VI)
unnamed: D1.2 (A), R4.2

Notes on the sheet:
9V Power
9 mA, 81 mW
5V: LCD: about 60 mA Pd = (9 V - 5V) * 60 mA = 240 mW Tj = Ta(max) + Pd * (Thermal Resistance (junction-to-ambient) = 125 = 30 + Pd * 70 => 1.36 W No heat sink needed
3.3V: STM32: about 100 mA Pd = (9 V - 3.3V) * 100 mA = 570 mW Tj = Ta(max) + Pd * (Thermal Resistance (junction-to-ambient) = 125 = 30 + Pd * 70 => 1.36 W No heat sink needed
Power Regulator
http://embedded-lab.com/blog/multi-purpose-dual-power-supply-5-0v-and-3-3v-regulator-board/
https://www.electro-tech-online.com/threads/how-to-make-a-5v-negative-supply-using-the-lm2576-regulator.156344/
http://www.nomad.ee/micros/lm2576/index.shtml
Power Test Connector
Mixed Grounds

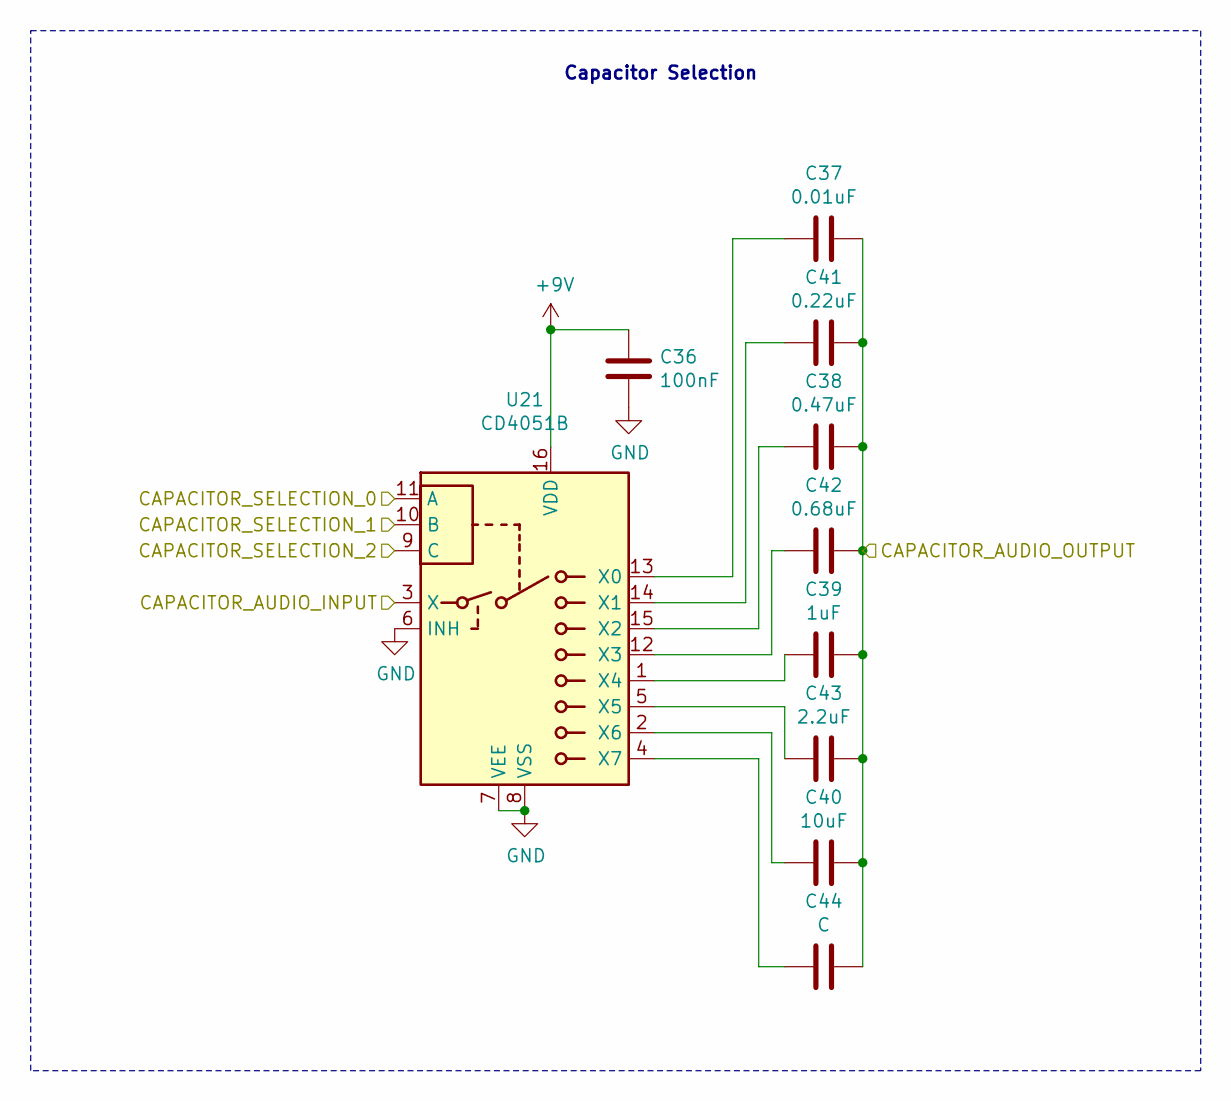
[picture p72: schematic Capacitors.sch, Guitar Pedal Effect Fuzz Digitally Controlled]

Parts:
C11: 100nF; C_0805_2012Metric_Pad1.15x1.40mm_HandSolder
C12: 0.01uF; C_0805_2012Metric_Pad1.15x1.40mm_HandSolder
C13: 0.47uF; C_0805_2012Metric_Pad1.15x1.40mm_HandSolder
C14: 1uF; C_0805_2012Metric_Pad1.15x1.40mm_HandSolder
C15: 10uF; C_0805_2012Metric_Pad1.15x1.40mm_HandSolder
C16: 0.22uF; C_0805_2012Metric_Pad1.15x1.40mm_HandSolder
C17: 0.68uF; C_0805_2012Metric_Pad1.15x1.40mm_HandSolder
C18: 2.2uF; C_0805_2012Metric_Pad1.15x1.40mm_HandSolder
C19: C; C_0805_2012Metric_Pad1.15x1.40mm_HandSolder
U4: CD4051B; SOIC-16_3.9x9.9mm_P1.27mm

Connections:
+9V: C11.1, U4.16 (VDD); also elsewhere on the board
/CAPACITOR_A_SELECTION_0: U4.11 (A); also elsewhere on the board
/CAPACITOR_A_SELECTION_1: U4.10 (B); also elsewhere on the board
/CAPACITOR_A_SELECTION_2: U4.9 (C); also elsewhere on the board
/JACK_IN_SIGNAL_THROUGH_FUZZ: U4.3 (X); also elsewhere on the board
/TransistorsB/BASE: C12.1, C13.1, C14.1, C15.1, C16.1, C17.1, C18.1, C19.1; also elsewhere on the board
GND: C11.2, U4.6 (INH), U4.7 (VEE), U4.8 (VSS); also elsewhere on the board
unnamed: C12.2, U4.13 (X0)
unnamed: C13.2, U4.15 (X2)
unnamed: C14.2, U4.1 (X4)
unnamed: C15.2, U4.2 (X6)
unnamed: C16.2, U4.14 (X1)
unnamed: C17.2, U4.12 (X3)
unnamed: C18.2, U4.5 (X5)
unnamed: C19.2, U4.4 (X7)

Parts of its further copies:
C36: 100nF; C_0805_2012Metric_Pad1.15x1.40mm_HandSolder
C37: 0.01uF; C_0805_2012Metric_Pad1.15x1.40mm_HandSolder
C38: 0.47uF; C_0805_2012Metric_Pad1.15x1.40mm_HandSolder
C39: 1uF; C_0805_2012Metric_Pad1.15x1.40mm_HandSolder
C40: 10uF; C_0805_2012Metric_Pad1.15x1.40mm_HandSolder
C41: 0.22uF; C_0805_2012Metric_Pad1.15x1.40mm_HandSolder
C42: 0.68uF; C_0805_2012Metric_Pad1.15x1.40mm_HandSolder
C43: 2.2uF; C_0805_2012Metric_Pad1.15x1.40mm_HandSolder
C44: C; C_0805_2012Metric_Pad1.15x1.40mm_HandSolder
U21: CD4051B; SOIC-16_3.9x9.9mm_P1.27mm

Connections of its further copies:
+9V: C36.1, U21.16 (VDD); also elsewhere on the board
/CAPACITOR_D_SELECTION_0: U21.11 (A); also elsewhere on the board
/CAPACITOR_D_SELECTION_1: U21.10 (B); also elsewhere on the board
/CAPACITOR_D_SELECTION_2: U21.9 (C); also elsewhere on the board
/CapacitorsD/CAPACITOR_AUDIO_INPUT: U21.3 (X); also elsewhere on the board
/CapacitorsD/CAPACITOR_AUDIO_OUTPUT: C37.1, C38.1, C39.1, C40.1, C41.1, C42.1, C43.1, C44.1; also elsewhere on the board
GND: C36.2, U21.6 (INH), U21.7 (VEE), U21.8 (VSS); also elsewhere on the board
unnamed: C37.2, U21.13 (X0)
unnamed: C38.2, U21.15 (X2)
unnamed: C39.2, U21.1 (X4)
unnamed: C40.2, U21.2 (X6)
unnamed: C41.2, U21.14 (X1)
unnamed: C42.2, U21.12 (X3)
unnamed: C43.2, U21.5 (X5)
unnamed: C44.2, U21.4 (X7)

Notes on the sheet:
Capacitor Selection

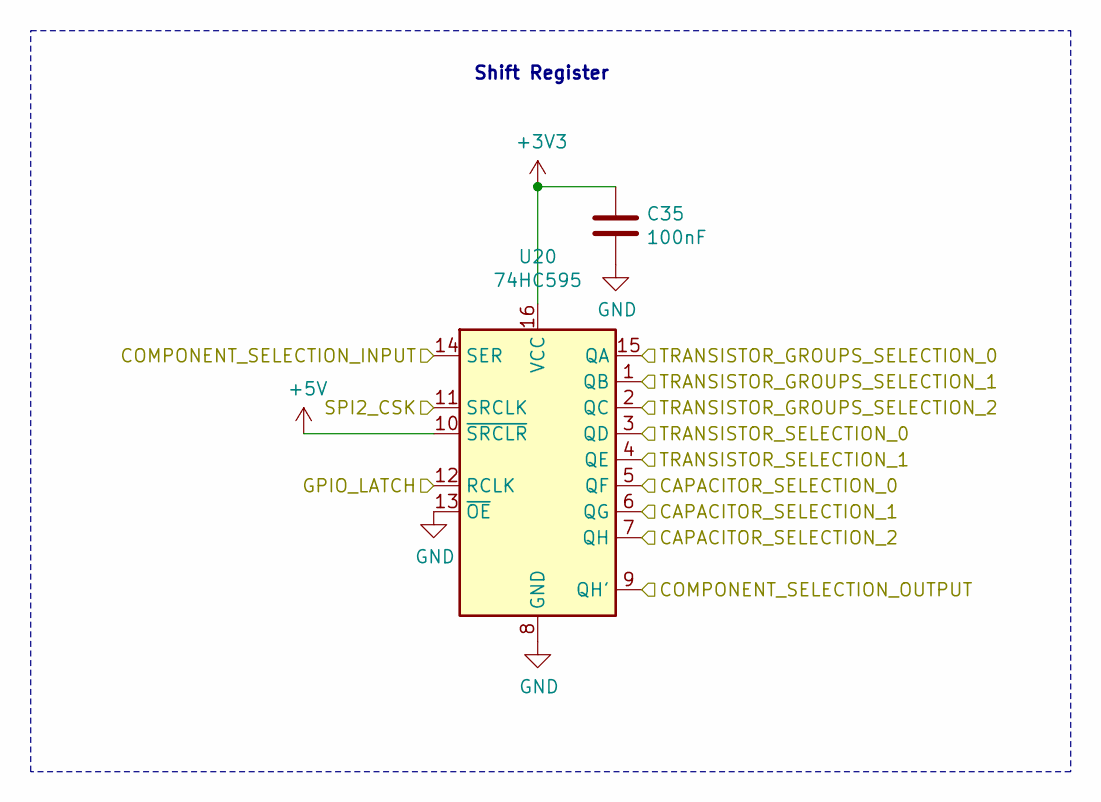
[picture p73: schematic ShiftRegisters.sch, Guitar Pedal Effect Fuzz Digitally Controlled]

Parts:
C20: 100nF; C_0805_2012Metric_Pad1.15x1.40mm_HandSolder
U5: 74HC595; SOIC-16_3.9x9.9mm_P1.27mm

Connections:
+3V3: C20.1, U5.16 (VCC); also elsewhere on the board
+5V: U5.10 (~SRCLR); also elsewhere on the board
/CAPACITOR_A_SELECTION_3V3_0: U5.5 (QF); also elsewhere on the board
/CAPACITOR_A_SELECTION_3V3_1: U5.6 (QG); also elsewhere on the board
/CAPACITOR_A_SELECTION_3V3_2: U5.7 (QH); also elsewhere on the board
/GPIO_LATCH: U5.11 (SRCLK); also elsewhere on the board
/SPI2_CSK: U5.12 (RCLK); also elsewhere on the board
/SPI2_MOSI: U5.14 (SER); also elsewhere on the board
/ShiftRegistersCD/COMPONENT_SELECTION_INPUT: U5.9 (QH'); also elsewhere on the board
/TRANSISTOR_B_GROUP_SELECTION_3V3_0: U5.15 (QA); also elsewhere on the board
/TRANSISTOR_B_GROUP_SELECTION_3V3_1: U5.1 (QB); also elsewhere on the board
/TRANSISTOR_B_GROUP_SELECTION_3V3_2: U5.2 (QC); also elsewhere on the board
/TRANSISTOR_B_SELECTION_3V3_0: U5.3 (QD); also elsewhere on the board
/TRANSISTOR_B_SELECTION_3V3_1: U5.4 (QE); also elsewhere on the board
GND: C20.2, U5.8 (GND), U5.13 (~OE); also elsewhere on the board

Parts of its further copies:
C35: 100nF; C_0805_2012Metric_Pad1.15x1.40mm_HandSolder
U20: 74HC595; SOIC-16_3.9x9.9mm_P1.27mm

Connections of its further copies:
+3V3: C35.1, U20.16 (VCC); also elsewhere on the board
+5V: U20.10 (~SRCLR); also elsewhere on the board
/CAPACITOR_D_SELECTION_3V3_0: U20.5 (QF); also elsewhere on the board
/CAPACITOR_D_SELECTION_3V3_1: U20.6 (QG); also elsewhere on the board
/CAPACITOR_D_SELECTION_3V3_2: U20.7 (QH); also elsewhere on the board
/GPIO_LATCH: U20.11 (SRCLK); also elsewhere on the board
/SPI2_CSK: U20.12 (RCLK); also elsewhere on the board
/ShiftRegistersCD/COMPONENT_SELECTION_INPUT: U20.14 (SER); also elsewhere on the board
/ShiftRegistersCD/COMPONENT_SELECTION_OUTPUT: U20.9 (QH')
/TRANSISTOR_C_GROUP_SELECTION_3V3_0: U20.15 (QA); also elsewhere on the board
/TRANSISTOR_C_GROUP_SELECTION_3V3_1: U20.1 (QB); also elsewhere on the board
/TRANSISTOR_C_GROUP_SELECTION_3V3_2: U20.2 (QC); also elsewhere on the board
/TRANSISTOR_C_SELECTION_3V3_0: U20.3 (QD); also elsewhere on the board
/TRANSISTOR_C_SELECTION_3V3_1: U20.4 (QE); also elsewhere on the board
GND: C35.2, U20.8 (GND), U20.13 (~OE); also elsewhere on the board

Notes on the sheet:
Shift Register
