michelkeijzers/FuzzTester2/Kicad/EightBitMuxes/Fuzz.kicad_pcb

## KiCad design Kicad/EightBitMuxes/Fuzz.kicad_pcb (continued)

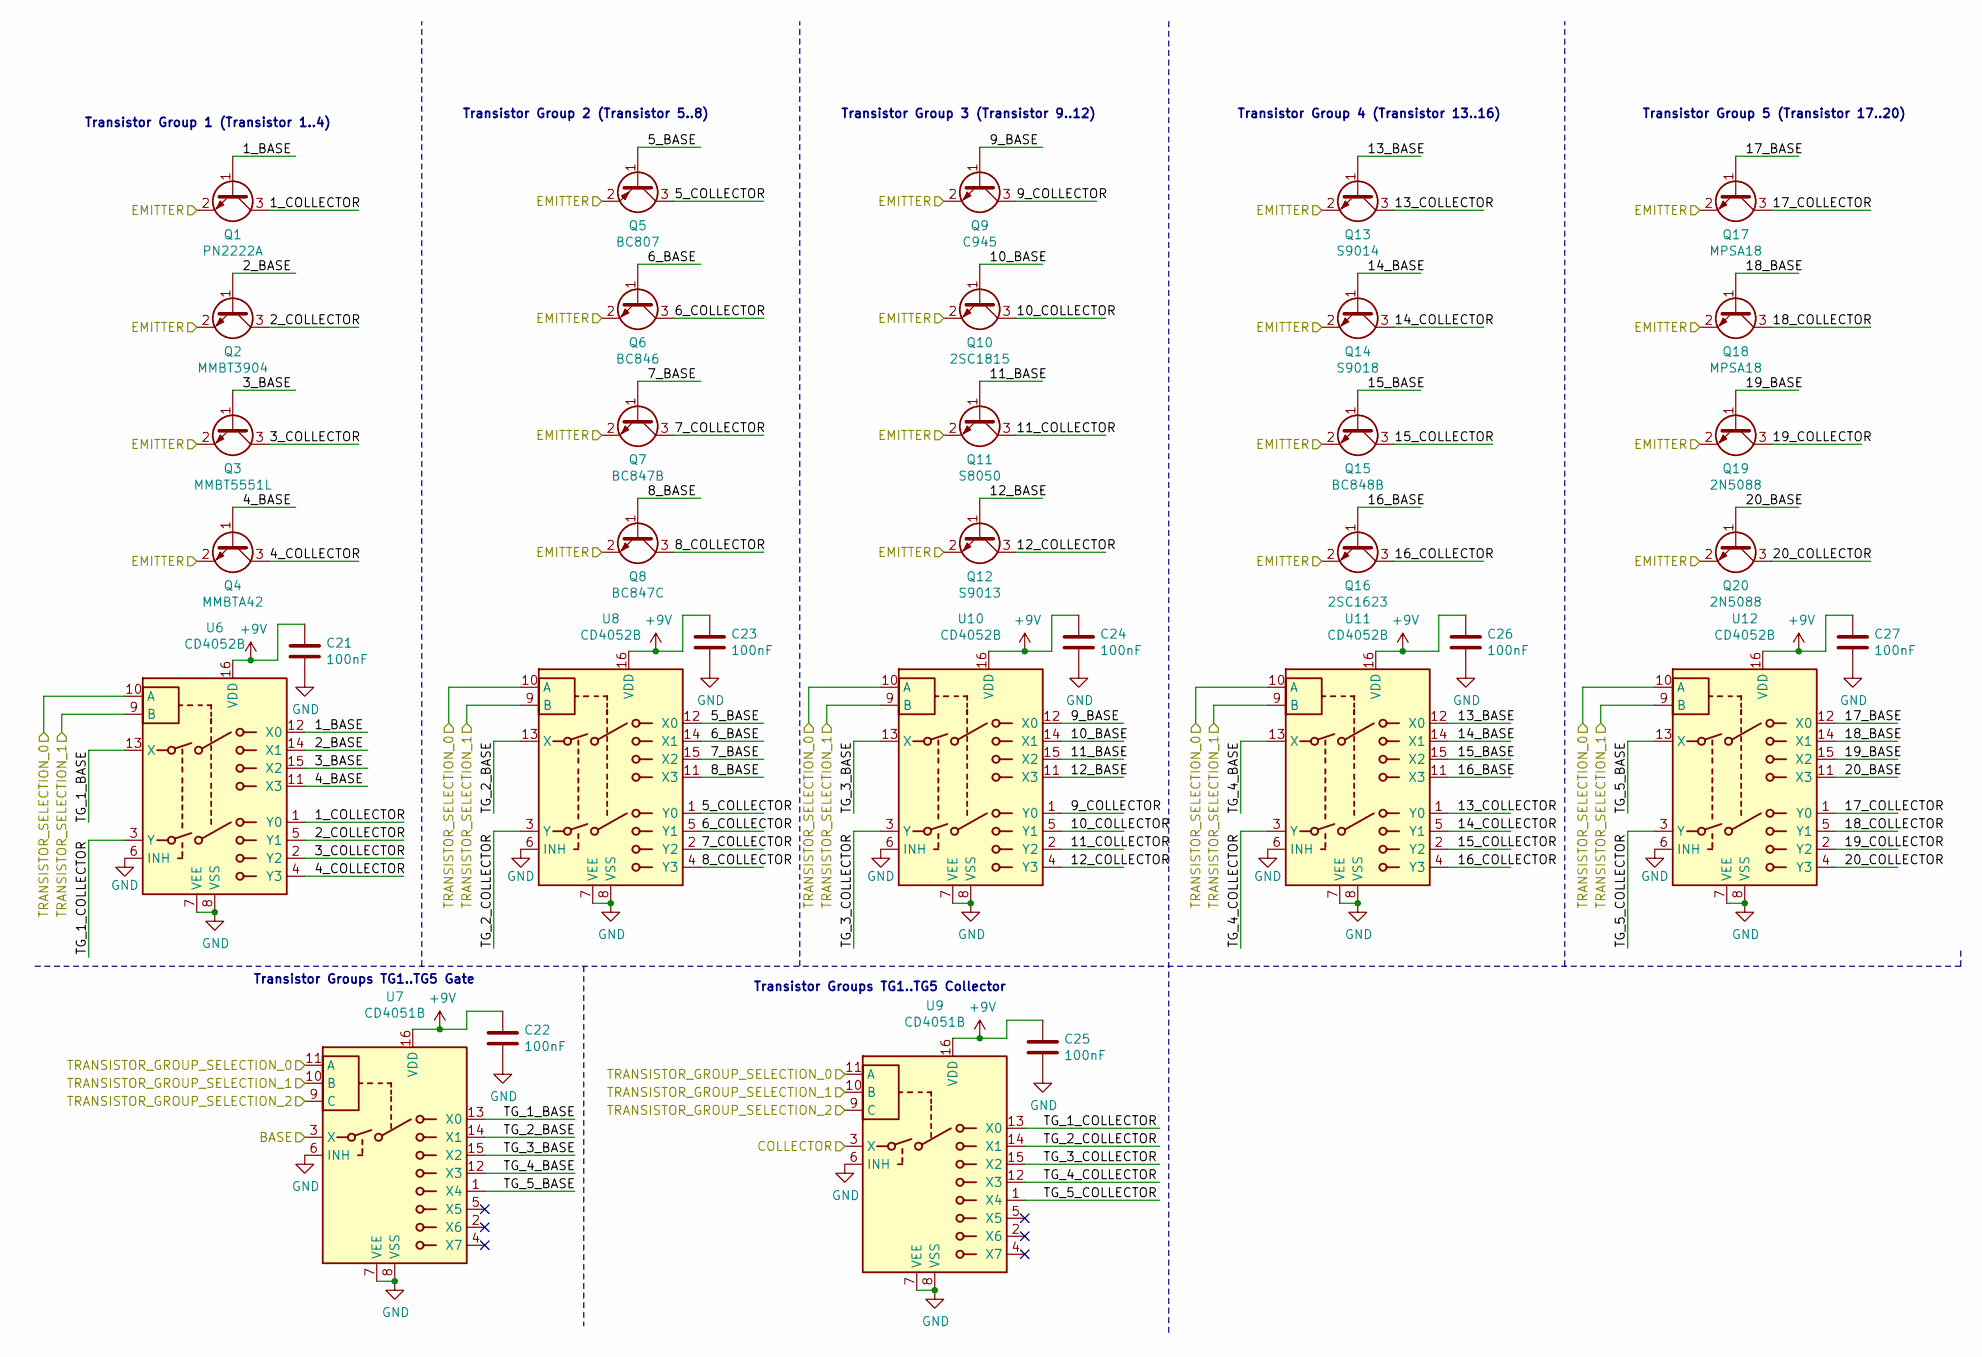
[picture p74: schematic Transistors.sch, Guitar Pedal Effect Fuzz Digitally Controlled]

Parts:
C21, C22, C23, C24, C25, C26, C27: 100nF; C_0805_2012Metric_Pad1.15x1.40mm_HandSolder
Q1: PN2222A; SOT-23_Handsoldering
Q2: MMBT3904; SOT-23_Handsoldering
Q3: MMBT5551L; SOT-23_Handsoldering
Q4: MMBTA42; SOT-23_Handsoldering
Q5: BC807; SOT-23_Handsoldering
Q6: BC846; SOT-23_Handsoldering
Q7: BC847B; SOT-23_Handsoldering
Q8: BC847C; SOT-23_Handsoldering
Q9: C945; SOT-23_Handsoldering
Q10: 2SC1815; SOT-23_Handsoldering
Q11: S8050; SOT-23_Handsoldering
Q12: S9013; SOT-23_Handsoldering
Q13: S9014; SOT-23_Handsoldering
Q14: S9018; SOT-23_Handsoldering
Q15: BC848B; SOT-23_Handsoldering
Q16: 2SC1623; SOT-23_Handsoldering
Q17, Q18: MPSA18; TO-92_Inline
Q19, Q20: 2N5088; TO-92_Inline
U6, U8, U10, U11, U12: CD4052B; SOIC-16_3.9x9.9mm_P1.27mm
U7, U9: CD4051B; SOIC-16_3.9x9.9mm_P1.27mm

Connections:
+9V: C21.1, C22.1, C23.1, C24.1, C25.1, C26.1, C27.1, U6.16 (VDD), U7.16 (VDD), U8.16 (VDD), U9.16 (VDD), U10.16 (VDD), U11.16 (VDD), U12.16 (VDD); also elsewhere on the board
/TRANSISTOR_B_GROUP_SELECTION_0: U7.11 (A), U9.11 (A); also elsewhere on the board
/TRANSISTOR_B_GROUP_SELECTION_1: U7.10 (B), U9.10 (B); also elsewhere on the board
/TRANSISTOR_B_GROUP_SELECTION_2: U7.9 (C), U9.9 (C); also elsewhere on the board
/TRANSISTOR_B_SELECTION_0: U6.10 (A), U8.10 (A), U10.10 (A), U11.10 (A), U12.10 (A); also elsewhere on the board
/TRANSISTOR_B_SELECTION_1: U6.9 (B), U8.9 (B), U10.9 (B), U11.9 (B), U12.9 (B); also elsewhere on the board
/TransistorsB/1_BASE: Q1.1 (B), U6.12 (X0)
/TransistorsB/1_COLLECTOR: Q1.3 (C), U6.1 (Y0)
/TransistorsB/2_BASE: Q2.1 (B), U6.14 (X1)
/TransistorsB/2_COLLECTOR: Q2.3 (C), U6.5 (Y1)
/TransistorsB/3_BASE: Q3.1 (B), U6.15 (X2)
/TransistorsB/3_COLLECTOR: Q3.3 (C), U6.2 (Y2)
/TransistorsB/4_BASE: Q4.1 (B), U6.11 (X3)
/TransistorsB/4_COLLECTOR: Q4.3 (C), U6.4 (Y3)
/TransistorsB/5_BASE: Q5.1 (B), U8.12 (X0)
/TransistorsB/5_COLLECTOR: Q5.3 (C), U8.1 (Y0)
/TransistorsB/6_BASE: Q6.1 (B), U8.14 (X1)
/TransistorsB/6_COLLECTOR: Q6.3 (C), U8.5 (Y1)
/TransistorsB/7_BASE: Q7.1 (B), U8.15 (X2)
/TransistorsB/7_COLLECTOR: Q7.3 (C), U8.2 (Y2)
/TransistorsB/8_BASE: Q8.1 (B), U8.11 (X3)
/TransistorsB/8_COLLECTOR: Q8.3 (C), U8.4 (Y3)
/TransistorsB/9_BASE: Q9.1 (B), U10.12 (X0)
/TransistorsB/9_COLLECTOR: Q9.3 (C), U10.1 (Y0)
/TransistorsB/10_BASE: Q10.1 (B), U10.14 (X1)
/TransistorsB/10_COLLECTOR: Q10.3 (C), U10.5 (Y1)
/TransistorsB/11_BASE: Q11.1 (B), U10.15 (X2)
/TransistorsB/11_COLLECTOR: Q11.3 (C), U10.2 (Y2)
/TransistorsB/12_BASE: Q12.1 (B), U10.11 (X3)
/TransistorsB/12_COLLECTOR: Q12.3 (C), U10.4 (Y3)
/TransistorsB/13_BASE: Q13.1 (B), U11.12 (X0)
/TransistorsB/13_COLLECTOR: Q13.3 (C), U11.1 (Y0)
/TransistorsB/14_BASE: Q14.1 (B), U11.14 (X1)
/TransistorsB/14_COLLECTOR: Q14.3 (C), U11.5 (Y1)
/TransistorsB/15_BASE: Q15.1 (B), U11.15 (X2)
/TransistorsB/15_COLLECTOR: Q15.3 (C), U11.2 (Y2)
/TransistorsB/16_BASE: Q16.1 (B), U11.11 (X3)
/TransistorsB/16_COLLECTOR: Q16.3 (C), U11.4 (Y3)
/TransistorsB/17_BASE: Q17.1 (B), U12.12 (X0)
/TransistorsB/17_COLLECTOR: Q17.3 (C), U12.1 (Y0)
/TransistorsB/18_BASE: Q18.1 (B), U12.14 (X1)
/TransistorsB/18_COLLECTOR: Q18.3 (C), U12.5 (Y1)
/TransistorsB/19_BASE: Q19.1 (B), U12.15 (X2)
/TransistorsB/19_COLLECTOR: Q19.3 (C), U12.2 (Y2)
/TransistorsB/20_BASE: Q20.1 (B), U12.11 (X3)
/TransistorsB/20_COLLECTOR: Q20.3 (C), U12.4 (Y3)
/TransistorsB/BASE: U7.3 (X); also elsewhere on the board
/TransistorsB/TG_1_BASE: U6.13 (X), U7.13 (X0)
/TransistorsB/TG_1_COLLECTOR: U6.3 (Y), U9.13 (X0)
/TransistorsB/TG_2_BASE: U7.14 (X1), U8.13 (X)
/TransistorsB/TG_2_COLLECTOR: U8.3 (Y), U9.14 (X1)
/TransistorsB/TG_3_BASE: U7.15 (X2), U10.13 (X)
/TransistorsB/TG_3_COLLECTOR: U9.15 (X2), U10.3 (Y)
/TransistorsB/TG_4_BASE: U7.12 (X3), U11.13 (X)
/TransistorsB/TG_4_COLLECTOR: U9.12 (X3), U11.3 (Y)
/TransistorsB/TG_5_BASE: U7.1 (X4), U12.13 (X)
/TransistorsB/TG_5_COLLECTOR: U9.1 (X4), U12.3 (Y)
/TransistorsC/BASE: U9.3 (X); also elsewhere on the board
GND: C21.2, C22.2, C23.2, C24.2, C25.2, C26.2, C27.2, U6.6 (INH), U6.7 (VEE), U6.8 (VSS), U7.6 (INH), U7.7 (VEE), U7.8 (VSS), U8.6 (INH), U8.7 (VEE), U8.8 (VSS), U9.6 (INH), U9.7 (VEE), U9.8 (VSS), U10.6 (INH), U10.7 (VEE), U10.8 (VSS), U11.6 (INH), U11.7 (VEE), U11.8 (VSS), U12.6 (INH), U12.7 (VEE), U12.8 (VSS); also elsewhere on the board
GNDA: Q1.2 (E), Q2.2 (E), Q3.2 (E), Q4.2 (E), Q5.2 (E), Q6.2 (E), Q7.2 (E), Q8.2 (E), Q9.2 (E), Q10.2 (E), Q11.2 (E), Q12.2 (E), Q13.2 (E), Q14.2 (E), Q15.2 (E), Q16.2 (E), Q17.2 (E), Q18.2 (E), Q19.2 (E), Q20.2 (E); also elsewhere on the board

Parts of its further copies:
C28, C29, C30, C31, C32, C33, C34: 100nF; C_0805_2012Metric_Pad1.15x1.40mm_HandSolder
Q21: PN2222A; SOT-23_Handsoldering
Q22: MMBT3904; SOT-23_Handsoldering
Q23: MMBT5551L; SOT-23_Handsoldering
Q24: MMBTA42; SOT-23_Handsoldering
Q25: BC807; SOT-23_Handsoldering
Q26: BC846; SOT-23_Handsoldering
Q27: BC847B; SOT-23_Handsoldering
Q28: BC847C; SOT-23_Handsoldering
Q29: C945; SOT-23_Handsoldering
Q30: 2SC1815; SOT-23_Handsoldering
Q31: S8050; SOT-23_Handsoldering
Q32: S9013; SOT-23_Handsoldering
Q33: S9014; SOT-23_Handsoldering
Q34: S9018; SOT-23_Handsoldering
Q35: BC848B; SOT-23_Handsoldering
Q36: 2SC1623; SOT-23_Handsoldering
Q37, Q38: MPSA18; TO-92_Inline
Q39, Q40: 2N5088; TO-92_Inline
U13, U15, U17, U18, U19: CD4052B; SOIC-16_3.9x9.9mm_P1.27mm
U14, U16: CD4051B; SOIC-16_3.9x9.9mm_P1.27mm

Connections of its further copies:
+9V: C28.1, C29.1, C30.1, C31.1, C32.1, C33.1, C34.1, U14.16 (VDD), U15.16 (VDD), U16.16 (VDD), U17.16 (VDD), U18.16 (VDD), U19.16 (VDD); also elsewhere on the board
/CapacitorsD/CAPACITOR_AUDIO_INPUT: U16.3 (X); also elsewhere on the board
/TRANSISTOR_C_GROUP_SELECTION_0: U14.11 (A), U16.11 (A); also elsewhere on the board
/TRANSISTOR_C_GROUP_SELECTION_1: U14.10 (B), U16.10 (B); also elsewhere on the board
/TRANSISTOR_C_GROUP_SELECTION_2: U14.9 (C), U16.9 (C); also elsewhere on the board
/TRANSISTOR_C_SELECTION_0: U15.10 (A), U17.10 (A), U18.10 (A), U19.10 (A); also elsewhere on the board
/TRANSISTOR_C_SELECTION_1: U15.9 (B), U17.9 (B), U18.9 (B), U19.9 (B); also elsewhere on the board
/TransistorsC/1_BASE: Q21.1 (B); also elsewhere on the board
/TransistorsC/1_COLLECTOR: Q21.3 (C); also elsewhere on the board
/TransistorsC/2_BASE: Q22.1 (B); also elsewhere on the board
/TransistorsC/2_COLLECTOR: Q22.3 (C); also elsewhere on the board
/TransistorsC/3_BASE: Q23.1 (B); also elsewhere on the board
/TransistorsC/3_COLLECTOR: Q23.3 (C); also elsewhere on the board
/TransistorsC/4_BASE: Q24.1 (B); also elsewhere on the board
/TransistorsC/4_COLLECTOR: Q24.3 (C); also elsewhere on the board
/TransistorsC/5_BASE: Q25.1 (B), U15.12 (X0)
/TransistorsC/5_COLLECTOR: Q25.3 (C), U15.1 (Y0)
/TransistorsC/6_BASE: Q26.1 (B), U15.14 (X1)
/TransistorsC/6_COLLECTOR: Q26.3 (C), U15.5 (Y1)
/TransistorsC/7_BASE: Q27.1 (B), U15.15 (X2)
/TransistorsC/7_COLLECTOR: Q27.3 (C), U15.2 (Y2)
/TransistorsC/8_BASE: Q28.1 (B), U15.11 (X3)
/TransistorsC/8_COLLECTOR: Q28.3 (C), U15.4 (Y3)
/TransistorsC/9_BASE: Q29.1 (B), U17.12 (X0)
/TransistorsC/9_COLLECTOR: Q29.3 (C), U17.1 (Y0)
/TransistorsC/10_BASE: Q30.1 (B), U17.14 (X1)
/TransistorsC/10_COLLECTOR: Q30.3 (C), U17.5 (Y1)
/TransistorsC/11_BASE: Q31.1 (B), U17.15 (X2)
/TransistorsC/11_COLLECTOR: Q31.3 (C), U17.2 (Y2)
/TransistorsC/12_BASE: Q32.1 (B), U17.11 (X3)
/TransistorsC/12_COLLECTOR: Q32.3 (C), U17.4 (Y3)
/TransistorsC/13_BASE: Q33.1 (B), U18.12 (X0)
/TransistorsC/13_COLLECTOR: Q33.3 (C), U18.1 (Y0)
/TransistorsC/14_BASE: Q34.1 (B), U18.14 (X1)
/TransistorsC/14_COLLECTOR: Q34.3 (C), U18.5 (Y1)
/TransistorsC/15_BASE: Q35.1 (B), U18.15 (X2)
/TransistorsC/15_COLLECTOR: Q35.3 (C), U18.2 (Y2)
/TransistorsC/16_BASE: Q36.1 (B), U18.11 (X3)
/TransistorsC/16_COLLECTOR: Q36.3 (C), U18.4 (Y3)
/TransistorsC/17_BASE: Q37.1 (B), U19.12 (X0)
/TransistorsC/17_COLLECTOR: Q37.3 (C), U19.1 (Y0)
/TransistorsC/18_BASE: Q38.1 (B), U19.14 (X1)
/TransistorsC/18_COLLECTOR: Q38.3 (C), U19.5 (Y1)
/TransistorsC/19_BASE: Q39.1 (B), U19.15 (X2)
/TransistorsC/19_COLLECTOR: Q39.3 (C), U19.2 (Y2)
/TransistorsC/20_BASE: Q40.1 (B), U19.11 (X3)
/TransistorsC/20_COLLECTOR: Q40.3 (C), U19.4 (Y3)
/TransistorsC/BASE: U14.3 (X); also elsewhere on the board
/TransistorsC/EMITTER: Q21.2 (E), Q22.2 (E), Q23.2 (E), Q24.2 (E), Q25.2 (E), Q26.2 (E), Q27.2 (E), Q28.2 (E), Q29.2 (E), Q30.2 (E), Q31.2 (E), Q32.2 (E), Q33.2 (E), Q34.2 (E), Q35.2 (E), Q36.2 (E), Q37.2 (E), Q38.2 (E), Q39.2 (E), Q40.2 (E); also elsewhere on the board
/TransistorsC/TG_1_BASE: U14.13 (X0); also elsewhere on the board
/TransistorsC/TG_1_COLLECTOR: U16.13 (X0); also elsewhere on the board
/TransistorsC/TG_2_BASE: U14.14 (X1), U15.13 (X)
/TransistorsC/TG_2_COLLECTOR: U15.3 (Y), U16.14 (X1)
/TransistorsC/TG_3_BASE: U14.15 (X2), U17.13 (X)
/TransistorsC/TG_3_COLLECTOR: U16.15 (X2), U17.3 (Y)
/TransistorsC/TG_4_BASE: U14.12 (X3), U18.13 (X)
/TransistorsC/TG_4_COLLECTOR: U16.12 (X3), U18.3 (Y)
/TransistorsC/TG_5_BASE: U14.1 (X4), U19.13 (X)
/TransistorsC/TG_5_COLLECTOR: U16.1 (X4), U19.3 (Y)
GND: C28.2, C29.2, C30.2, C31.2, C32.2, C33.2, C34.2, U14.6 (INH), U14.7 (VEE), U14.8 (VSS), U15.6 (INH), U15.7 (VEE), U15.8 (VSS), U16.6 (INH), U16.7 (VEE), U16.8 (VSS), U17.6 (INH), U17.7 (VEE), U17.8 (VSS), U18.6 (INH), U18.7 (VEE), U18.8 (VSS), U19.6 (INH), U19.7 (VEE), U19.8 (VSS); also elsewhere on the board

Notes on the sheet:
Transistor Group 4 (Transistor 13..16)
Transistor Group 5 (Transistor 17..20)
Transistor Group 2 (Transistor 5..8)
Transistor Group 1 (Transistor 1..4)
Transistor Groups TG1..TG5 Collector
Transistor Group 3 (Transistor 9..12)
Transistor Groups TG1..TG5 Gate

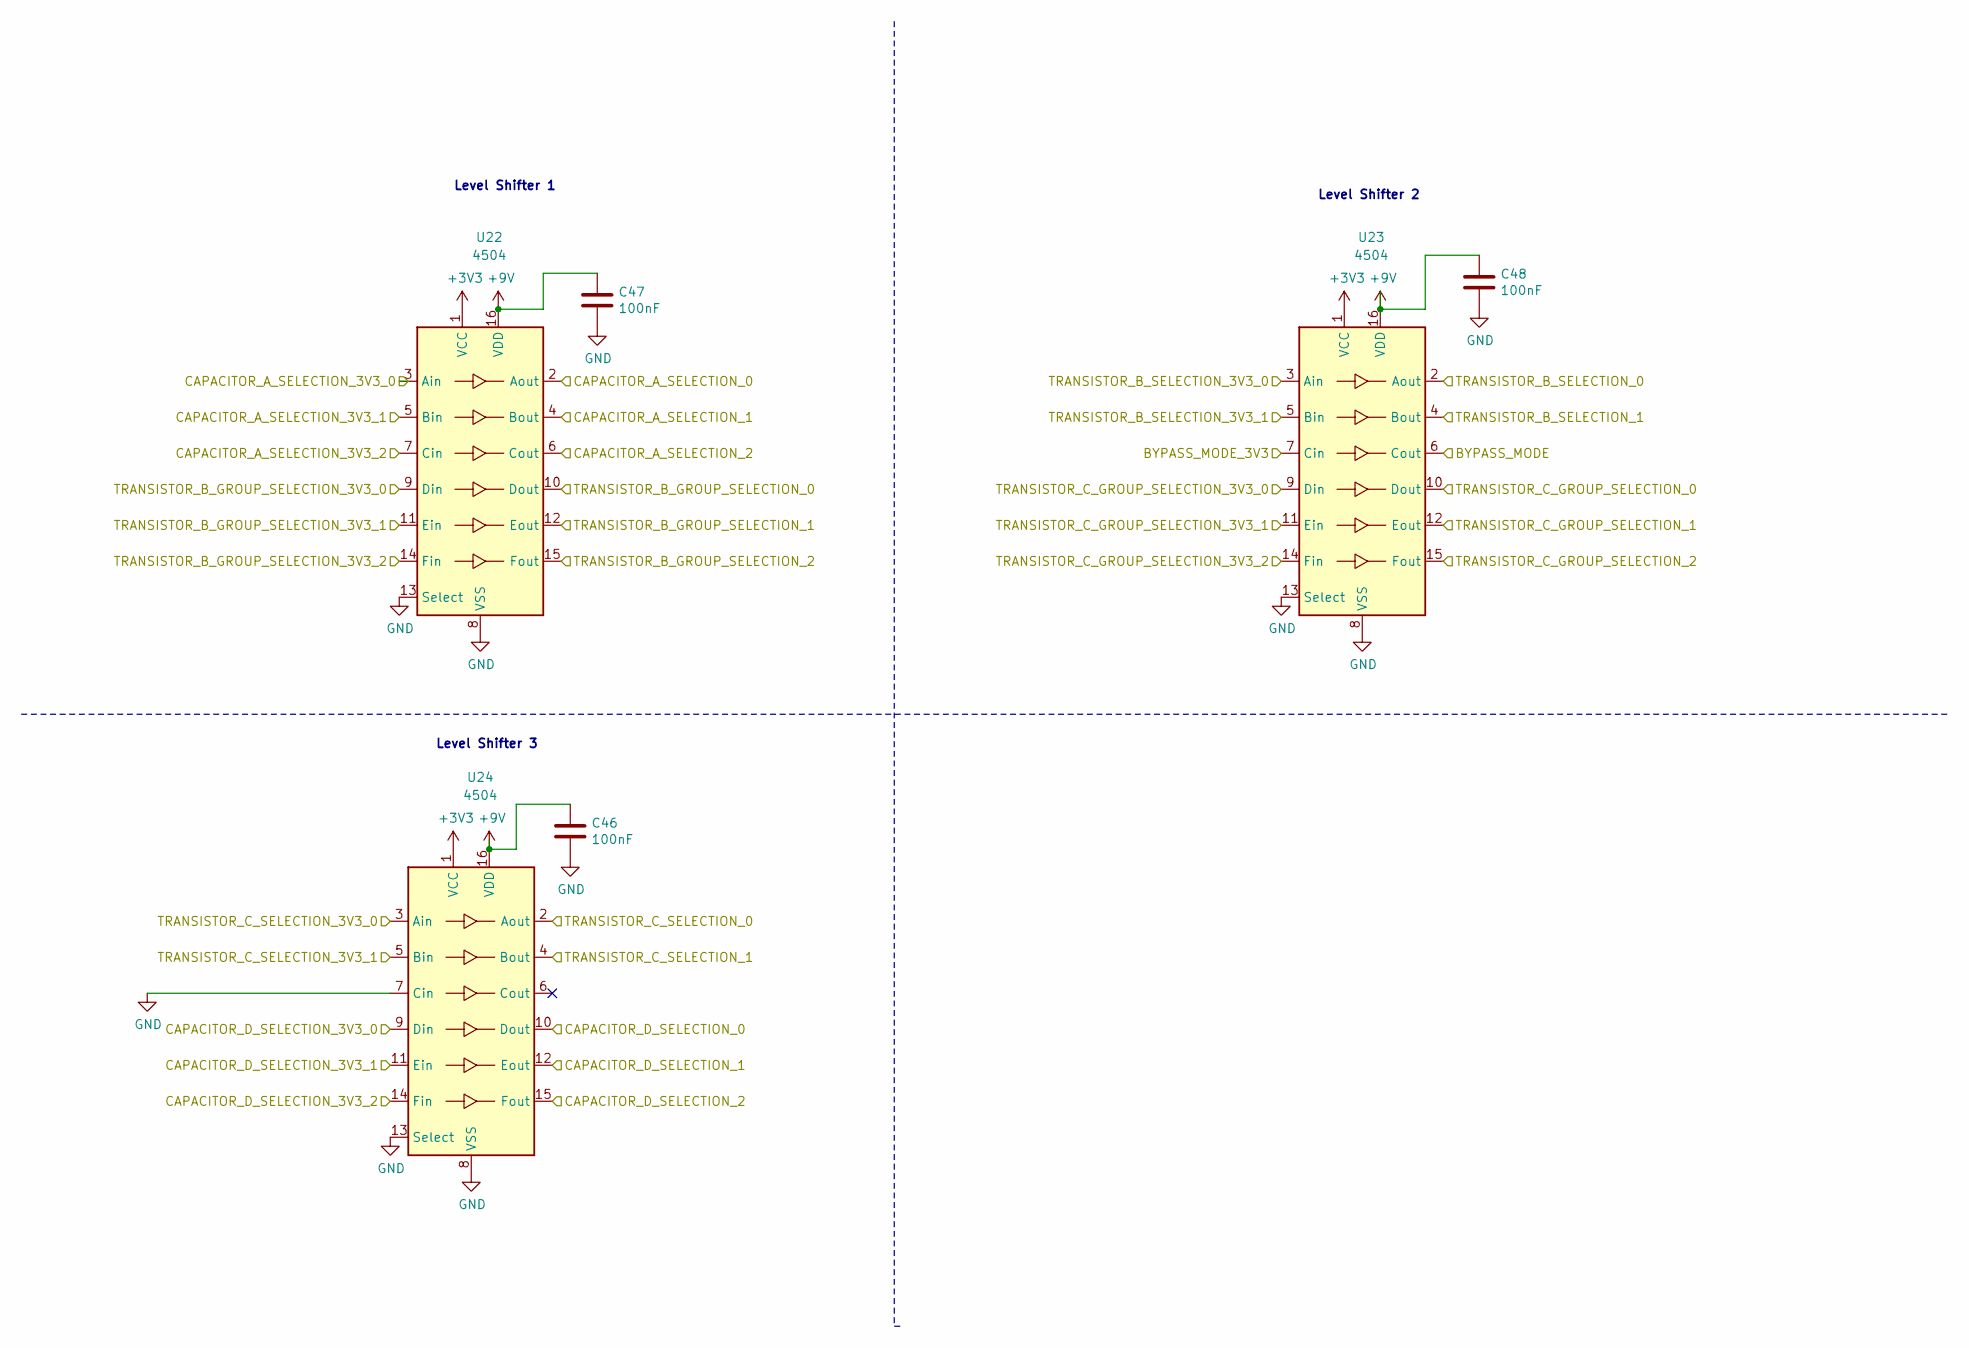
[picture p75: schematic LevelShifter.sch]

Parts:
C46, C47, C48: 100nF; C_0805_2012Metric_Pad1.15x1.40mm_HandSolder
U22, U23, U24: 4504; SOIC-16_3.9x9.9mm_P1.27mm

Connections:
+3V3: U22.1 (VCC), U23.1 (VCC), U24.1 (VCC); also elsewhere on the board
+9V: C46.1, C47.1, C48.1, U22.16 (VDD), U23.16 (VDD), U24.16 (VDD); also elsewhere on the board
/BYPASS_MODE: U23.6 (Cout); also elsewhere on the board
/BYPASS_MODE_3V3: U23.7 (Cin); also elsewhere on the board
/CAPACITOR_A_SELECTION_0: U22.2 (Aout); also elsewhere on the board
/CAPACITOR_A_SELECTION_1: U22.4 (Bout); also elsewhere on the board
/CAPACITOR_A_SELECTION_2: U22.6 (Cout); also elsewhere on the board
/CAPACITOR_A_SELECTION_3V3_0: U22.3 (Ain); also elsewhere on the board
/CAPACITOR_A_SELECTION_3V3_1: U22.5 (Bin); also elsewhere on the board
/CAPACITOR_A_SELECTION_3V3_2: U22.7 (Cin); also elsewhere on the board
/CAPACITOR_D_SELECTION_0: U24.10 (Dout); also elsewhere on the board
/CAPACITOR_D_SELECTION_1: U24.12 (Eout); also elsewhere on the board
/CAPACITOR_D_SELECTION_2: U24.15 (Fout); also elsewhere on the board
/CAPACITOR_D_SELECTION_3V3_0: U24.9 (Din); also elsewhere on the board
/CAPACITOR_D_SELECTION_3V3_1: U24.11 (Ein); also elsewhere on the board
/CAPACITOR_D_SELECTION_3V3_2: U24.14 (Fin); also elsewhere on the board
/TRANSISTOR_B_GROUP_SELECTION_0: U22.10 (Dout); also elsewhere on the board
/TRANSISTOR_B_GROUP_SELECTION_1: U22.12 (Eout); also elsewhere on the board
/TRANSISTOR_B_GROUP_SELECTION_2: U22.15 (Fout); also elsewhere on the board
/TRANSISTOR_B_GROUP_SELECTION_3V3_0: U22.9 (Din); also elsewhere on the board
/TRANSISTOR_B_GROUP_SELECTION_3V3_1: U22.11 (Ein); also elsewhere on the board
/TRANSISTOR_B_GROUP_SELECTION_3V3_2: U22.14 (Fin); also elsewhere on the board
/TRANSISTOR_B_SELECTION_0: U23.2 (Aout); also elsewhere on the board
/TRANSISTOR_B_SELECTION_1: U23.4 (Bout); also elsewhere on the board
/TRANSISTOR_B_SELECTION_3V3_0: U23.3 (Ain); also elsewhere on the board
/TRANSISTOR_B_SELECTION_3V3_1: U23.5 (Bin); also elsewhere on the board
/TRANSISTOR_C_GROUP_SELECTION_0: U23.10 (Dout); also elsewhere on the board
/TRANSISTOR_C_GROUP_SELECTION_1: U23.12 (Eout); also elsewhere on the board
/TRANSISTOR_C_GROUP_SELECTION_2: U23.15 (Fout); also elsewhere on the board
/TRANSISTOR_C_GROUP_SELECTION_3V3_0: U23.9 (Din); also elsewhere on the board
/TRANSISTOR_C_GROUP_SELECTION_3V3_1: U23.11 (Ein); also elsewhere on the board
/TRANSISTOR_C_GROUP_SELECTION_3V3_2: U23.14 (Fin); also elsewhere on the board
/TRANSISTOR_C_SELECTION_0: U24.2 (Aout); also elsewhere on the board
/TRANSISTOR_C_SELECTION_1: U24.4 (Bout); also elsewhere on the board
/TRANSISTOR_C_SELECTION_3V3_0: U24.3 (Ain); also elsewhere on the board
/TRANSISTOR_C_SELECTION_3V3_1: U24.5 (Bin); also elsewhere on the board
GND: C46.2, C47.2, C48.2, U22.8 (VSS), U22.13 (Select), U23.8 (VSS), U23.13 (Select), U24.7 (Cin), U24.8 (VSS), U24.13 (Select); also elsewhere on the board

Notes on the sheet:
Level Shifter 1
Level Shifter 2
Level Shifter 3

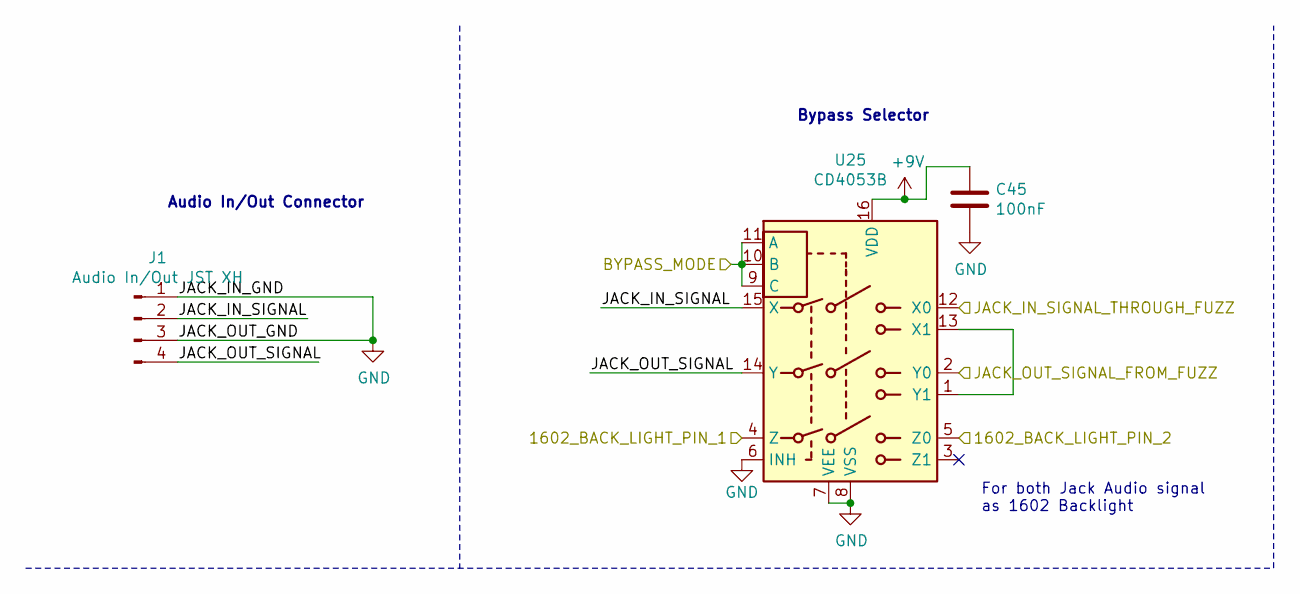
[picture p76: schematic AudioInOut.sch]

Parts:
C45: 100nF; C_0805_2012Metric_Pad1.15x1.40mm_HandSolder
J1: Audio In/Out JST XH; JST_XH_B4B-XH-A_1x04_P2.50mm_Vertical
U25: CD4053B; SOIC-16_3.9x9.9mm_P1.27mm

Connections:
+9V: C45.1, U25.16 (VDD); also elsewhere on the board
/1602_BACK_LIGHT_PIN_1: U25.4 (Z); also elsewhere on the board
/1602_BACK_LIGHT_PIN_2: U25.5 (Z0); also elsewhere on the board
/AudioInOut/JACK_IN_SIGNAL: J1.2, U25.15 (X)
/AudioInOut/JACK_OUT_SIGNAL: J1.4, U25.14 (Y)
/BYPASS_MODE: U25.9 (C), U25.10 (B), U25.11 (A); also elsewhere on the board
/JACK_IN_SIGNAL_THROUGH_FUZZ: U25.12 (X0); also elsewhere on the board
/JACK_OUT_SIGNAL_FROM_FUZZ: U25.2 (Y0); also elsewhere on the board
GND: C45.2, J1.1, J1.3, U25.6 (INH), U25.7 (VEE), U25.8 (VSS); also elsewhere on the board
unnamed: U25.1 (Y1), U25.13 (X1)

Notes on the sheet:
Bypass Selector
Audio In/Out Connector
For both Jack Audio signal as 1602 Backlight

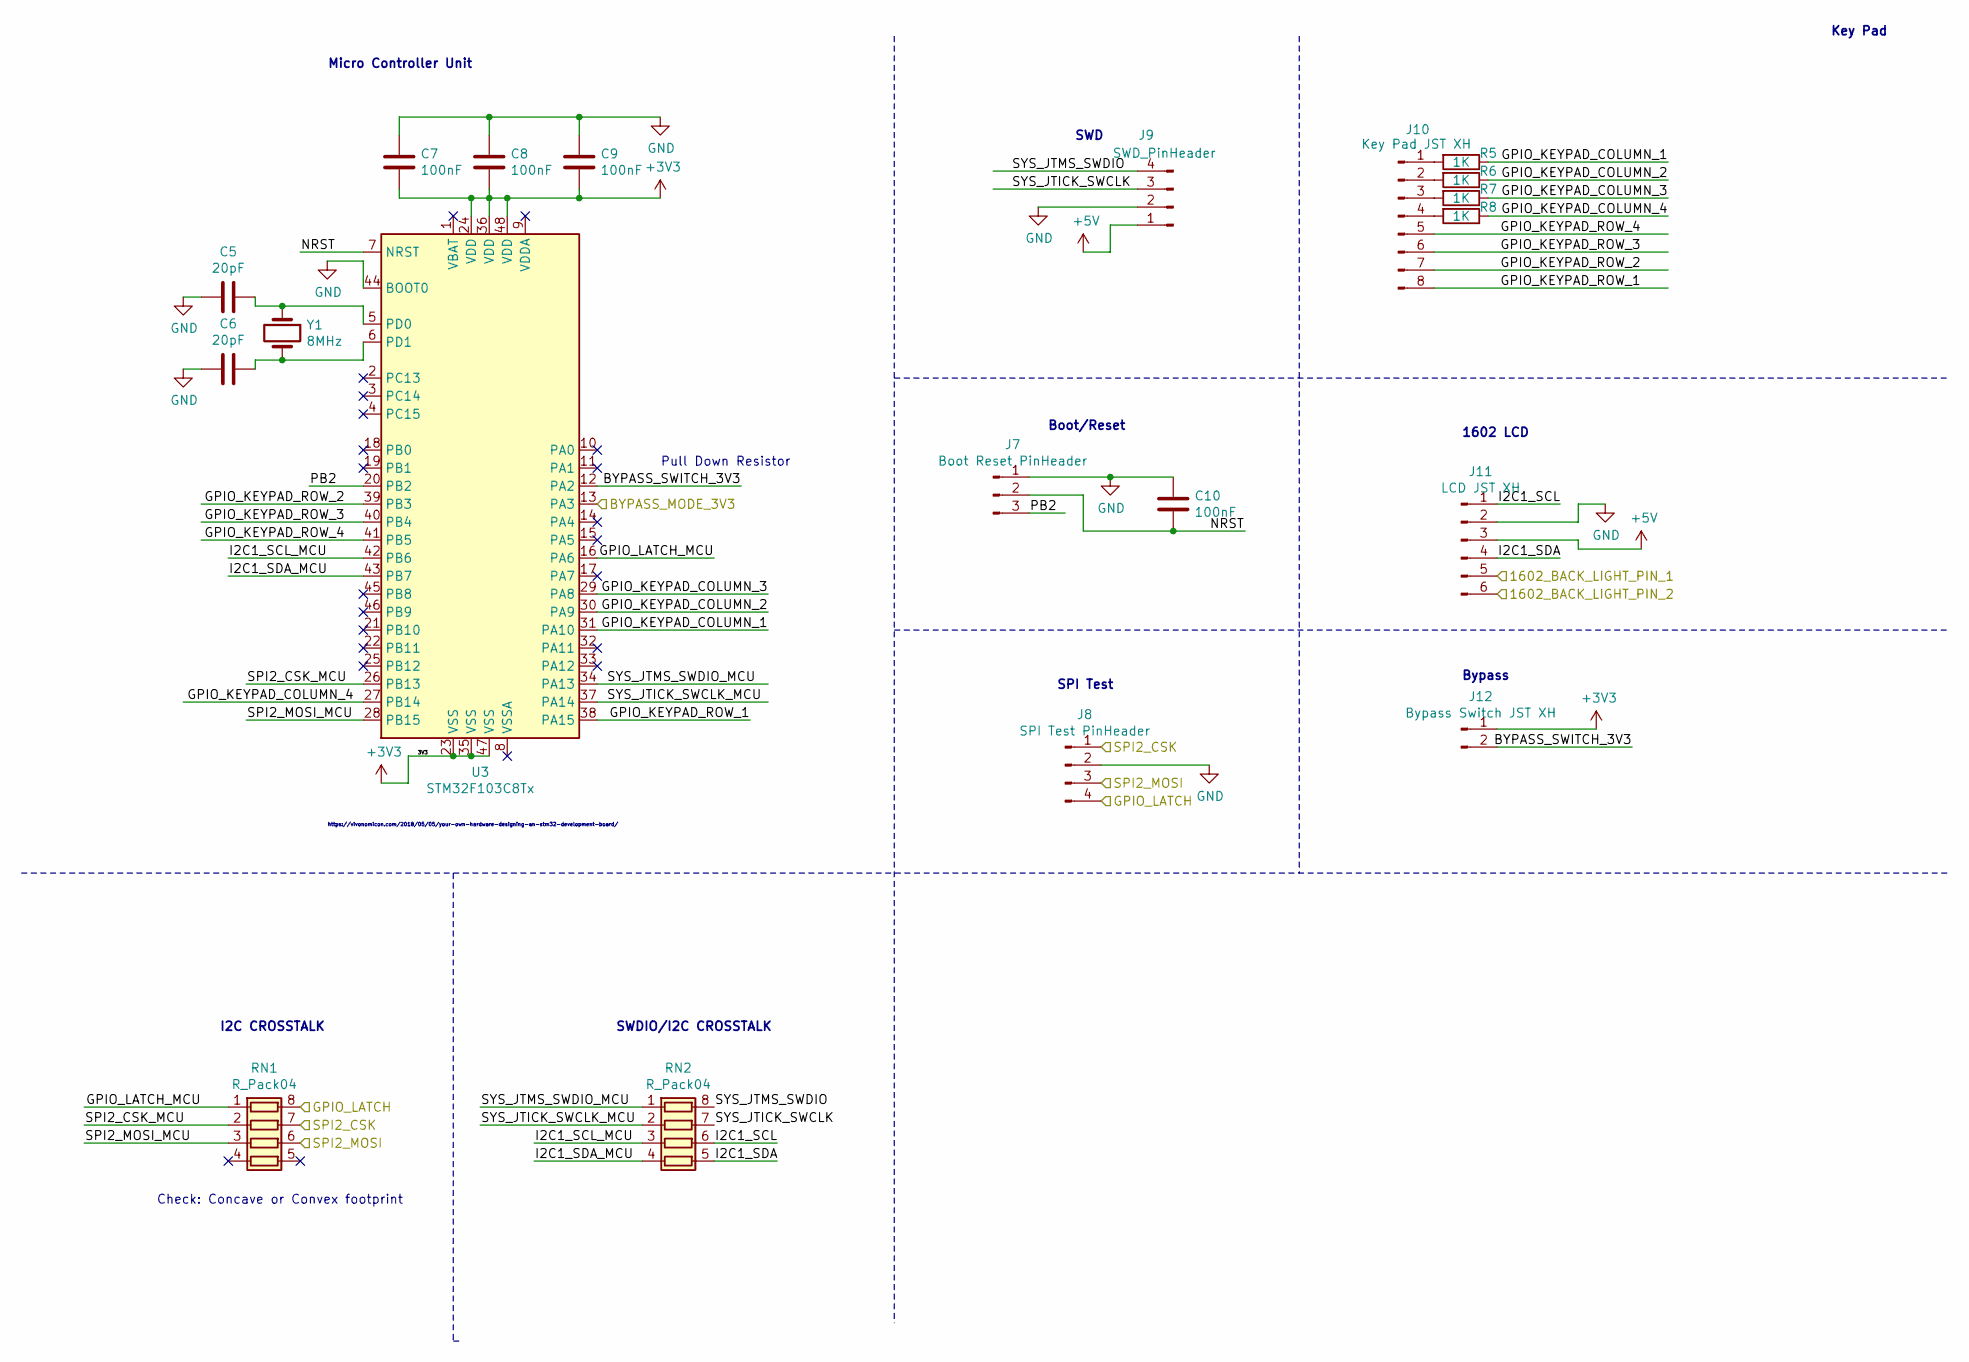
[picture p77: schematic Mcu.sch, Guitar Pedal Effect Fuzz Digitally Controlled]

Parts:
C5, C6: 20pF; C_0805_2012Metric_Pad1.15x1.40mm_HandSolder
C7, C8, C9, C10: 100nF; C_0805_2012Metric_Pad1.15x1.40mm_HandSolder
J7: Boot Reset PinHeader; PinHeader_1x03_P2.54mm_Vertical
J8: SPI Test PinHeader; PinHeader_1x04_P2.54mm_Vertical
J9: SWD_PinHeader; PinHeader_1x04_P2.54mm_Vertical
J10: Key Pad JST XH; JST_XH_B8B-XH-A_1x08_P2.50mm_Vertical
J11: LCD JST XH; JST_XH_B6B-XH-A_1x06_P2.50mm_Vertical
J12: Bypass Switch JST XH; JST_XH_B2B-XH-A_1x02_P2.50mm_Vertical
R5, R6, R7, R8: 1K; R_0805_2012Metric_Pad1.15x1.40mm_HandSolder
RN1, RN2: R_Pack04; R_Array_Convex_4x0603
U3: STM32F103C8Tx; LQFP-48_7x7mm_P0.5mm
Y1: 8MHz; Crystal_HC49-U_Vertical

Connections:
+3V3: C7.2, C8.2, C9.2, J12.1, U3.23 (VSS), U3.24 (VDD), U3.35 (VSS), U3.36 (VDD), U3.47 (VSS), U3.48 (VDD); also elsewhere on the board
+5V: J9.1, J11.3; also elsewhere on the board
/1602_BACK_LIGHT_PIN_1: J11.5; also elsewhere on the board
/1602_BACK_LIGHT_PIN_2: J11.6; also elsewhere on the board
/BYPASS_MODE_3V3: U3.13 (PA3); also elsewhere on the board
/GPIO_LATCH: J8.4, RN1.8 (R1.2); also elsewhere on the board
/Mcu/BYPASS_SWITCH_3V3: J12.2, U3.12 (PA2)
/Mcu/GPIO_KEYPAD_COLUMN_1: R5.1, U3.31 (PA10)
/Mcu/GPIO_KEYPAD_COLUMN_2: R6.1, U3.30 (PA9)
/Mcu/GPIO_KEYPAD_COLUMN_3: R7.1, U3.29 (PA8)
/Mcu/GPIO_KEYPAD_COLUMN_4: R8.1, U3.27 (PB14)
/Mcu/GPIO_KEYPAD_ROW_1: J10.8, U3.38 (PA15)
/Mcu/GPIO_KEYPAD_ROW_2: J10.7, U3.39 (PB3)
/Mcu/GPIO_KEYPAD_ROW_3: J10.6, U3.40 (PB4)
/Mcu/GPIO_KEYPAD_ROW_4: J10.5, U3.41 (PB5)
/Mcu/GPIO_LATCH_MCU: RN1.1 (R1.1), U3.16 (PA6)
/Mcu/I2C1_SCL: J11.1, RN2.6 (R3.2)
/Mcu/I2C1_SCL_MCU: RN2.3 (R3.1), U3.42 (PB6)
/Mcu/I2C1_SDA: J11.4, RN2.5 (R4.2)
/Mcu/I2C1_SDA_MCU: RN2.4 (R4.1), U3.43 (PB7)
/Mcu/NRST: C10.1, J7.2, U3.7 (NRST)
/Mcu/PB2: J7.3, U3.20 (PB2)
/Mcu/SPI2_CSK_MCU: RN1.2 (R2.1), U3.26 (PB13)
/Mcu/SPI2_MOSI_MCU: RN1.3 (R3.1), U3.28 (PB15)
/Mcu/SYS_JTICK_SWCLK: J9.3, RN2.7 (R2.2)
/Mcu/SYS_JTICK_SWCLK_MCU: RN2.2 (R2.1), U3.37 (PA14)
/Mcu/SYS_JTMS_SWDIO: J9.4, RN2.8 (R1.2)
/Mcu/SYS_JTMS_SWDIO_MCU: RN2.1 (R1.1), U3.34 (PA13)
/SPI2_CSK: J8.1, RN1.7 (R2.2); also elsewhere on the board
/SPI2_MOSI: J8.3, RN1.6 (R3.2); also elsewhere on the board
GND: C5.2, C6.2, C7.1, C8.1, C9.1, C10.2, J7.1, J8.2, J9.2, J11.2, U3.44 (BOOT0); also elsewhere on the board
unnamed: C5.1, U3.5 (PD0), Y1.1
unnamed: C6.1, U3.6 (PD1), Y1.2
unnamed: J10.1, R5.2
unnamed: J10.2, R6.2
unnamed: J10.3, R7.2
unnamed: J10.4, R8.2

Notes on the sheet:
Micro Controller Unit
https://vivonomicon.com/2018/05/05/your-own-hardware-designing-an-stm32-development-board/
Boot/Reset
SPI Test
SWD
Key Pad
1602 LCD
Bypass
Pull Down Resistor
I2C CROSSTALK
SWDIO/I2C CROSSTALK
Check: Concave or Convex footprint

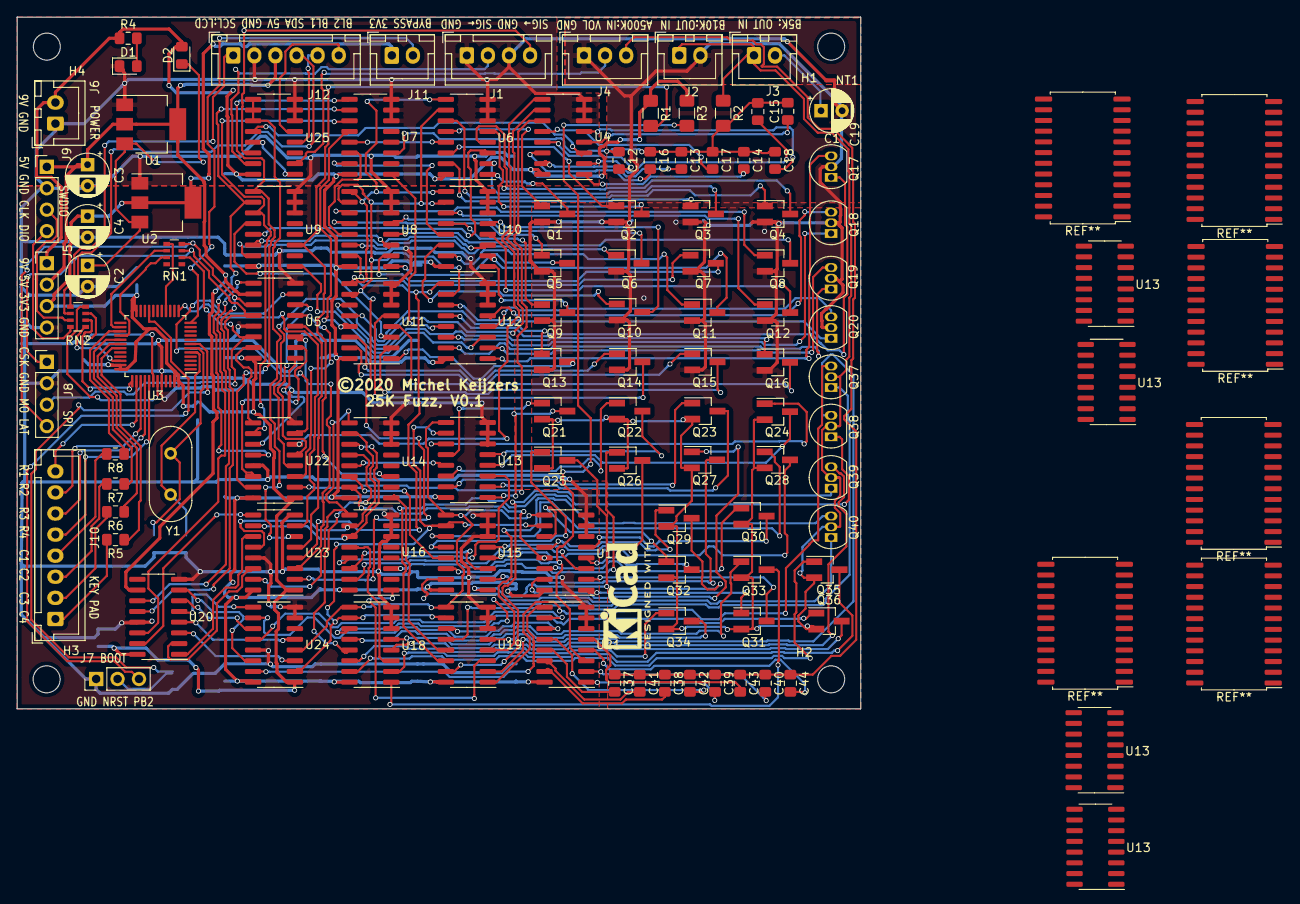
[picture p78: board Kicad/EightBitMuxes/Fuzz.kicad_pcb from above]

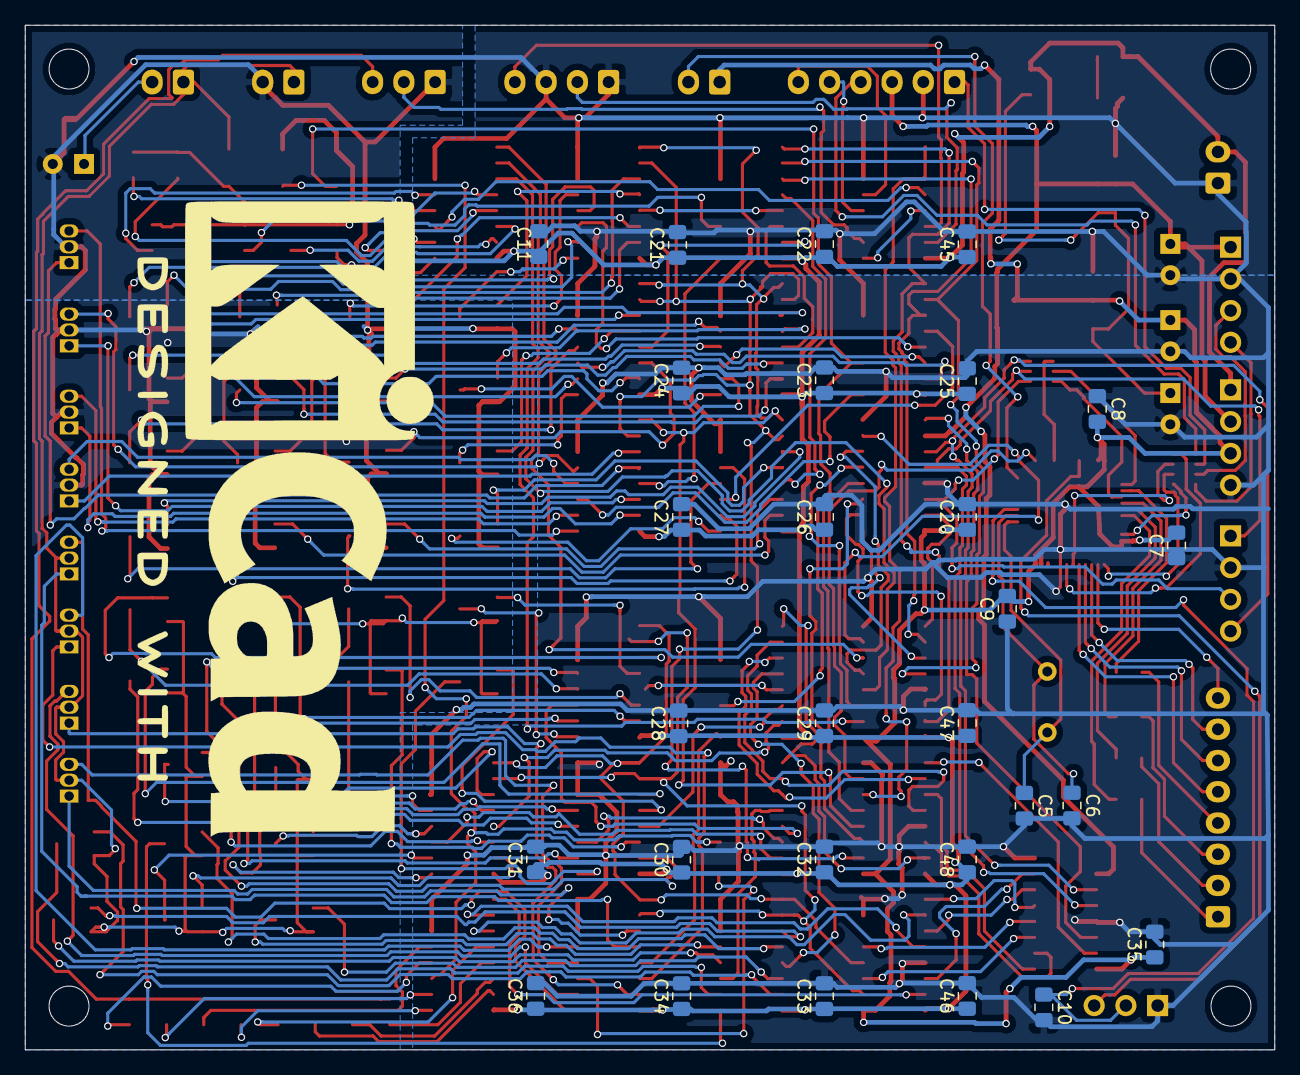
[picture p79: board Kicad/EightBitMuxes/Fuzz.kicad_pcb from below]

Board: 2 copper layers, 100.0 x 82.0 mm, 147 parts (28 on the bottom side), 202 nets.

Other parts of the board:
U13#2, U13#3, U13#4, U13#5: CD4052B; SOIC-16_3.9x9.9mm_P1.27mm

Their connections:
+9V: U13#5.16; also elsewhere on the board
/TRANSISTOR_C_SELECTION_0: U13#5.10; also elsewhere on the board
/TRANSISTOR_C_SELECTION_1: U13#5.9; also elsewhere on the board
/TransistorsC/1_BASE: U13#5.12; also elsewhere on the board
/TransistorsC/1_COLLECTOR: U13#5.1; also elsewhere on the board
/TransistorsC/2_BASE: U13#5.14; also elsewhere on the board
/TransistorsC/2_COLLECTOR: U13#5.5; also elsewhere on the board
/TransistorsC/3_BASE: U13#5.15; also elsewhere on the board
/TransistorsC/3_COLLECTOR: U13#5.2; also elsewhere on the board
/TransistorsC/4_BASE: U13#5.11; also elsewhere on the board
/TransistorsC/4_COLLECTOR: U13#5.4; also elsewhere on the board
/TransistorsC/TG_1_BASE: U13#5.13; also elsewhere on the board
/TransistorsC/TG_1_COLLECTOR: U13#5.3; also elsewhere on the board
GND: U13#5.6, U13#5.7, U13#5.8; also elsewhere on the board
