michelkeijzers/FuzzTester2/FuzzTester2/Core/Inc/MyMain.h

/*
 * MyMain.h
 *
 *  Created on: Feb 8, 2020
 *      Author: Michel Keijzers
 */

#ifndef INC_MYMAIN_H_
#define INC_MYMAIN_H_

extern "C"
{
   void MyInit();
   int  MyMain();
}

#endif /* INC_MYMAIN_H_ */
