michelkeijzers/FuzzTester2/FuzzTester2/Core/Src/Framework/LcdDisplay.cpp

/*
 * LcdDisplay.cpp
 *
 *  Created on: Jan 30, 2020
 *      Author: Michel Keijzers
 */

#include <Framework/LcdDisplay.h>

#include "stm32f1xx_hal.h"

#ifdef DEBUG
#include "assert.h"
#endif

#include <Framework/SysTickSubscribers.h>
#include "Framework/HalUtils.h"


// #define LCD_ADDR (0x27 << 1)

#define PIN_RS    (1 << 0)
#define PIN_EN    (1 << 2)
#define BACKLIGHT (1 << 3)

#define LCD_DELAY_MS 5



LcdDisplay::LcdDisplay(I2C_HandleTypeDef* hI2c, uint8_t i2cChannel,
      UPDATE_LCD_FUNCTION_PTR callbackFunction, uint16_t refreshTime, uint8_t sysTickSubscriberIndex)
: _hI2c(hI2c),
  _i2cChannel(i2cChannel << 1),
  _isInitialized(false),
  _backLight(0),
  _displayControl(0x04),
  _cursorType(ECursorType::None),
  _cursorPosX(0),
  _cursorPosY(0),
  _callbackFunction(callbackFunction)
{
   SysTickSubscribers::SetSubscriber(sysTickSubscriberIndex, this);
   SysTickSubscribers::SetInterval(sysTickSubscriberIndex, refreshTime);
}


LcdDisplay::~LcdDisplay()
{
}


uint8_t LcdDisplay::GetMaxLineLength() const
{
   return 16;
}


uint8_t LcdDisplay::GetMaxLines() const
{
   return 2;
}


void LcdDisplay::SetLine(uint8_t line, const char* text) const
{
	// set address to 0x40 for second line;
   SendCommand(0b10000000 + 0x40 * line);
   SendString(text);
}


void LcdDisplay::SetBackLight(bool backLight)
{
   _backLight = backLight ? 1 : 0;
   Init();
}


void LcdDisplay::I2C_Scan() const
{
    //char info[] = "Scanning I2C bus...\r\n";
    //HAL_UART_Transmit(&huart2, (uint8_t*)info, strlen(info), HAL_MAX_DELAY);

    HAL_StatusTypeDef res;
    for (uint8_t i = 0; i < 128; i++) {
        res = HAL_I2C_IsDeviceReady(_hI2c, i << 1, 1, 10);
        if(res == HAL_OK)
        {
        	while(true) {}; // Set a breakpoint here to check the channel
        }
    }

    //HAL_UART_Transmit(&huart2, (uint8_t*)"\r\n", 2, HAL_MAX_DELAY);
}


bool LcdDisplay::IsInitialized() const
{
   return _isInitialized;
}


void LcdDisplay::Init()
{
    _isInitialized = false;

    // Wait 15..40 ms after LCD power applied
     HalUtils::Delay(50);

    // Try several times - one try may go just for initializing the
    // IO Expander to get LCD bus to known state.
    for (uint8_t i = 0; i < 5; i++)
    {
        // Try going to 8-bit mode using two nibbles of 0x03
        SendCommand(0b00110011);
        // Wait more than 4.1 ms
        HalUtils::Delay(6);
    }

    // Try going to 4-bit mode using nibbles 0x03 and 0x02
    // First nibble 0x03 is 8-bit command to go to 8-bit mode
    // Second nibble 0x02 is 8-bit command to go to 4-bit mode
    SendCommand(0b00110010);
    // Should be in 4-bit mode now, but without correct line/font info
    // So, resend Function Set command in 4-bit mode as two nibbles

    // 4-bit mode, 2 lines, 5x7 format
    SendCommand(0b00101000);
    // Entry Mode Set (increase cursor, no display shift)
    SendCommand(0b00000110);
    // display & cursor home (keep this!)
    SendCommand(0b00000010);
    // Cursor Home needs more than 1.5 ms to execute
    HalUtils::Delay(3);
    // display on, cursor off, blink off
    SendCommand(0b00001100);
    // clear display (optional here)
    SendCommand(0b00000001);
    // Clear Display needs more than 1.5 ms to execute
    HalUtils::Delay(3);

    _isInitialized = true;
}


void LcdDisplay::BlankDisplay() const
{
   SendCommand(8);
}


void LcdDisplay::ClearScreen() const
{
   SendCommand(1);
}


void LcdDisplay::ScrollOneCharLeft() const
{
   SendCommand(24);
}


void LcdDisplay::ScrollOneCharRight() const
{
   SendCommand(28);
}


void LcdDisplay::SetCursorType(ECursorType cursorType)
{
    switch (cursorType)
    {
    case None:
       SendCommand(12);
       break;

    case Underline:
       SendCommand(14);
       break;

    case Block:
       SendCommand(15);
       break;

#ifdef DEBUG
    default:
       assert(false);
#endif
    }

    _cursorType = cursorType;
}


void LcdDisplay::SetCursorPosition(uint8_t x, uint8_t y)
{
#ifdef DEBUG
   assert(x < GetMaxLineLength());
   assert(y < GetMaxLines());
#endif

   SendCommand(128 + GetMaxLineLength() * y + x);
}


void LcdDisplay::CursorHome() const
{
   SendCommand(2);
}


void LcdDisplay::CursorLeft() const
{
   SendCommand(16);
}


void LcdDisplay::CursorRight() const
{
   SendCommand(20);
}


HAL_StatusTypeDef LcdDisplay::SendInternal(uint8_t data, uint8_t flags) const
{
    HAL_StatusTypeDef res;
    while(true)
    {
        res = HAL_I2C_IsDeviceReady(_hI2c, _i2cChannel, 1, HAL_MAX_DELAY);
        if(res == HAL_OK)
            break;
    }

    uint8_t up = data & 0xF0;
    uint8_t lo = (data << 4) & 0xF0;

    uint8_t data_arr[4];
    uint8_t backLightValue = _backLight ? BACKLIGHT : 0;
    data_arr[0] = up|flags|backLightValue|PIN_EN;
    data_arr[1] = up|flags|backLightValue;
    data_arr[2] = lo|flags|backLightValue|PIN_EN;
    data_arr[3] = lo|flags|backLightValue;

    //res = HAL_I2C_Master_Transmit_IT(_hI2c, _i2cChannel, data_arr, sizeof(data_arr));
    res = HAL_I2C_Master_Transmit(_hI2c, _i2cChannel, data_arr, sizeof(data_arr), HAL_MAX_DELAY);
    //HalUtils::Delay(LCD_DELAY_MS);
    return res;
}


void LcdDisplay::SendCommand(uint8_t cmd) const
{
    SendInternal(cmd, 0);
}


void LcdDisplay::SendData(uint8_t data) const
{
    SendInternal(data, PIN_RS);
}


void LcdDisplay::SendString(const char *str) const
{
    while(*str)
    {
        SendData((uint8_t)(*str));
        str++;
    }
}


void LcdDisplay::OnTick()
{

   (*_callbackFunction)();
}
