michelkeijzers/FuzzTester2/FuzzTester2/Core/Inc/Preset.h

/*
 * Preset.h
 *
 *  Created on: Apr 26, 2020
 *      Author: Michel Keijzers
 */

#ifndef INC_PRESET_H_
#define INC_PRESET_H_

#include <stdint.h>

#include "Components.h"

class Preset
{
public:
   Preset();
   virtual ~Preset();

   bool DecreaseParameterIndex(uint8_t* parameter);
   bool DecreaseIndex(Components::EType type);
   bool IncreaseParameterIndex(uint8_t* parameter, uint8_t nrOfItems);
   bool IncreaseIndex(Components::EType type);

   uint8_t GetIndex  (Components::EType type) const;
   void SetIndex(Components::EType type, uint8_t index);

   bool CheckDirty();

   void LimitBoundaries();

private:
   uint8_t _capacitorA;
   uint8_t _transistorB;
   uint8_t _transistorC;
   uint8_t _capacitorD;

   bool _isDirty;
};

#endif /* INC_PRESET_H_ */
