michelkeijzers/FuzzTester2/FuzzTester/Core/Src/Framework/Button_INT.cpp

/*
 * Button_INT.cpp
 *
 *  Created on: Feb 1, 2020
 *      Author: michel
 */

#include <Framework/Button_INT.h>
#include <Framework/ISysTickSubscriber.h>
#include <Framework/SysTickSubscribers.h>


Button_INT::Button_INT(Gpio gpio, BUTTON_CALLBACK_FUNCTION_PTR callbackFunction,
   uint8_t sysTickSubscriberIndex, uint8_t debounceTime)
:  BaseButton(gpio, debounceTime, sysTickSubscriberIndex),
  _callbackFunction(callbackFunction)
{
}


Button_INT::~Button_INT()
{
}


/* override */ void Button_INT::OnButtonPressed()
{
   (*_callbackFunction)();
}
