michelkeijzers/FuzzTester2/(commit log)

2020-02-09 Fixed HAL_Delay, used LCD
    [MyMain.cpp, Switch_INT.cpp, SysTickSubscribers.cpp]
2020-02-09 Base class for switches
2020-02-09 Renamed Switch to Button
2020-02-09 Moved functionality to Button base class
2020-02-09 Added momentary button
2020-02-09 Renamed Button to DefaultButton
2020-02-09 Predelay for hold, button
2020-02-09 Fixed bug when button while button debouncing.
    [BaseButton.cpp, MyMain.cpp]
2020-02-10 LCD Int is not working; removed from normal LCD delay, and refresh time by SysTick.
    [BaseButton.cpp, CounterButton_INT.cpp, DefaultButton_INT.cpp, LcdDisplay.cpp]
2020-02-16 states for buttons, long press works too.
2020-02-22 Keypad only working for polling, used strong resistors (1K) instead of internal 50K pullup resistors. Used single state transition diagram.
2020-02-25 Used HAL for keypad again (problems with own GPIO library).
    [KeyPad.cpp, MyMain.cpp]
2020-03-04 Fixed shift register values for leds.
    [MyMain.cpp]
2020-04-06 Added KiCad
    [Capacitors.sch, Fuzz.kicad_pcb, Fuzz.sch, FuzzMcu (2).sch, FuzzMcu.sch, FuzzRouting.sch, Mcu.sch, PowerRegulator.sch]
2020-04-06 PCB fixes
    [Capacitors.sch, Fuzz.kicad_pcb, Fuzz.sch, Mcu.sch, PowerRegulator.sch, ShiftRegisters.sch, Transistors.sch, UI.sch]
2020-04-06 Changed power supply
    [Capacitors.sch, PowerRegulator.sch]
2020-04-06 Improved PCB SPI/I2C lines
    [Fuzz.kicad_pcb]
2020-04-06 Fixed unconnected PCB traces
    [Fuzz.kicad_pcb]
2020-04-07 Schematics UI/MCU -> MCU + PCB improvements
    [Capacitors.sch, Fuzz.kicad_pcb, Fuzz.sch, Mcu.sch, PowerRegulator.sch, ShiftRegisters.sch, Transistors.sch, UI.sch]
2020-04-08 Power regulator -9V
    [Capacitors.sch, Fuzz.sch, PowerRegulator.sch, Transistors.sch]
2020-04-10 PCB Placement 100x82
    [AudioInOut.sch, Capacitors.sch, Fuzz.kicad_pcb, Fuzz.sch, LevelShifter.sch, Mcu.sch, PowerRegulator.sch, ShiftRegisters.sch]
2020-04-11 Starting to route
    [AudioInOut.sch, Capacitors.sch, Fuzz.kicad_pcb, Mcu.sch, Transistors.sch]
2020-04-12 More traces
    [Fuzz.kicad_pcb]
2020-04-12 Transistors C almost done
    [Fuzz.kicad_pcb]
2020-04-12 Routing finished, todo: AGND
    [Fuzz.kicad_pcb]
2020-04-13 GNDA, PCB DRC fixed
    [Capacitors.sch, Fuzz.kicad_pcb, Fuzz.sch, PowerRegulator.sch, ShiftRegisters.sch]
2020-04-13 DRC OK
    [Fuzz.kicad_pcb]
2020-04-13 Removed DRC errors, added logos
    [Fuzz.kicad_pcb]
2020-04-18 Analysis microcap
    [Fuzz.kicad_pcb]
2020-04-20 New Kicad project (16 mux)
    [AudioInOut.sch, Capacitors.sch, Fuzz.kicad_pcb, Fuzz.sch, FuzzMcu (2).sch, FuzzMcu.sch, FuzzRouting.sch, LevelShifter.sch]
2020-04-20 Removed shift registers
    [AudioInOut.sch, Capacitors.sch, Fuzz.kicad_pcb, Fuzz.sch, LevelShifter.sch, Mcu.sch, PowerRegulator.sch, Transistors.sch]
2020-04-21 Finished (but not beautiful) PCB without SPI and most 8 channel multiplexers.
    [AudioInOut.sch, Capacitors.sch, Fuzz.kicad_pcb, Fuzz.sch, LevelShifter.sch, Mcu.sch, Transistors.sch]
2020-04-24 New structure
    [AudioInOut.sch, Capacitors.sch, Fuzz.kicad_pcb, Fuzz.sch, FuzzMcu (2).sch, FuzzMcu.sch, FuzzRouting.sch, LevelShifter.sch]
2020-04-24 Test
    Test
    [Fuzz.sch]
2020-04-25 LCD backlight and backlight removed from circuit/pcb.
    [AudioInOut.sch, Fuzz.kicad_pcb, Fuzz.sch, Mcu.sch]
2020-04-25 PCB Logo/texts
    [AudioInOut.sch, Capacitors.sch, Fuzz.kicad_pcb, LevelShifter.sch, Transistors.sch]
2020-04-26 EEprom + PCB changes
    [Capacitors.sch, Fuzz.kicad_pcb, Fuzz.sch, Mcu.sch, Transistors.sch]
2020-04-26 logo, capacitors
    Logo, removed capacitors location, added fuz capcitors to back. TODO: change capacitors bank A.
    [Fuzz.kicad_pcb]
2020-04-26 PCB and code
    Some PCB changes.
    HalUtils, multiplexer code, component code.
    [Fuzz.kicad_pcb]
2020-05-05 PCB mostly
    [AudioInOut.sch, Capacitors.sch, Fuzz.kicad_pcb, Fuzz.sch, FuzzEnclosure.kicad_pcb, FuzzEnclosure.sch, LevelShifter.sch, Mcu.sch]
2020-05-06 Code + resistors
    Many code changes (UI) + resistors -> pulldowns.
    [Capacitors.sch, Fuzz.kicad_pcb, Mcu.sch, PowerRegulator.sch, Transistors.sch]
2020-05-07 Fixed store problem
    [Fuzz.kicad_pcb]
2020-05-08 Changed name (Michel Keijzers), relayout
2020-05-10 Fixed max virtual addresses for eeprom
    [BaseButton.cpp, Eeprom.cpp]
2020-05-10 25K->16K Fuzz
    [Fuzz.kicad_pcb]
2020-05-19 Improvements according video youtube
    [AudioInOut.sch, Capacitors.sch, Fuzz.kicad_pcb, Fuzz.sch, LevelShifter.sch, Mcu.sch, PowerRegulator.sch, Transistors.sch]
2020-05-21 UART, BOOT, NRST, Isolated OSC gnd
    [AudioInOut.sch, Capacitors.sch, Fuzz.kicad_pcb, LevelShifter.sch, Mcu.sch]
2020-05-21 Thicker I2C trace
    [Fuzz.kicad_pcb]
2020-05-27 Various
    Various
    [Fuzz.kicad_pcb, PowerRegulator.sch]
2020-05-28 STM32 DevBoard in Freecad
    [Capacitors.sch, Fuzz.kicad_pcb, Mcu.sch]
2020-05-28 Kicad 3_STM32DevBoard
    [AudioInOut.sch, Capacitors.sch, Fuzz.kicad_pcb, Fuzz.sch, FuzzEnclosure.kicad_pcb, FuzzEnclosure.sch, FuzzMcu (2).sch, FuzzMcu.sch]
2020-05-29 STM32 Dev Board
    [Fuzz.kicad_pcb, Mcu.sch, PowerRegulator.sch]
2020-05-29 git ignore
    [Fuzz.kicad_pcb]
2020-05-30 Remove 3V3 voltage regulation (get from STM32 5V)
    [Fuzz.kicad_pcb, LevelShifter.sch, Mcu.sch, PowerRegulator.sch]
