michelkeijzers/FuzzTester2/(notices)

Notices in the files:
FuzzTester2/Core/Inc/main.h:
(C) COPYRIGHT STMicroelectronics *****END OF FILE
Kicad/3_Stm32DevBoard/Fuzz.kicad_pcb:
©2020
©2020 MICHEL KEIJZERS
